jonthomasson/SpartanMini/rev1.d (with shield 3d)/Spartan6Dev2.png

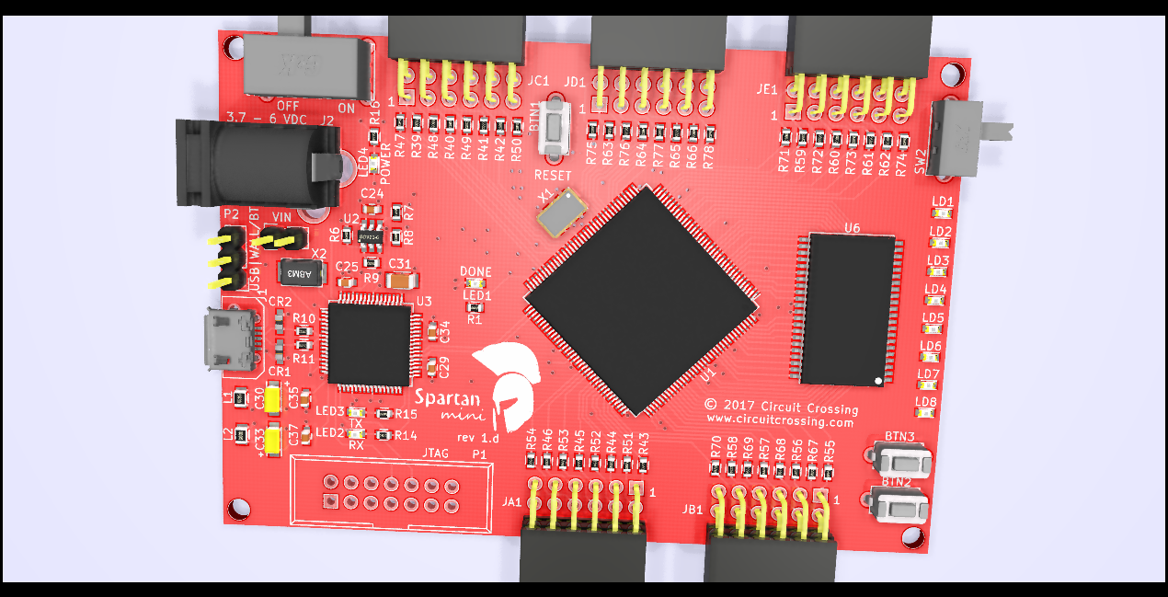
rev1.d (with shield 3d)/Spartan6Dev2.png
