jonthomasson/SpartanMini/rev1.d (with shield 3d)/SpartanMini1.png

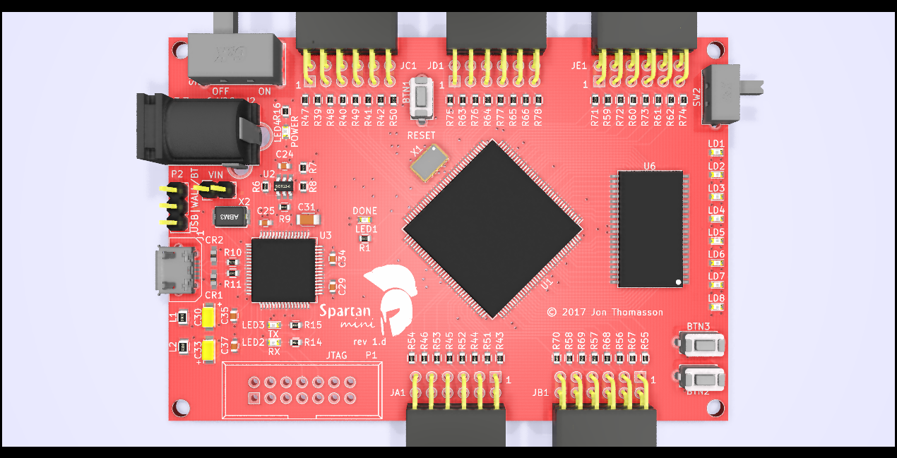
rev1.d (with shield 3d)/SpartanMini1.png
