jonthomasson/SpartanMini/rev1.d (with shield 3d)/Xilinx/NES/luddes_nes/luddes_nes/handyvgs2/loader/BISTio/README

BISTio Library
=======================

This library wraps the digilent ADEPT driver.  The goal is to have a a c++ dll that provides
a simple interface to boundary scan and a simple SPI.
