jonthomasson/SpartanMini/rev1.d (with shield 3d)/Xilinx/NES/luddes_nes/luddes_nes/handyvgs2/loader/BISTio/BISTio/README

A C++ DLL which provides an easy interface to performing JTAG operations using the Digilient adept driver
