jonthomasson/SpartanMini/rev1.d (with shield 3d)/usb/playtag-master/doc/digilent_hs2_connections.pdf

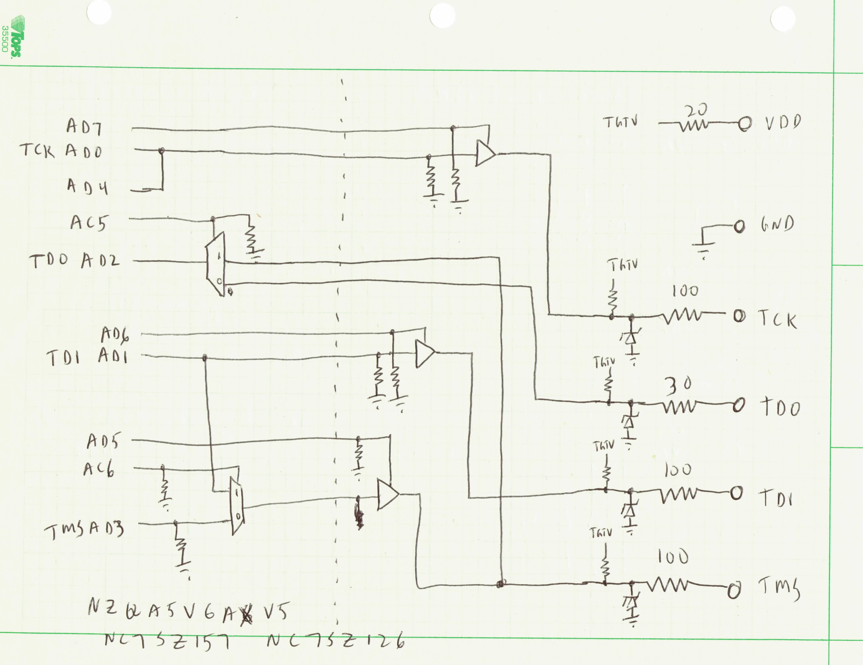
[picture p3: page 1]
