jonthomasson/SpartanMini/rev1.d (with shield 3d)/Spartan6DevWShield.png

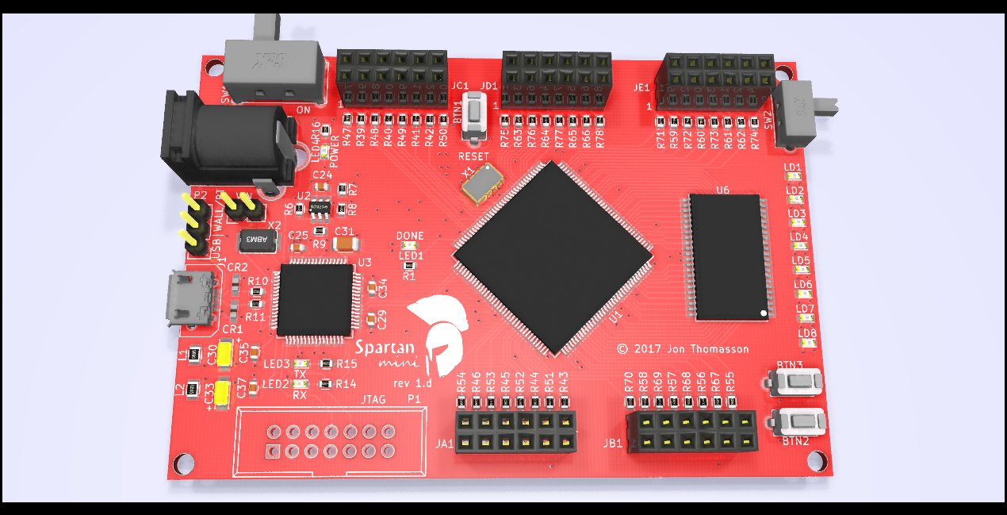
rev1.d (with shield 3d)/Spartan6DevWShield.png
