jonthomasson/SpartanMini/rev1.d (with shield 3d)/SpartanMini2.png

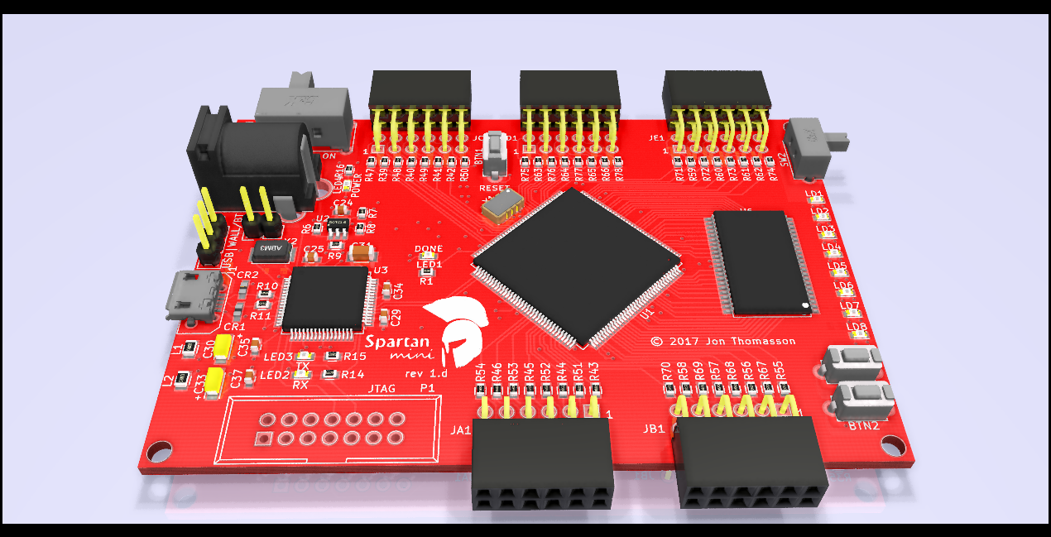
rev1.d (with shield 3d)/SpartanMini2.png
