jonthomasson/SpartanMini/rev1.d (with shield 3d)/SpartanMiniPcb.PNG

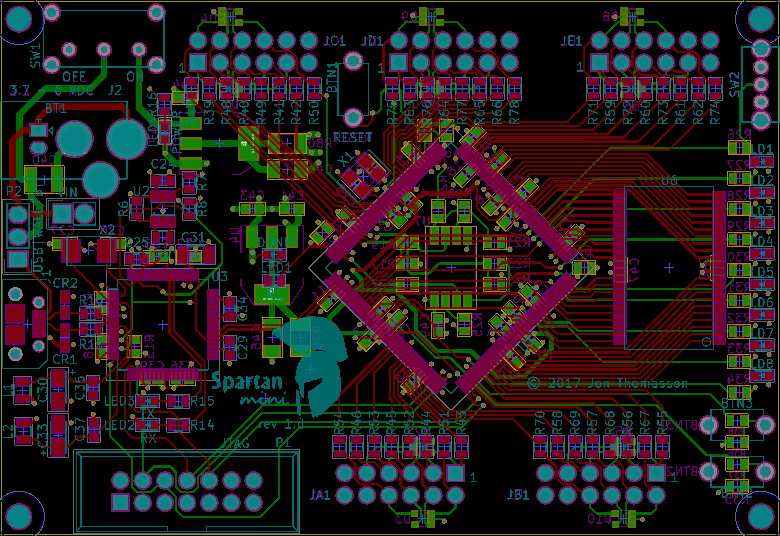
rev1.d (with shield 3d)/SpartanMiniPcb.PNG
