jonthomasson/SpartanMini/rev1.d/TemplateProject/spartanmini-shieldwpower/meta/brd.PNG

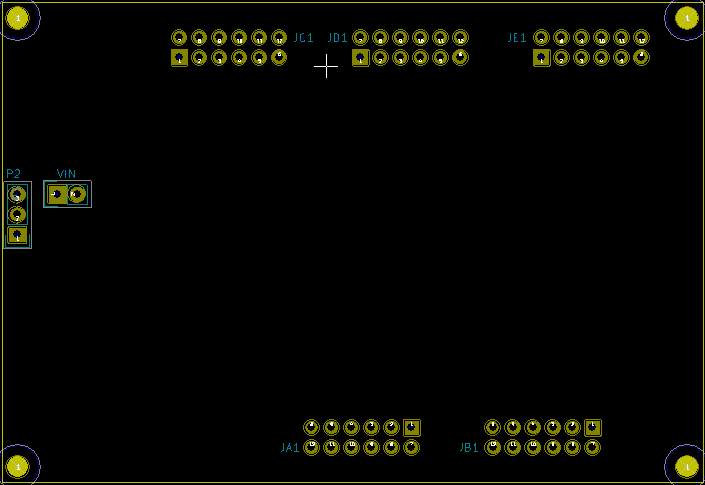
rev1.d/TemplateProject/spartanmini-shieldwpower/meta/brd.PNG
