jonthomasson/SpartanMini/rev1.d (with shield 3d)/3dmodels/IND_PGB_0603.stp

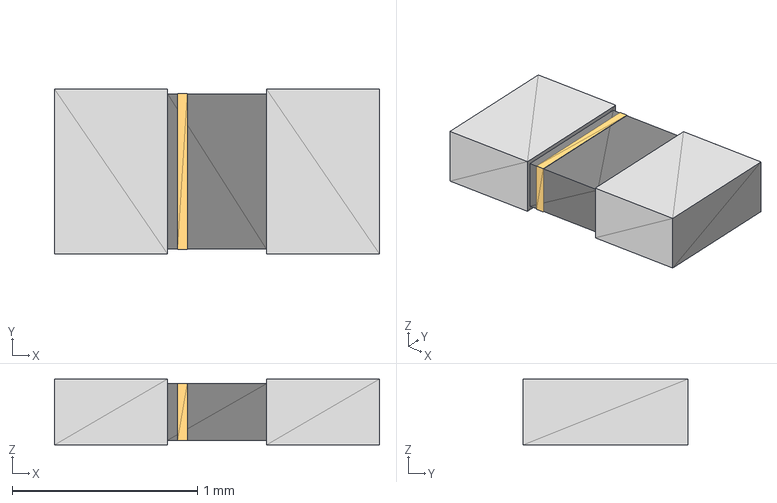
[picture p9: CAD file, 2017-04-20]
rev1.d (with shield 3d)/3dmodels/IND_PGB_0603.stp
1.75 x 0.889 x 0.356 mm
