jonthomasson/SpartanMini/rev1.d (with shield 3d)/3dmodels/abm3_rev2.stp

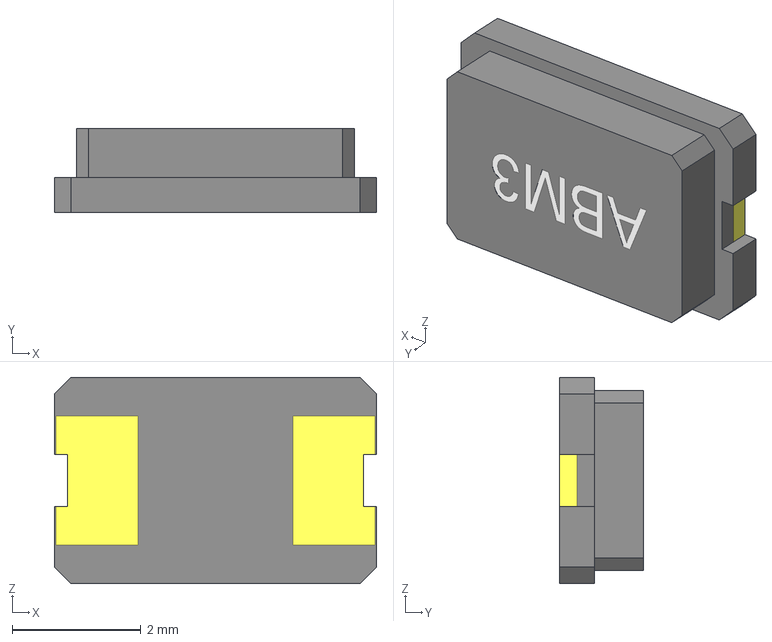
[picture p10: CAD file, 2017-04-20]
rev1.d (with shield 3d)/3dmodels/abm3_rev2.stp
5.00 x 1.30 x 3.20 mm
