jonthomasson/SpartanMini/rev1.d (with shield 3d)/3dmodels/500SSPxS2M2xEA.stp

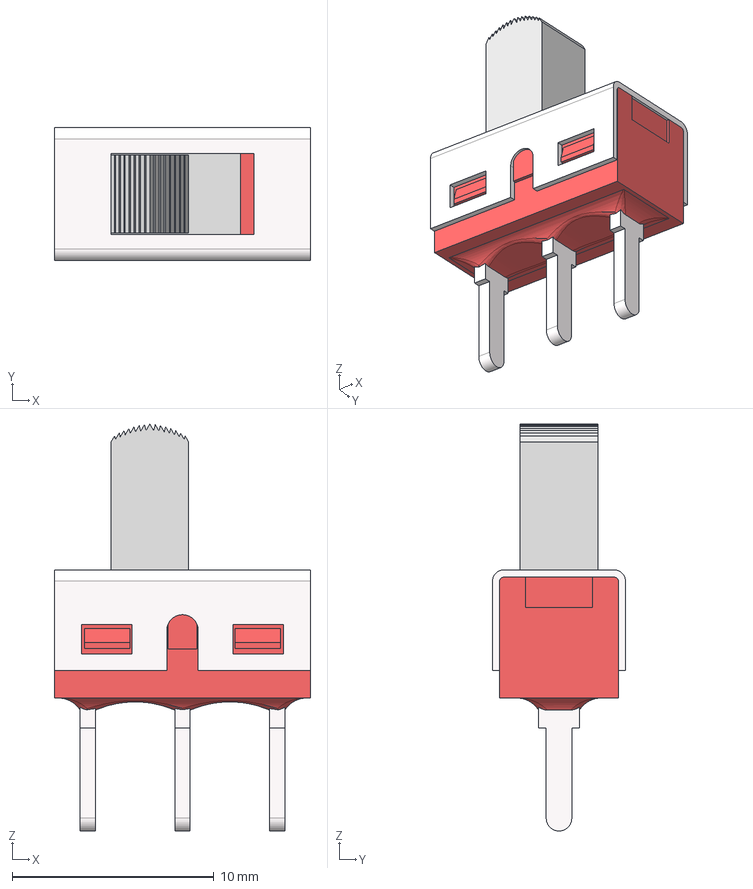
[picture p11: CAD file, 2017-04-20]
rev1.d (with shield 3d)/3dmodels/500SSPxS2M2xEA.stp
12.7 x 6.60 x 20.2 mm
500 SSP BODY
500 SSP COVER
500 ACTUATOR S2
500 SSP M2
