jonthomasson/SpartanMini/rev1.d (with shield 3d)/3dmodels/PTS810.stp

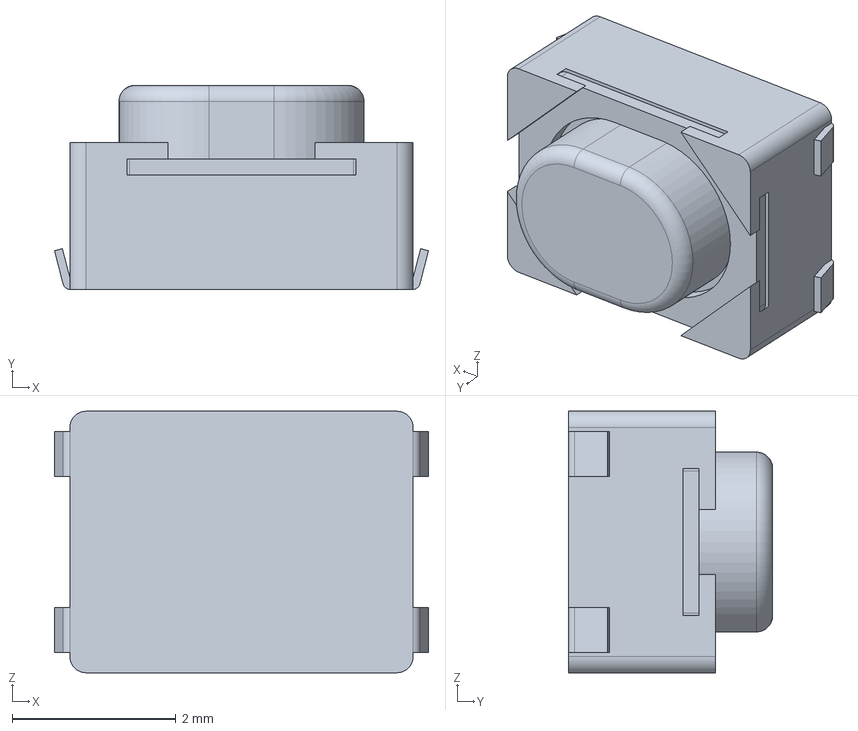
[picture p12: CAD file, 2017-04-20]
rev1.d (with shield 3d)/3dmodels/PTS810.stp
4.58 x 2.50 x 3.20 mm
