jonthomasson/SpartanMini/rev1.d (with shield 3d)/3dmodels/l102021ml04.stp

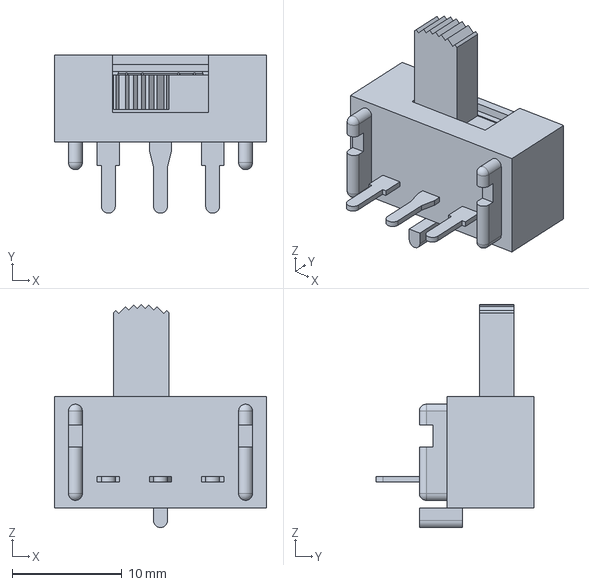
[picture p13: CAD file, 2017-04-20]
rev1.d (with shield 3d)/3dmodels/l102021ml04.stp
19.3 x 14.4 x 20.3 mm
