jonthomasson/SpartanMini/rev1.d (with shield 3d)/3dmodels/10118194c.stp

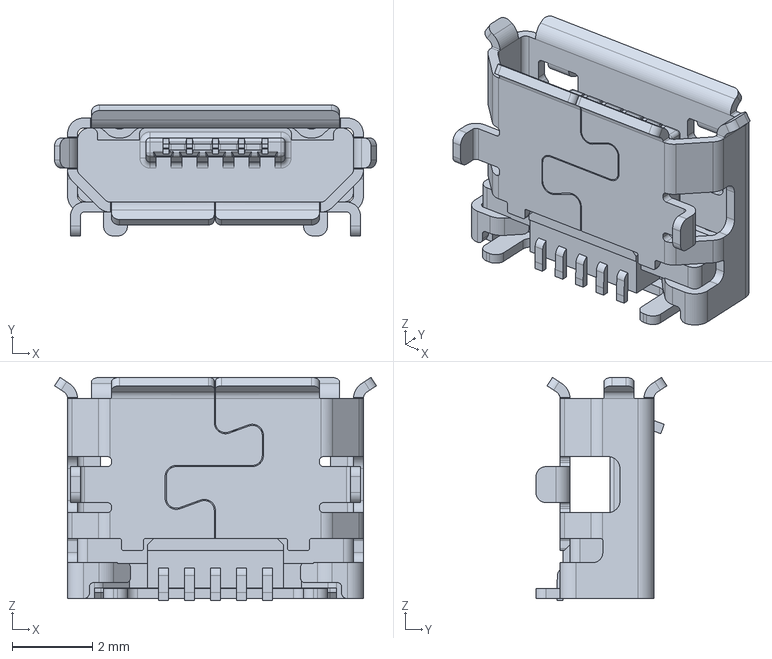
[picture p14: CAD file, 2017-04-20]
rev1.d (with shield 3d)/3dmodels/10118194c.stp
8.05 x 3.27 x 5.58 mm
