jonthomasson/SpartanMini/rev1.d (with shield 3d)/3dmodels/1825966-1.stp

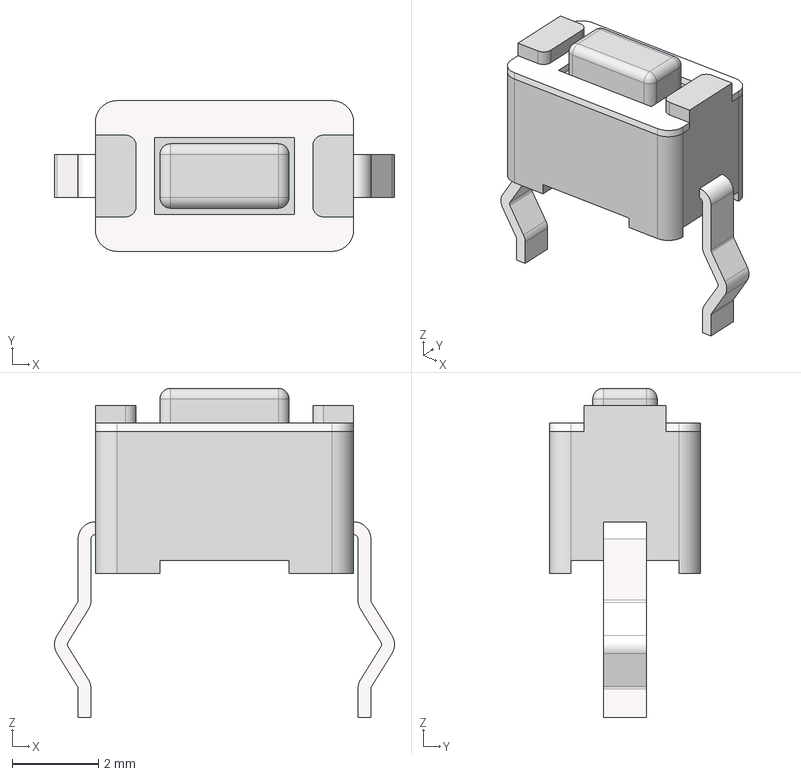
[picture p15: CAD file, 2017-04-20]
rev1.d (with shield 3d)/3dmodels/1825966-1.stp
7.90 x 3.50 x 7.65 mm
TL1107-3302 BODY
TL1107-3302 COVER
TL1107 W TERM
TL1107-3302 A ACTUATOR
TL1107 W TERM_MIR
