jonthomasson/SpartanMini/rev1.d (with shield 3d)/3dmodels/os102011ms2qn1_093011.stp

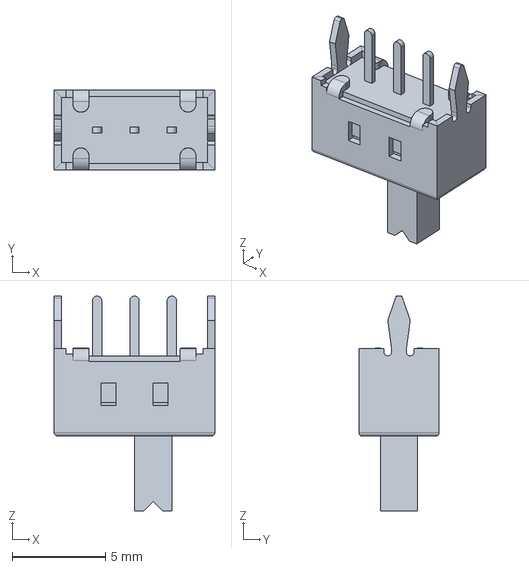
[picture p16: CAD file, 2017-04-20]
rev1.d (with shield 3d)/3dmodels/os102011ms2qn1_093011.stp
8.60 x 4.30 x 11.5 mm
