jonthomasson/SpartanMini/rev1.d (with shield 3d)/3dmodels/os102011ma1qn1_093011.stp

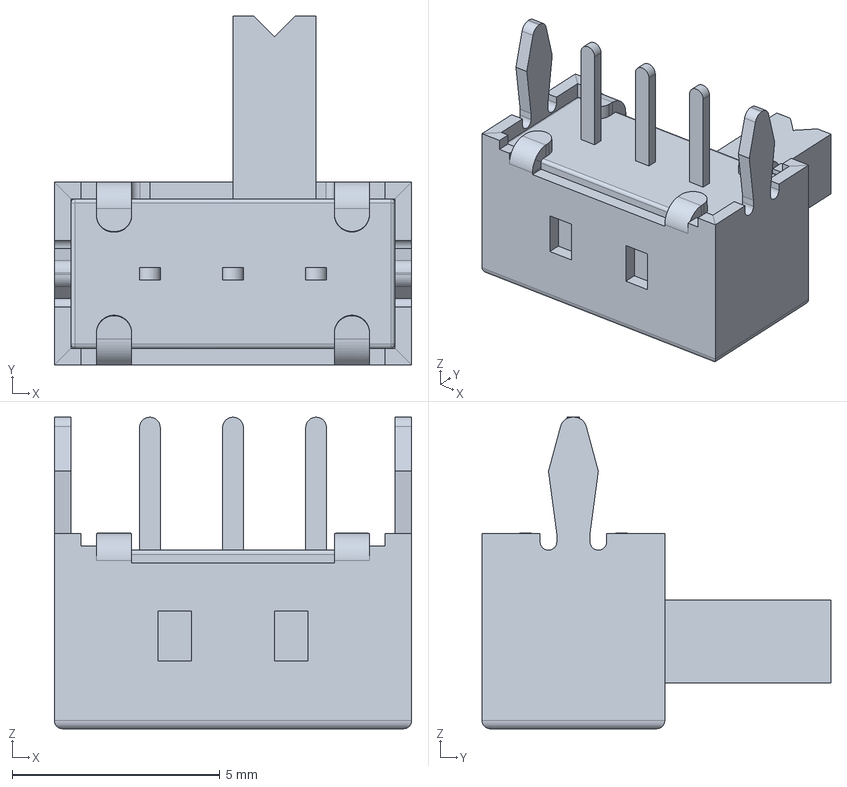
[picture p17: CAD file, 2017-04-20]
rev1.d (with shield 3d)/3dmodels/os102011ma1qn1_093011.stp
8.60 x 8.40 x 7.50 mm
