jonthomasson/SpartanMini/(list of files, cad)

Other CAD files:
rev1.d (with shield 3d)/3dmodels/ABM3.STEP
