jonthomasson/SpartanMini/rev1.d (with shield 3d)/Xilinx/blink_led/usage_statistics_webtalk.html

### Device Usage Page (usage_statistics_webtalk.html)

This HTML page displays the device usage statistics that will be sent to Xilinx.

Software Version and Target Device
Product Version: | ISE:14.7 (WebPack) - P.20131013 | Target Family: | Spartan6
OS Platform: | NT64 | Target Device: | xc6slx9
Project ID (random number) | 80e5f5d7cab04d32b9649c2cde710933.15AE8DC6CFC14A00AB5B0725C5DFFF0C.8 | Target Package: | tqg144
Registration ID | 211027110_0_0_178 | Target Speed: | -2
Date Generated | 2017-10-11T22:11:20 | Tool Flow | ISE

User Environment
OS Name | Microsoft Windows 7 , 64-bit | OS Release | Service Pack 1 (build 7601)
CPU Name | Intel(R) Core(TM)2 Duo CPU T8300 @ 2.40GHz | CPU Speed | 2394 MHz
OS Name | Microsoft Windows 7 , 64-bit | OS Release | Service Pack 1 (build 7601)
CPU Name | Intel(R) Core(TM)2 Duo CPU T8300 @ 2.40GHz | CPU Speed | 2394 MHz

Device Usage Statistics
Macro Statistics | Miscellaneous Statistics | Net Statistics | Site Usage

Counters=1

32-bit up counter=1

MiscellaneousStatistics

AGG_BONDED_IO=10

AGG_IO=10

AGG_LOCED_IO=10

AGG_SLICE=7

NUM_BONDED_IOB=10

NUM_BSFULL=25

NUM_BSUSED=25

NUM_BUFG=1

NUM_LOCED_IOB=10

NUM_LOGIC_O5ANDO6=1

NUM_LOGIC_O5ONLY=23

NUM_LUT_RT_DRIVES_CARRY4=1

NUM_LUT_RT_EXO6=1

NUM_LUT_RT_O6=23

NUM_SLICEL=7

NUM_SLICE_CARRY4=7

NUM_SLICE_CONTROLSET=1

NUM_SLICE_CYINIT=50

NUM_SLICE_FF=25

NUM_UNUSABLE_FF_BELS=7

NetStatistics

NumNets_Active=43

NumNets_Gnd=1

NumNets_Vcc=1

NumNodesOfType_Active_BOUNCEIN=6

NumNodesOfType_Active_BUFGOUT=1

NumNodesOfType_Active_BUFHINP2OUT=1

NumNodesOfType_Active_CLKPIN=7

NumNodesOfType_Active_CLKPINFEED=1

NumNodesOfType_Active_DOUBLE=2

NumNodesOfType_Active_GENERIC=2

NumNodesOfType_Active_GLOBAL=9

NumNodesOfType_Active_INPUT=7

NumNodesOfType_Active_IOBIN2OUT=1

NumNodesOfType_Active_IOBOUTPUT=1

NumNodesOfType_Active_LUTINPUT=25

NumNodesOfType_Active_OUTBOUND=25

NumNodesOfType_Active_OUTPUT=32

NumNodesOfType_Active_PADINPUT=1

NumNodesOfType_Active_PADOUTPUT=1

NumNodesOfType_Active_PINBOUNCE=6

NumNodesOfType_Active_PINFEED=34

NumNodesOfType_Active_QUAD=3

SiteStatistics

BUFG-BUFGMUX=1

IOB-IOBM=5

IOB-IOBS=5

SiteSummary

BUFG=1

BUFG_BUFG=1

CARRY4=7

HARD0=1

IOB=10

IOB_IMUX=1

IOB_INBUF=1

IOB_OUTBUF=9

LUT5=24

LUT6=25

PAD=10

REG_SR=25

SLICEL=7

Configuration Data
IOB_OUTBUF DRIVEATTRBOX=[12:9] SLEW=[SLOW:9] SUSPEND=[3STATE:9] | REG_SR CK=[CK:25] [CK_INV:0] LATCH_OR_FF=[FF:25] SRINIT=[SRINIT0:25] SYNC_ATTR=[ASYNC:25] | SLICEL CLK=[CLK:7] [CLK_INV:0]

Pin Data
BUFG I0=1 O=1 BUFG_BUFG I0=1 O=1 CARRY4 CIN=6 CO3=6 CYINIT=1 DI0=6 DI1=6 DI2=6 DI3=6 O0=7 O1=6 O2=6 O3=6 S0=7 S1=6 S2=6 S3=6 | HARD0 0=1 IOB I=1 O=9 PAD=10 IOB_IMUX I=1 OUT=1 IOB_INBUF OUT=1 PAD=1 IOB_OUTBUF IN=9 OUT=9 LUT5 O5=24 LUT6 A4=25 A6=24 O6=25 | PAD PAD=10 REG_SR CK=25 D=25 Q=25 SLICEL A4=7 A6=6 AQ=7 B4=6 B6=6 BQ=6 C4=6 C6=6 CIN=6 CLK=7 COUT=6 CQ=6 D4=6 D6=6 DQ=6

Tool Usage

Command Line History

xst -intstyle ise -filter <ise_file>

ngdbuild -filter <ise_file> -intstyle ise -dd _ngo -nt timestamp -i -p xc6slx9-tqg144-2 <fname>.ngc <fname>.ngd

ngdbuild -filter <ise_file> -intstyle ise -dd _ngo -nt timestamp -i -p xc6slx9-tqg144-2 <fname>.ngc <fname>.ngd

xst -intstyle ise -filter <ise_file>

xst -intstyle ise -filter <ise_file>

ngdbuild -filter <ise_file> -intstyle ise -dd _ngo -nt timestamp -i -p xc6slx9-tqg144-2 <fname>.ngc <fname>.ngd

map -filter <ise_file> -intstyle ise -p xc6slx9-tqg144-2 -w -logic_opt off -ol high -t 1 -xt 0 -register_duplication off -r 4 -global_opt off -mt off -ir off -pr off -lc off -power off -o <fname>.ncd <fname>.ngd <fname>.pcf

par -filter <ise_file> -w -intstyle ise -ol high -mt off <fname>.ncd <fname>.ncd <fname>.pcf

trce -filter <fname>.filter -intstyle ise -v 3 -s 2 -n 3 -fastpaths -xml <fname>.twx <fname>.ncd -o <fname>.twr <fname>.pcf

bitgen -filter <ise_file> -intstyle ise -f <fname>.ut <fname>.ncd

xst -intstyle ise -filter <ise_file>

ngdbuild -filter <ise_file> -intstyle ise -dd _ngo -nt timestamp -uc <fname>.ucf -p xc6slx9-tqg144-2 <fname>.ngc <fname>.ngd

map -filter <ise_file> -intstyle ise -p xc6slx9-tqg144-2 -w -logic_opt off -ol high -t 1 -xt 0 -register_duplication off -r 4 -global_opt off -mt off -ir off -pr off -lc off -power off -o <fname>.ncd <fname>.ngd <fname>.pcf

par -filter <ise_file> -w -intstyle ise -ol high -mt off <fname>.ncd <fname>.ncd <fname>.pcf

trce -filter <fname>.filter -intstyle ise -v 3 -s 2 -n 3 -fastpaths -xml <fname>.twx <fname>.ncd -o <fname>.twr <fname>.pcf -ucf <fname>.ucf

bitgen -filter <ise_file> -intstyle ise -f <fname>.ut <fname>.ncd

xst -intstyle ise -filter <ise_file>

ngdbuild -filter <ise_file> -intstyle ise -dd _ngo -nt timestamp -uc <fname>.ucf -p xc6slx9-tqg144-2 <fname>.ngc <fname>.ngd

map -filter <ise_file> -intstyle ise -p xc6slx9-tqg144-2 -w -logic_opt off -ol high -t 1 -xt 0 -register_duplication off -r 4 -global_opt off -mt off -ir off -pr off -lc off -power off -o <fname>.ncd <fname>.ngd <fname>.pcf

par -filter <ise_file> -w -intstyle ise -ol high -mt off <fname>.ncd <fname>.ncd <fname>.pcf

trce -filter <fname>.filter -intstyle ise -v 3 -s 2 -n 3 -fastpaths -xml <fname>.twx <fname>.ncd -o <fname>.twr <fname>.pcf -ucf <fname>.ucf

bitgen -filter <ise_file> -intstyle ise -f <fname>.ut <fname>.ncd

xst -intstyle ise -filter <ise_file>

ngdbuild -filter <ise_file> -intstyle ise -dd _ngo -nt timestamp -uc <fname>.ucf -p xc6slx9-tqg144-2 <fname>.ngc <fname>.ngd

map -filter <ise_file> -intstyle ise -p xc6slx9-tqg144-2 -w -logic_opt off -ol high -t 1 -xt 0 -register_duplication off -r 4 -global_opt off -mt off -ir off -pr off -lc off -power off -o <fname>.ncd <fname>.ngd <fname>.pcf

par -filter <ise_file> -w -intstyle ise -ol high -mt off <fname>.ncd <fname>.ncd <fname>.pcf

trce -filter <fname>.filter -intstyle ise -v 3 -s 2 -n 3 -fastpaths -xml <fname>.twx <fname>.ncd -o <fname>.twr <fname>.pcf -ucf <fname>.ucf

bitgen -filter <ise_file> -intstyle ise -f <fname>.ut <fname>.ncd

bitgen -filter <ise_file> -intstyle ise -f <fname>.ut <fname>.ncd

xst -intstyle ise -filter <ise_file>

ngdbuild -filter <ise_file> -intstyle ise -dd _ngo -nt timestamp -uc <fname>.ucf -p xc6slx9-tqg144-2 <fname>.ngc <fname>.ngd

map -filter <ise_file> -intstyle ise -p xc6slx9-tqg144-2 -w -logic_opt off -ol high -t 1 -xt 0 -register_duplication off -r 4 -global_opt off -mt off -ir off -pr off -lc off -power off -o <fname>.ncd <fname>.ngd <fname>.pcf

par -filter <ise_file> -w -intstyle ise -ol high -mt off <fname>.ncd <fname>.ncd <fname>.pcf

trce -filter <fname>.filter -intstyle ise -v 3 -s 2 -n 3 -fastpaths -xml <fname>.twx <fname>.ncd -o <fname>.twr <fname>.pcf -ucf <fname>.ucf

bitgen -filter <ise_file> -intstyle ise -f <fname>.ut <fname>.ncd

xst -intstyle ise -filter <ise_file>

ngdbuild -filter <ise_file> -intstyle ise -dd _ngo -nt timestamp -uc <fname>.ucf -p xc6slx9-tqg144-2 <fname>.ngc <fname>.ngd

map -filter <ise_file> -intstyle ise -p xc6slx9-tqg144-2 -w -logic_opt off -ol high -t 1 -xt 0 -register_duplication off -r 4 -global_opt off -mt off -ir off -pr off -lc off -power off -o <fname>.ncd <fname>.ngd <fname>.pcf

par -filter <ise_file> -w -intstyle ise -ol high -mt off <fname>.ncd <fname>.ncd <fname>.pcf

trce -filter <fname>.filter -intstyle ise -v 3 -s 2 -n 3 -fastpaths -xml <fname>.twx <fname>.ncd -o <fname>.twr <fname>.pcf -ucf <fname>.ucf

bitgen -filter <ise_file> -intstyle ise -f <fname>.ut <fname>.ncd

xst -intstyle ise -filter <ise_file>

ngdbuild -filter <ise_file> -intstyle ise -dd _ngo -nt timestamp -uc <fname>.ucf -p xc6slx9-tqg144-2 <fname>.ngc <fname>.ngd

map -filter <ise_file> -intstyle ise -p xc6slx9-tqg144-2 -w -logic_opt off -ol high -t 1 -xt 0 -register_duplication off -r 4 -global_opt off -mt off -ir off -pr off -lc off -power off -o <fname>.ncd <fname>.ngd <fname>.pcf

par -filter <ise_file> -w -intstyle ise -ol high -mt off <fname>.ncd <fname>.ncd <fname>.pcf

trce -filter <fname>.filter -intstyle ise -v 3 -s 2 -n 3 -fastpaths -xml <fname>.twx <fname>.ncd -o <fname>.twr <fname>.pcf -ucf <fname>.ucf

bitgen -filter <ise_file> -intstyle ise -f <fname>.ut <fname>.ncd

xst -intstyle ise -filter <ise_file>

ngdbuild -filter <ise_file> -intstyle ise -dd _ngo -nt timestamp -uc <fname>.ucf -p xc6slx9-tqg144-2 <fname>.ngc <fname>.ngd

map -filter <ise_file> -intstyle ise -p xc6slx9-tqg144-2 -w -logic_opt off -ol high -t 1 -xt 0 -register_duplication off -r 4 -global_opt off -mt off -ir off -pr off -lc off -power off -o <fname>.ncd <fname>.ngd <fname>.pcf

par -filter <ise_file> -w -intstyle ise -ol high -mt off <fname>.ncd <fname>.ncd <fname>.pcf

trce -filter <fname>.filter -intstyle ise -v 3 -s 2 -n 3 -fastpaths -xml <fname>.twx <fname>.ncd -o <fname>.twr <fname>.pcf -ucf <fname>.ucf

bitgen -filter <ise_file> -intstyle ise -f <fname>.ut <fname>.ncd

Software Quality
Run Statistics
Program Name | Runs Started | Runs Finished | Errors | Fatal Errors | Internal Errors | Exceptions | Core Dumps
_impact | 297 | 239 | 0 | 0 | 0 | 0 | 0
bitgen | 617 | 614 | 0 | 0 | 0 | 0 | 0
cse_server | 1 | 1 | 0 | 0 | 0 | 0 | 0
elfcheck | 48 | 48 | 0 | 0 | 0 | 0 | 0
libgen | 1 | 1 | 0 | 0 | 0 | 0 | 0
map | 628 | 598 | 0 | 0 | 0 | 0 | 0
netgen | 9 | 9 | 0 | 0 | 0 | 0 | 0
ngcbuild | 15 | 15 | 0 | 0 | 0 | 0 | 0
ngdbuild | 665 | 663 | 0 | 0 | 0 | 0 | 0
par | 598 | 598 | 0 | 0 | 0 | 0 | 0
trce | 592 | 592 | 0 | 0 | 0 | 0 | 0
xps | 1 | 1 | 0 | 0 | 0 | 0 | 0
xst | 906 | 895 | 0 | 0 | 0 | 0 | 0

Help Statistics
Help files
/doc/usenglish/isehelp/cgn_c_cust_gui_overview.htm ( 1 ) | /doc/usenglish/isehelp/ise_r_source_types.htm ( 1 )
/doc/usenglish/isehelp/pn_db_nsw_define_hdl_module.htm ( 1 ) | /doc/usenglish/isehelp/pn_db_nsw_select_source_type.htm ( 1 )

Project Statistics
PROP_Enable_Message_Filtering=true | PROP_FitterReportFormat=HTML
PROP_LastAppliedGoal=Balanced | PROP_LastAppliedStrategy=Xilinx Default (unlocked)
PROP_ManualCompileOrderImp=false | PROP_ProjectDescription=blink one of the onboard leds.
PROP_PropSpecInProjFile=Store all values | PROP_Simulator=ISim (VHDL/Verilog)
PROP_SynthTopFile=changed | PROP_Top_Level_Module_Type=HDL
PROP_UseSmartGuide=false | PROP_UserConstraintEditorPreference=Text Editor
PROP_intProjectCreationTimestamp=2017-10-10T13:54:07 | PROP_intWbtProjectID=15AE8DC6CFC14A00AB5B0725C5DFFF0C
PROP_intWbtProjectIteration=8 | PROP_intWorkingDirLocWRTProjDir=Same
PROP_intWorkingDirUsed=No | PROP_lockPinsUcfFile=changed
PROP_xilxBitgCfg_SpiBusWidth_spartan6=4 | PROP_xilxBitgStart_IntDone=true
PROP_AutoTop=true | PROP_DevFamily=Spartan6
PROP_DevDevice=xc6slx9 | PROP_DevFamilyPMName=spartan6
PROP_DevPackage=tqg144 | PROP_Synthesis_Tool=XST (VHDL/Verilog)
PROP_DevSpeed=-2 | PROP_PreferredLanguage=Verilog
FILE_UCF=1 | FILE_VERILOG=1

Unisim Statistics
NGDBUILD_PRE_UNISIM_SUMMARY
NGDBUILD_NUM_BUFGP=1 | NGDBUILD_NUM_FD=25 | NGDBUILD_NUM_GND=1 | NGDBUILD_NUM_INV=1
NGDBUILD_NUM_LUT1=24 | NGDBUILD_NUM_MUXCY=24 | NGDBUILD_NUM_OBUF=9 | NGDBUILD_NUM_VCC=1

NGDBUILD_NUM_XORCY=25
NGDBUILD_POST_UNISIM_SUMMARY
NGDBUILD_NUM_BUFG=1 | NGDBUILD_NUM_FD=25 | NGDBUILD_NUM_GND=1 | NGDBUILD_NUM_IBUFG=1
NGDBUILD_NUM_INV=1 | NGDBUILD_NUM_LUT1=24 | NGDBUILD_NUM_MUXCY=24 | NGDBUILD_NUM_OBUF=9
NGDBUILD_NUM_TS_TIMESPEC=1 | NGDBUILD_NUM_VCC=1 | NGDBUILD_NUM_XORCY=25

XST Command Line Options
XST_OPTION_SUMMARY
-ifn=<fname>.prj | -ofn=<design_top> | -ofmt=NGC | -p=xc6slx9-2-tqg144
-top=<design_top> | -opt_mode=Speed | -opt_level=1 | -power=NO
-iuc=NO | -keep_hierarchy=No | -netlist_hierarchy=As_Optimized | -rtlview=Yes
-glob_opt=AllClockNets | -read_cores=YES | -write_timing_constraints=NO | -cross_clock_analysis=NO
-bus_delimiter=<> | -slice_utilization_ratio=100 | -bram_utilization_ratio=100 | -dsp_utilization_ratio=100
-reduce_control_sets=Auto | -fsm_extract=YES | -fsm_encoding=Auto | -safe_implementation=No
-fsm_style=LUT | -ram_extract=Yes | -ram_style=Auto | -rom_extract=Yes
-shreg_extract=YES | -rom_style=Auto | -auto_bram_packing=NO | -resource_sharing=YES
-async_to_sync=NO | -use_dsp48=Auto | -iobuf=YES | -max_fanout=100000
-bufg=16 | -register_duplication=YES | -register_balancing=No | -optimize_primitives=NO
-use_clock_enable=Auto | -use_sync_set=Auto | -use_sync_reset=Auto | -iob=Auto
-equivalent_register_removal=YES | -slice_utilization_ratio_maxmargin=5
