jonthomasson/SpartanMini/rev1.d (with shield 3d)/Xilinx/blink_led/par_usage_statistics.html

Par Statistics

Total Non-vccgnd Signals=33

Total Non-vccgnd Design Pins=40

Total Non-vccgnd Conns=40

Total Non-vccgnd Timing Constrained Conns=39

Phase 1 CPU=5.0 sec

Phase 2 CPU=5.1 sec

Phase 3 CPU=5.1 sec

Phase 4 CPU=5.7 sec

Phase 5 CPU=5.8 sec

Phase 6 CPU=5.8 sec

Phase 7 CPU=5.8 sec

Phase 8 CPU=5.8 sec

Phase 9 CPU=5.8 sec

Phase 10 CPU=5.8 sec

AvgWirelenPerPin Fanout 1=1.0

AvgWirelenPerPin Fanout 2=7.5

AvgWirelenPerPin Fanout 3=0.0

AvgWirelenPerPin Fanout 4=0.0

AvgWirelenPerPin Fanout 10=9.8

AvgWirelenPerPin Fanout 50=0.0

AvgWirelenPerPin Fanout 100=0.0

AvgWirelenPerPin Fanout 500=0.0

AvgWirelenPerPin Fanout 5000=0.0

AvgWirelenPerPin Fanout 20000=0.0

AvgWirelenPerPin Fanout 50000=0.0

AvgWirelenPerPin Fanout 100000=0.0

IRR Gamma=1.0000
