jonthomasson/SpartanMini/rev1.d (with shield 3d)/Xilinx/pong_text/par_usage_statistics.html

Par Statistics

Total Non-vccgnd Signals=303

Total Non-vccgnd Design Pins=1389

Total Non-vccgnd Conns=1389

Total Non-vccgnd Timing Constrained Conns=44

Phase 1 CPU=5.2 sec

Phase 2 CPU=5.6 sec

Phase 3 CPU=6.1 sec

Phase 4 CPU=6.7 sec

Phase 5 CPU=7.2 sec

Phase 6 CPU=7.2 sec

Phase 7 CPU=7.2 sec

Phase 8 CPU=7.2 sec

Phase 9 CPU=7.2 sec

Phase 10 CPU=7.2 sec

AvgWirelenPerPin Fanout 1=3.0

AvgWirelenPerPin Fanout 2=1.0

AvgWirelenPerPin Fanout 3=3.0

AvgWirelenPerPin Fanout 4=4.3

AvgWirelenPerPin Fanout 10=4.0

AvgWirelenPerPin Fanout 50=2.9

AvgWirelenPerPin Fanout 100=0.0

AvgWirelenPerPin Fanout 500=0.0

AvgWirelenPerPin Fanout 5000=0.0

AvgWirelenPerPin Fanout 20000=0.0

AvgWirelenPerPin Fanout 50000=0.0

AvgWirelenPerPin Fanout 100000=0.0

IRR Gamma=1.1356
