jonthomasson/SpartanMini/rev1.d (with shield 3d)/Xilinx/pong_text/usage_statistics_webtalk.html

### Device Usage Page (usage_statistics_webtalk.html)

This HTML page displays the device usage statistics that will be sent to Xilinx.

Software Version and Target Device
Product Version: | ISE:14.7 (WebPack) - P.20131013 | Target Family: | Spartan6
OS Platform: | NT64 | Target Device: | xc6slx9
Project ID (random number) | 80e5f5d7cab04d32b9649c2cde710933.64A098AA588B4832964EF4F8E0BE5300.2 | Target Package: | tqg144
Registration ID | 211027110_0_0_178 | Target Speed: | -3
Date Generated | 2017-10-13T16:15:29 | Tool Flow | ISE

User Environment
OS Name | Microsoft Windows 7 , 64-bit | OS Release | Service Pack 1 (build 7601)
CPU Name | Intel(R) Core(TM)2 Duo CPU T8300 @ 2.40GHz | CPU Speed | 2394 MHz
OS Name | Microsoft Windows 7 , 64-bit | OS Release | Service Pack 1 (build 7601)
CPU Name | Intel(R) Core(TM)2 Duo CPU T8300 @ 2.40GHz | CPU Speed | 2394 MHz

Device Usage Statistics
Macro Statistics | Miscellaneous Statistics | Net Statistics | Site Usage

Adders/Subtractors=14

10-bit adder=3

10-bit addsub=1

10-bit subtractor=3

11-bit adder=2

2-bit subtractor=1

3-bit subtractor=2

4-bit adder=2

Comparators=31

10-bit comparator greater=8

10-bit comparator lessequal=18

4-bit comparator lessequal=2

5-bit comparator lessequal=2

6-bit comparator greater=1

Counters=4

1-bit up counter=1

10-bit up counter=2

7-bit down counter=1

FSMs=1 Multiplexers=46

1-bit 2-to-1 multiplexer=19

1-bit 8-to-1 multiplexer=1

10-bit 2-to-1 multiplexer=3

11-bit 2-to-1 multiplexer=3

2-bit 2-to-1 multiplexer=2

3-bit 2-to-1 multiplexer=12

32-bit 2-to-1 multiplexer=2

4-bit 2-to-1 multiplexer=4

RAMs=2

2048x8-bit single-port block Read Only RAM=1

64x5-bit single-port distributed Read Only RAM=1

Registers=66

Flip-Flops=66

MiscellaneousStatistics

AGG_BONDED_IO=9

AGG_IO=9

AGG_LOCED_IO=9

AGG_SLICE=115

NUM_BONDED_IOB=9

NUM_BSFULL=64

NUM_BSLUTONLY=209

NUM_BSREGONLY=3

NUM_BSUSED=276

NUM_BUFG=2

NUM_LOCED_IOB=9

NUM_LOGIC_O5ANDO6=78

NUM_LOGIC_O5ONLY=2

NUM_LOGIC_O6ONLY=193

NUM_LUT_RT_O6=2

NUM_RAMB16BWER=1

NUM_SLICEL=29

NUM_SLICEX=86

NUM_SLICE_CARRY4=20

NUM_SLICE_CONTROLSET=12

NUM_SLICE_CYINIT=363

NUM_SLICE_F7MUX=9

NUM_SLICE_FF=77

NUM_SLICE_UNUSEDCTRL=85

NUM_UNUSABLE_FF_BELS=59

NetStatistics

NumNets_Active=312

NumNets_Gnd=1

NumNets_Vcc=1

NumNodesOfType_Active_BOUNCEACROSS=2

NumNodesOfType_Active_BOUNCEIN=52

NumNodesOfType_Active_BUFGOUT=2

NumNodesOfType_Active_BUFHINP2OUT=8

NumNodesOfType_Active_CLKPIN=30

NumNodesOfType_Active_CLKPINFEED=12

NumNodesOfType_Active_CNTRLPIN=49

NumNodesOfType_Active_DOUBLE=552

NumNodesOfType_Active_GENERIC=12

NumNodesOfType_Active_GLOBAL=37

NumNodesOfType_Active_INPUT=22

NumNodesOfType_Active_IOBIN2OUT=8

NumNodesOfType_Active_IOBOUTPUT=8

NumNodesOfType_Active_LUTINPUT=1252

NumNodesOfType_Active_OUTBOUND=311

NumNodesOfType_Active_OUTPUT=319

NumNodesOfType_Active_PADINPUT=5

NumNodesOfType_Active_PADOUTPUT=4

NumNodesOfType_Active_PINBOUNCE=144

NumNodesOfType_Active_PINFEED=1330

NumNodesOfType_Active_QUAD=319

NumNodesOfType_Active_REGINPUT=31

NumNodesOfType_Active_SINGLE=677

NumNodesOfType_Gnd_BOUNCEIN=9

NumNodesOfType_Gnd_HGNDOUT=6

NumNodesOfType_Gnd_INPUT=15

NumNodesOfType_Gnd_PINBOUNCE=13

NumNodesOfType_Gnd_PINFEED=12

NumNodesOfType_Gnd_REGINPUT=5

NumNodesOfType_Vcc_HVCCOUT=34

NumNodesOfType_Vcc_INPUT=1

NumNodesOfType_Vcc_KVCCOUT=2

NumNodesOfType_Vcc_LUTINPUT=80

NumNodesOfType_Vcc_PINBOUNCE=2

NumNodesOfType_Vcc_PINFEED=81

NumNodesOfType_Vcc_REGINPUT=2

SiteStatistics

BUFG-BUFGMUX=2

IOB-IOBM=3

IOB-IOBS=6

SLICEL-SLICEM=9

SLICEX-SLICEL=13

SLICEX-SLICEM=23

SiteSummary

BUFG=2

BUFG_BUFG=2

CARRY4=20

FF_SR=12

HARD0=2

HARD1=8

IOB=9

IOB_IMUX=4

IOB_INBUF=4

IOB_OUTBUF=5

LUT5=80

LUT6=273

PAD=9

RAMB16BWER=1

RAMB16BWER_RAMB16BWER=1

REG_SR=65

SELMUX2_1=9

SLICEL=29

SLICEX=86

Configuration Data
FF_SR CK=[CK:12] [CK_INV:0] SRINIT=[SRINIT0:12] SYNC_ATTR=[ASYNC:12] IOB_OUTBUF DRIVEATTRBOX=[12:5] SLEW=[SLOW:5] SUSPEND=[3STATE:5] RAMB16BWER CLKA=[CLKA_INV:0] [CLKA:1] ENA=[ENA_INV:0] [ENA:1] REGCEA=[REGCEA_INV:0] [REGCEA:1] RSTA=[RSTA:1] [RSTA_INV:0] WEA0=[WEA0:1] [WEA0_INV:0] WEA1=[WEA1:1] [WEA1_INV:0] WEA2=[WEA2:1] [WEA2_INV:0] WEA3=[WEA3_INV:0] [WEA3:1] | RAMB16BWER_RAMB16BWER CLKA=[CLKA_INV:0] [CLKA:1] DATA_WIDTH_A=[9:1] DATA_WIDTH_B=[0:1] DOA_REG=[0:1] DOB_REG=[0:1] ENA=[ENA_INV:0] [ENA:1] EN_RSTRAM_A=[TRUE:1] EN_RSTRAM_B=[TRUE:1] RAM_MODE=[TDP:1] REGCEA=[REGCEA_INV:0] [REGCEA:1] RSTA=[RSTA:1] [RSTA_INV:0] RSTTYPE=[SYNC:1] RST_PRIORITY_A=[CE:1] RST_PRIORITY_B=[CE:1] WEA0=[WEA0:1] [WEA0_INV:0] WEA1=[WEA1:1] [WEA1_INV:0] WEA2=[WEA2:1] [WEA2_INV:0] WEA3=[WEA3_INV:0] [WEA3:1] WRITE_MODE_A=[WRITE_FIRST:1] WRITE_MODE_B=[WRITE_FIRST:1] | REG_SR CK=[CK:65] [CK_INV:0] LATCH_OR_FF=[FF:65] SRINIT=[SRINIT0:56] [SRINIT1:9] SYNC_ATTR=[ASYNC:65] SLICEL CLK=[CLK:8] [CLK_INV:0] SLICEX CLK=[CLK:22] [CLK_INV:0]

Pin Data

BUFG

I0=2

O=2

BUFG_BUFG

I0=2

O=2

CARRY4

CIN=8

CO3=16

CYINIT=12

DI0=18

DI1=16

DI2=16

DI3=16

O0=12

O1=10

O2=8

O3=8

S0=20

S1=18

S2=16

S3=16

FF_SR

CE=11

CK=12

D=12

Q=12

SR=12

HARD0

0=2

HARD1

1=8

IOB

I=4

O=5

PAD=9

IOB_IMUX

I=4

OUT=4

IOB_INBUF

OUT=4

PAD=4

IOB_OUTBUF

IN=5

OUT=5

LUT5

A1=15

A2=57

A3=58

A4=59

A5=54

O5=80

LUT6

A1=111

A2=182

A3=216

A4=250

A5=267

A6=270

O6=273

PAD

PAD=9

RAMB16BWER

ADDRA10=1

ADDRA11=1

ADDRA12=1

ADDRA13=1

ADDRA3=1

ADDRA4=1

ADDRA5=1

ADDRA6=1

ADDRA7=1

ADDRA8=1

ADDRA9=1

CLKA=1

DIA0=1

DIA1=1

DIA2=1

DIA3=1

DIA4=1

DIA5=1

DIA6=1

DIA7=1

DIPA0=1

DOA0=1

DOA1=1

DOA2=1

DOA3=1

DOA4=1

DOA5=1

DOA6=1

DOA7=1

ENA=1

REGCEA=1

RSTA=1

WEA0=1

WEA1=1

WEA2=1

WEA3=1

RAMB16BWER_RAMB16BWER

ADDRA10=1

ADDRA11=1

ADDRA12=1

ADDRA13=1

ADDRA3=1

ADDRA4=1

ADDRA5=1

ADDRA6=1

ADDRA7=1

ADDRA8=1

ADDRA9=1

CLKA=1

DIA0=1

DIA1=1

DIA2=1

DIA3=1

DIA4=1

DIA5=1

DIA6=1

DIA7=1

DIPA0=1

DOA0=1

DOA1=1

DOA2=1

DOA3=1

DOA4=1

DOA5=1

DOA6=1

DOA7=1

ENA=1

REGCEA=1

RSTA=1

WEA0=1

WEA1=1

WEA2=1

WEA3=1

REG_SR

CE=47

CK=65

D=65

Q=65

SR=64

SELMUX2_1

0=9

1=9

OUT=9

S0=9

SLICEL

A=1

A1=3

A2=5

A3=9

A4=15

A5=20

A6=21

AMUX=6

AQ=6

AX=8

B=4

B1=5

B2=15

B3=15

B4=19

B5=21

B6=23

BMUX=4

BQ=7

BX=5

C1=7

C2=17

C3=18

C4=20

C5=24

C6=24

CE=8

CIN=8

CLK=8

CMUX=12

COUT=8

CQ=5

CX=14

D1=7

D2=18

D3=20

D4=22

D5=26

D6=26

DMUX=13

DQ=5

DX=5

SR=8

SLICEX

A=37

A1=24

A2=37

A3=42

A4=48

A5=47

A6=47

AMUX=4

AQ=14

AX=2

B=22

B1=21

B2=27

B3=27

B4=30

B5=32

B6=32

BMUX=4

BQ=12

BX=2

C=44

C1=27

C2=43

C3=47

C4=50

C5=50

C6=50

CE=12

CLK=22

CMUX=14

CQ=8

CX=2

D=39

D1=28

D2=39

D3=44

D4=46

D5=47

D6=47

DMUX=12

DQ=8

SR=21

Tool Usage

Command Line History

xst -intstyle ise -ifn <ise_file>

ngdbuild -intstyle ise -dd _ngo -nt timestamp -uc <fname>.ucf -p xc6slx16-csg324-3 <ise_file> <fname>.ngd

map -intstyle ise -p xc6slx16-csg324-3 -w -logic_opt off -ol high -t 1 -xt 0 -register_duplication off -r 4 -global_opt off -mt off -ir off -pr off -lc off -power off -o <fname>.ncd <fname>.ngd <fname>.pcf

par -w -intstyle ise -ol high -mt off <fname>.ncd <fname>.ncd <fname>.pcf

trce -intstyle ise -v 3 -s 3 -n 3 -fastpaths -xml <fname>.twx <fname>.ncd -o <fname>.twr <fname>.pcf -ucf <fname>.ucf

bitgen -intstyle ise -f <fname>.ut <fname>.ncd

xst -intstyle ise -ifn <ise_file>

ngdbuild -intstyle ise -dd _ngo -nt timestamp -uc <fname>.ucf -p xc6slx9-tqg144-3 <fname>.ngc <fname>.ngd

map -intstyle ise -p xc6slx9-tqg144-3 -w -logic_opt off -ol high -t 1 -xt 0 -register_duplication off -r 4 -global_opt off -mt off -ir off -pr off -lc off -power off -o <fname>.ncd <fname>.ngd <fname>.pcf

par -w -intstyle ise -ol high -mt off <fname>.ncd <fname>.ncd <fname>.pcf

trce -intstyle ise -v 3 -s 3 -n 3 -fastpaths -xml <fname>.twx <fname>.ncd -o <fname>.twr <fname>.pcf -ucf <fname>.ucf

bitgen -intstyle ise -f <fname>.ut <fname>.ncd

Software Quality
Run Statistics
Program Name | Runs Started | Runs Finished | Errors | Fatal Errors | Internal Errors | Exceptions | Core Dumps
_impact | 302 | 244 | 0 | 0 | 0 | 0 | 0
bitgen | 620 | 617 | 0 | 0 | 0 | 0 | 0
cse_server | 1 | 1 | 0 | 0 | 0 | 0 | 0
elfcheck | 48 | 48 | 0 | 0 | 0 | 0 | 0
libgen | 1 | 1 | 0 | 0 | 0 | 0 | 0
map | 633 | 601 | 0 | 0 | 0 | 0 | 0
netgen | 9 | 9 | 0 | 0 | 0 | 0 | 0
ngcbuild | 15 | 15 | 0 | 0 | 0 | 0 | 0
ngdbuild | 672 | 670 | 0 | 0 | 0 | 0 | 0
par | 601 | 601 | 0 | 0 | 0 | 0 | 0
trce | 595 | 595 | 0 | 0 | 0 | 0 | 0
xps | 1 | 1 | 0 | 0 | 0 | 0 | 0
xst | 909 | 898 | 0 | 0 | 0 | 0 | 0

Help Statistics
Help files
/doc/usenglish/isehelp/cgn_c_cust_gui_overview.htm ( 1 ) | /doc/usenglish/isehelp/ise_r_source_types.htm ( 1 )
/doc/usenglish/isehelp/pn_db_nsw_define_hdl_module.htm ( 1 ) | /doc/usenglish/isehelp/pn_db_nsw_select_source_type.htm ( 1 )

Project Statistics
PROP_Enable_Message_Filtering=false | PROP_FitterReportFormat=HTML
PROP_LastAppliedGoal=Balanced | PROP_LastAppliedStrategy=Xilinx Default (unlocked)
PROP_ManualCompileOrderImp=false | PROP_PropSpecInProjFile=Store all values
PROP_Simulator=ISim (VHDL/Verilog) | PROP_SynthTopFile=changed
PROP_Top_Level_Module_Type=HDL | PROP_UseSmartGuide=false
PROP_UserConstraintEditorPreference=Text Editor | PROP_intProjectCreationTimestamp=2016-11-01T06:59:38
PROP_intWbtProjectID=64A098AA588B4832964EF4F8E0BE5300 | PROP_intWbtProjectIteration=2
PROP_intWorkingDirLocWRTProjDir=Same | PROP_intWorkingDirUsed=No
PROP_xilxBitgStart_IntDone=true | PROP_AutoTop=true
PROP_DevFamily=Spartan6 | PROP_DevDevice=xc6slx9
PROP_DevFamilyPMName=spartan6 | PROP_DevPackage=tqg144
PROP_Synthesis_Tool=XST (VHDL/Verilog) | PROP_DevSpeed=-3
PROP_PreferredLanguage=Verilog | FILE_UCF=1

FILE_VERILOG=7

Unisim Statistics
NGDBUILD_PRE_UNISIM_SUMMARY
NGDBUILD_NUM_BUFG=1 | NGDBUILD_NUM_BUFGP=1 | NGDBUILD_NUM_FD=1 | NGDBUILD_NUM_FDC=13
NGDBUILD_NUM_FDCE=54 | NGDBUILD_NUM_FDP=5 | NGDBUILD_NUM_FDPE=4 | NGDBUILD_NUM_GND=1
NGDBUILD_NUM_IBUF=3 | NGDBUILD_NUM_INV=5 | NGDBUILD_NUM_LUT1=2 | NGDBUILD_NUM_LUT2=33
NGDBUILD_NUM_LUT3=56 | NGDBUILD_NUM_LUT4=93 | NGDBUILD_NUM_LUT5=49 | NGDBUILD_NUM_LUT6=104
NGDBUILD_NUM_MUXCY=66 | NGDBUILD_NUM_MUXF7=9 | NGDBUILD_NUM_OBUF=5 | NGDBUILD_NUM_RAMB16BWER=1
NGDBUILD_NUM_VCC=1 | NGDBUILD_NUM_XORCY=38
NGDBUILD_POST_UNISIM_SUMMARY
NGDBUILD_NUM_BUFG=2 | NGDBUILD_NUM_FD=1 | NGDBUILD_NUM_FDC=13 | NGDBUILD_NUM_FDCE=54
NGDBUILD_NUM_FDP=5 | NGDBUILD_NUM_FDPE=4 | NGDBUILD_NUM_GND=1 | NGDBUILD_NUM_IBUF=3
NGDBUILD_NUM_IBUFG=1 | NGDBUILD_NUM_INV=5 | NGDBUILD_NUM_LUT1=2 | NGDBUILD_NUM_LUT2=33
NGDBUILD_NUM_LUT3=56 | NGDBUILD_NUM_LUT4=93 | NGDBUILD_NUM_LUT5=49 | NGDBUILD_NUM_LUT6=104
NGDBUILD_NUM_MUXCY=66 | NGDBUILD_NUM_MUXF7=9 | NGDBUILD_NUM_OBUF=5 | NGDBUILD_NUM_RAMB16BWER=1
NGDBUILD_NUM_TS_TIMESPEC=1 | NGDBUILD_NUM_VCC=1 | NGDBUILD_NUM_XORCY=38

XST Command Line Options
XST_OPTION_SUMMARY
-ifn=<fname>.prj | -ofn=<design_top> | -ofmt=NGC | -p=xc6slx9-3-tqg144
-top=<design_top> | -opt_mode=Speed | -opt_level=1 | -power=NO
-iuc=NO | -keep_hierarchy=No | -netlist_hierarchy=As_Optimized | -rtlview=Yes
-glob_opt=AllClockNets | -read_cores=YES | -write_timing_constraints=NO | -cross_clock_analysis=NO
-bus_delimiter=<> | -slice_utilization_ratio=100 | -bram_utilization_ratio=100 | -dsp_utilization_ratio=100
-reduce_control_sets=Auto | -fsm_extract=YES | -fsm_encoding=Auto | -safe_implementation=No
-fsm_style=LUT | -ram_extract=Yes | -ram_style=Auto | -rom_extract=Yes
-shreg_extract=YES | -rom_style=Auto | -auto_bram_packing=NO | -resource_sharing=YES
-async_to_sync=NO | -use_dsp48=Auto | -iobuf=YES | -max_fanout=100000
-bufg=16 | -register_duplication=YES | -register_balancing=No | -optimize_primitives=NO
-use_clock_enable=Auto | -use_sync_set=Auto | -use_sync_reset=Auto | -iob=Auto
-equivalent_register_removal=YES | -slice_utilization_ratio_maxmargin=5
