jonthomasson/SpartanMini/rev1.d (with shield 3d)/Xilinx/NES/luddes_nes/luddes_nes/handyvgs2/xilinx/par_usage_statistics.html

Par Statistics

Total Non-vccgnd Signals=6300

Total Non-vccgnd Design Pins=27302

Total Non-vccgnd Conns=27302

Total Non-vccgnd Timing Constrained Conns=26732

Phase 1 CPU=11.1 sec

Phase 2 CPU=12.4 sec

Phase 3 CPU=27.9 sec

Phase 4 CPU=29.2 sec

Phase 5 CPU=60.5 sec

Phase 6 CPU=60.5 sec

Phase 7 CPU=60.5 sec

Phase 8 CPU=60.5 sec

Phase 9 CPU=61.3 sec

Phase 10 CPU=65.4 sec

AvgWirelenPerPin Fanout 1=2.0

AvgWirelenPerPin Fanout 2=2.0

AvgWirelenPerPin Fanout 3=3.3

AvgWirelenPerPin Fanout 4=3.8

AvgWirelenPerPin Fanout 10=3.2

AvgWirelenPerPin Fanout 50=3.1

AvgWirelenPerPin Fanout 100=10.3

AvgWirelenPerPin Fanout 500=5.4

AvgWirelenPerPin Fanout 5000=3.4

AvgWirelenPerPin Fanout 20000=0.0

AvgWirelenPerPin Fanout 50000=0.0

AvgWirelenPerPin Fanout 100000=0.0

IRR Gamma=22.4559
