jonthomasson/SpartanMini/rev1.d (with shield 3d)/Xilinx/NES/luddes_nes/luddes_nes/handyvgs2/xilinx/usage_statistics_webtalk.html

### Device Usage Page (usage_statistics_webtalk.html)

This HTML page displays the device usage statistics that will be sent to Xilinx.

Software Version and Target Device
Product Version: | ISE:14.7 (WebPack) - P.20131013 | Target Family: | Spartan6
OS Platform: | NT64 | Target Device: | xc6slx9
Project ID (random number) | 80e5f5d7cab04d32b9649c2cde710933.9754768F61B54C2F9DB366D2C0A02D94.76 | Target Package: | tqg144
Registration ID | 211027110_0_0_178 | Target Speed: | -3
Date Generated | 2017-10-21T20:42:01 | Tool Flow | ISE

User Environment
OS Name | Microsoft Windows 7 , 64-bit | OS Release | Service Pack 1 (build 7601)
CPU Name | Intel(R) Core(TM)2 Duo CPU T8300 @ 2.40GHz | CPU Speed | 2394 MHz
OS Name | Microsoft Windows 7 , 64-bit | OS Release | Service Pack 1 (build 7601)
CPU Name | Intel(R) Core(TM)2 Duo CPU T8300 @ 2.40GHz | CPU Speed | 2394 MHz

Device Usage Statistics
Macro Statistics | Miscellaneous Statistics | Net Statistics | Site Usage

Accumulators=2

10-bit up accumulator=1

8-bit up loadable accumulator=1

Adders/Subtractors=93

10-bit adder=3

11-bit adder=4

12-bit adder=2

12-bit subtractor=1

15-bit adder=2

16-bit adder=3

16-bit subtractor=1

17-bit adder=4

17-bit subtractor=1

2-bit adder=3

21-bit subtractor=9

22-bit adder=1

22-bit subtractor=1

3-bit adder=3

3-bit subtractor=2

31-bit adder=1

4-bit subtractor=3

5-bit adder=2

6-bit adder=4

6-bit subtractor=10

7-bit adder=5

7-bit subtractor=3

8-bit adder=10

8-bit subtractor=3

9-bit adder=9

9-bit subtractor=3

Comparators=79

1-bit comparator not equal=1

10-bit comparator greater=5

10-bit comparator lessequal=5

16-bit comparator greater=6

16-bit comparator lessequal=5

2-bit comparator lessequal=1

3-bit comparator greater=2

3-bit comparator lessequal=3

32-bit comparator equal=1

5-bit comparator equal=1

5-bit comparator greater=1

6-bit comparator equal=1

7-bit comparator greater=5

7-bit comparator lessequal=4

8-bit comparator greater=7

8-bit comparator lessequal=22

8-bit comparator not equal=1

9-bit comparator equal=1

9-bit comparator greater=4

9-bit comparator lessequal=3

Counters=43

10-bit up counter=2

11-bit down counter=1

12-bit down counter=3

2-bit down counter=1

2-bit up counter=3

2-bit updown counter=2

3-bit down counter=2

3-bit up counter=4

4-bit down counter=4

4-bit up counter=1

5-bit up counter=1

6-bit up counter=2

7-bit down counter=1

8-bit down counter=14

8-bit up counter=1

9-bit up counter=1

FSMs=18 Logic shifters=2

11-bit shifter logical right=2

Multiplexers=1066

1-bit 2-to-1 multiplexer=666

1-bit 3-to-1 multiplexer=8

1-bit 4-to-1 multiplexer=49

1-bit 8-to-1 multiplexer=10

10-bit 2-to-1 multiplexer=3

11-bit 2-to-1 multiplexer=15

12-bit 2-to-1 multiplexer=2

14-bit 2-to-1 multiplexer=3

15-bit 2-to-1 multiplexer=21

15-bit 4-to-1 multiplexer=1

16-bit 2-to-1 multiplexer=21

16-bit 4-to-1 multiplexer=1

17-bit 2-to-1 multiplexer=4

2-bit 2-to-1 multiplexer=31

2-bit 4-to-1 multiplexer=2

21-bit 2-to-1 multiplexer=36

21-bit 4-to-1 multiplexer=9

22-bit 2-to-1 multiplexer=16

24-bit 2-to-1 multiplexer=1

3-bit 2-to-1 multiplexer=4

3-bit 4-to-1 multiplexer=1

32-bit 2-to-1 multiplexer=33

4-bit 16-to-1 multiplexer=1

4-bit 2-to-1 multiplexer=22

4-bit 3-to-1 multiplexer=1

5-bit 2-to-1 multiplexer=17

5-bit 3-to-1 multiplexer=1

5-bit 5-to-1 multiplexer=1

6-bit 2-to-1 multiplexer=14

7-bit 2-to-1 multiplexer=7

8-bit 12-to-1 multiplexer=1

8-bit 2-to-1 multiplexer=56

8-bit 4-to-1 multiplexer=4

8-bit 6-to-1 multiplexer=2

9-bit 2-to-1 multiplexer=2

Multipliers=10

5x2-bit multiplier=6

5x3-bit multiplier=3

8x8-bit multiplier=1

RAMs=19

1024x8-bit dual-port block RAM=1

16x12-bit single-port distributed Read Only RAM=1

16x9-bit single-port distributed Read Only RAM=1

2048x15-bit dual-port block RAM=1

2048x8-bit single-port distributed Read Only RAM=1

2048x9-bit single-port block Read Only RAM=1

256x19-bit single-port block Read Only RAM=1

256x6-bit single-port block Read Only RAM=1

256x8-bit single-port distributed RAM=1

32x11-bit single-port distributed Read Only RAM=1

32x15-bit single-port distributed Read Only RAM=1

32x6-bit single-port distributed RAM=1

32x7-bit single-port distributed Read Only RAM=1

32x8-bit single-port distributed RAM=1

4096x7-bit dual-port block RAM=1

4x1-bit single-port distributed Read Only RAM=1

512x15-bit dual-port block RAM=1

512x16-bit dual-port block Read Only RAM=1

64x15-bit single-port distributed Read Only RAM=1

Registers=2266

Flip-Flops=2266

Xors=21

1-bit xor2=15

32-bit xor2=1

4-bit xor2=2

8-bit xor2=3

MiscellaneousStatistics

AGG_BONDED_IO=88

AGG_IO=88

AGG_LOCED_IO=88

AGG_SLICE=1427

NUM_BONDED_IOB=88

NUM_BSFULL=2236

NUM_BSLUTONLY=2576

NUM_BSREGONLY=193

NUM_BSUSED=5005

NUM_BUFG=3

NUM_BUFIO2=1

NUM_BUFIO2FB=1

NUM_DSP48A1=1

NUM_LOCED_IOB=88

NUM_LOGIC_O5ANDO6=816

NUM_LOGIC_O5ONLY=143

NUM_LOGIC_O6ONLY=3798

NUM_LUT_RT_DRIVES_CARRY4=7

NUM_LUT_RT_DRIVES_FLOP=1

NUM_LUT_RT_EXO5=1

NUM_LUT_RT_EXO6=7

NUM_LUT_RT_O5=4

NUM_LUT_RT_O6=142

NUM_PLL_ADV=1

NUM_RAMB16BWER=6

NUM_RAMB8BWER=4

NUM_SLICEL=354

NUM_SLICEM=14

NUM_SLICEX=1059

NUM_SLICE_CARRY4=225

NUM_SLICE_CONTROLSET=229

NUM_SLICE_CYINIT=5839

NUM_SLICE_F7MUX=201

NUM_SLICE_F8MUX=61

NUM_SLICE_FF=2502

NUM_SLICE_LATCH=25

NUM_SLICE_LATCHLOGIC=15

NUM_SLICE_UNUSEDCTRL=566

NUM_SPRAM_O5ANDO6=7

NUM_SPRAM_O6ONLY=32

NUM_SRL_O5ANDO6=4

NUM_SRL_O6ONLY=4

NUM_UNUSABLE_FF_BELS=567

NetStatistics

NumNets_Active=6392

NumNets_Gnd=1

NumNets_Vcc=1

NumNodesOfType_Active_BOUNCEACROSS=335

NumNodesOfType_Active_BOUNCEIN=1001

NumNodesOfType_Active_BUFGOUT=3

NumNodesOfType_Active_BUFHINP2OUT=10

NumNodesOfType_Active_BUFIOINP=2

NumNodesOfType_Active_CLKPIN=858

NumNodesOfType_Active_CLKPINFEED=19

NumNodesOfType_Active_CNTRLPIN=1061

NumNodesOfType_Active_DOUBLE=12493

NumNodesOfType_Active_GENERIC=149

NumNodesOfType_Active_GLOBAL=132

NumNodesOfType_Active_INPUT=447

NumNodesOfType_Active_IOBIN2OUT=109

NumNodesOfType_Active_IOBOUTPUT=109

NumNodesOfType_Active_LUTINPUT=23457

NumNodesOfType_Active_OUTBOUND=6445

NumNodesOfType_Active_OUTPUT=6556

NumNodesOfType_Active_PADINPUT=72

NumNodesOfType_Active_PADOUTPUT=36

NumNodesOfType_Active_PINBOUNCE=4685

NumNodesOfType_Active_PINFEED=25022

NumNodesOfType_Active_PINFEED2=1

NumNodesOfType_Active_QUAD=6443

NumNodesOfType_Active_REGINPUT=1405

NumNodesOfType_Active_SINGLE=14466

NumNodesOfType_Gnd_BOUNCEACROSS=2

NumNodesOfType_Gnd_BOUNCEIN=83

NumNodesOfType_Gnd_CNTRLPIN=7

NumNodesOfType_Gnd_DOUBLE=5

NumNodesOfType_Gnd_GENERIC=6

NumNodesOfType_Gnd_HGNDOUT=55

NumNodesOfType_Gnd_INPUT=278

NumNodesOfType_Gnd_IOBIN2OUT=6

NumNodesOfType_Gnd_IOBOUTPUT=6

NumNodesOfType_Gnd_LUTINPUT=29

NumNodesOfType_Gnd_OUTBOUND=7

NumNodesOfType_Gnd_OUTPUT=8

NumNodesOfType_Gnd_PADINPUT=6

NumNodesOfType_Gnd_PINBOUNCE=104

NumNodesOfType_Gnd_PINFEED=287

NumNodesOfType_Gnd_QUAD=1

NumNodesOfType_Gnd_REGINPUT=3

NumNodesOfType_Gnd_SINGLE=13

NumNodesOfType_Vcc_CLKPIN=6

NumNodesOfType_Vcc_CNTRLPIN=7

NumNodesOfType_Vcc_GENERIC=2

NumNodesOfType_Vcc_HVCCOUT=412

NumNodesOfType_Vcc_INPUT=16

NumNodesOfType_Vcc_IOBIN2OUT=2

NumNodesOfType_Vcc_IOBOUTPUT=2

NumNodesOfType_Vcc_KVCCOUT=42

NumNodesOfType_Vcc_LUTINPUT=988

NumNodesOfType_Vcc_PADINPUT=2

NumNodesOfType_Vcc_PINBOUNCE=69

NumNodesOfType_Vcc_PINFEED=1012

NumNodesOfType_Vcc_REGINPUT=62

SiteStatistics

BUFG-BUFGMUX=3

IOB-IOBM=44

IOB-IOBS=44

SLICEL-SLICEM=160

SLICEX-SLICEL=160

SLICEX-SLICEM=185

SiteSummary

BUFG=3

BUFG_BUFG=3

BUFIO2=1

BUFIO2FB=1

BUFIO2FB_BUFIO2FB=1

BUFIO2_BUFIO2=1

CARRY4=225

DSP48A1=1

DSP48A1_DSP48A1=1

FF_SR=147

HARD0=31

HARD1=23

IOB=88

IOB_IMUX=40

IOB_INBUF=40

IOB_OUTBUF=64

LUT5=962

LUT6=4756

LUT_OR_MEM5=13

LUT_OR_MEM6=54

PAD=88

PLL_ADV=1

PLL_ADV_PLL_ADV=1

RAMB16BWER=6

RAMB16BWER_RAMB16BWER=6

RAMB8BWER=4

RAMB8BWER_RAMB8BWER=4

REG_SR=2395

SELMUX2_1=262

SLICEL=354

SLICEM=14

SLICEX=1059

Configuration Data

BUFIO2FB_BUFIO2FB

DIVIDE_BYPASS=[TRUE:1]

INVERT_INPUTS=[FALSE:1]

BUFIO2_BUFIO2

DIVIDE=[1:1]

DIVIDE_BYPASS=[TRUE:1]

I_INVERT=[FALSE:1]

DSP48A1

CEA=[CEA_INV:0] [CEA:1]

CEB=[CEB_INV:0] [CEB:1]

CEC=[CEC:1] [CEC_INV:0]

CECARRYIN=[CECARRYIN_INV:0] [CECARRYIN:1]

CED=[CED_INV:0] [CED:1]

CEM=[CEM_INV:0] [CEM:1]

CEOPMODE=[CEOPMODE_INV:0] [CEOPMODE:1]

CEP=[CEP:1] [CEP_INV:0]

CLK=[CLK:1] [CLK_INV:0]

RSTA=[RSTA:1] [RSTA_INV:0]

RSTB=[RSTB:1] [RSTB_INV:0]

RSTC=[RSTC_INV:0] [RSTC:1]

RSTCARRYIN=[RSTCARRYIN_INV:0] [RSTCARRYIN:1]

RSTD=[RSTD_INV:0] [RSTD:1]

RSTM=[RSTM:1] [RSTM_INV:0]

RSTOPMODE=[RSTOPMODE_INV:0] [RSTOPMODE:1]

RSTP=[RSTP_INV:0] [RSTP:1]

DSP48A1_DSP48A1

A0REG=[0:1]

A1REG=[1:1]

B0REG=[1:1]

B1REG=[0:1]

B_INPUT=[DIRECT:1]

CARRYINREG=[0:1]

CARRYINSEL=[OPMODE5:1]

CARRYOUTREG=[0:1]

CEA=[CEA_INV:0] [CEA:1]

CEB=[CEB_INV:0] [CEB:1]

CEC=[CEC:1] [CEC_INV:0]

CECARRYIN=[CECARRYIN_INV:0] [CECARRYIN:1]

CED=[CED_INV:0] [CED:1]

CEM=[CEM_INV:0] [CEM:1]

CEOPMODE=[CEOPMODE_INV:0] [CEOPMODE:1]

CEP=[CEP:1] [CEP_INV:0]

CLK=[CLK:1] [CLK_INV:0]

CREG=[0:1]

DREG=[0:1]

MREG=[0:1]

OPMODEREG=[0:1]

PREG=[0:1]

RSTA=[RSTA:1] [RSTA_INV:0]

RSTB=[RSTB:1] [RSTB_INV:0]

RSTC=[RSTC_INV:0] [RSTC:1]

RSTCARRYIN=[RSTCARRYIN_INV:0] [RSTCARRYIN:1]

RSTD=[RSTD_INV:0] [RSTD:1]

RSTM=[RSTM:1] [RSTM_INV:0]

RSTOPMODE=[RSTOPMODE_INV:0] [RSTOPMODE:1]

RSTP=[RSTP_INV:0] [RSTP:1]

RSTTYPE=[SYNC:1]

DSP48E1

ALUMODE0=[ALUMODE0:1] [ALUMODE0_INV:0]

ALUMODE1=[ALUMODE1:1] [ALUMODE1_INV:0]

ALUMODE2=[ALUMODE2:1] [ALUMODE2_INV:0]

ALUMODE3=[ALUMODE3:1] [ALUMODE3_INV:0]

CARRYIN=[CARRYIN:1] [CARRYIN_INV:0]

CLK=[CLK:1] [CLK_INV:0]

INMODE0=[INMODE0:1] [INMODE0_INV:0]

INMODE1=[INMODE1_INV:0] [INMODE1:1]

INMODE2=[INMODE2_INV:0] [INMODE2:1]

INMODE3=[INMODE3:1] [INMODE3_INV:0]

INMODE4=[INMODE4:1] [INMODE4_INV:0]

OPMODE0=[OPMODE0:1] [OPMODE0_INV:0]

OPMODE1=[OPMODE1_INV:0] [OPMODE1:1]

OPMODE2=[OPMODE2:1] [OPMODE2_INV:0]

OPMODE3=[OPMODE3:1] [OPMODE3_INV:0]

OPMODE4=[OPMODE4:1] [OPMODE4_INV:0]

OPMODE5=[OPMODE5_INV:0] [OPMODE5:1]

OPMODE6=[OPMODE6_INV:0] [OPMODE6:1]

DSP48E1_DSP48E1

ACASCREG=[1:1]

ADREG=[0:1]

ALUMODE0=[ALUMODE0:1] [ALUMODE0_INV:0]

ALUMODE1=[ALUMODE1:1] [ALUMODE1_INV:0]

ALUMODE2=[ALUMODE2:1] [ALUMODE2_INV:0]

ALUMODE3=[ALUMODE3:1] [ALUMODE3_INV:0]

ALUMODEREG=[0:1]

AREG=[1:1]

AUTORESET_PATDET=[NO_RESET:1]

A_INPUT=[DIRECT:1]

BCASCREG=[1:1]

BREG=[1:1]

B_INPUT=[DIRECT:1]

CARRYIN=[CARRYIN:1] [CARRYIN_INV:0]

CARRYINREG=[0:1]

CARRYINSELREG=[0:1]

CLK=[CLK:1] [CLK_INV:0]

CREG=[0:1]

DREG=[0:1]

INMODE0=[INMODE0:1] [INMODE0_INV:0]

INMODE1=[INMODE1_INV:0] [INMODE1:1]

INMODE2=[INMODE2_INV:0] [INMODE2:1]

INMODE3=[INMODE3:1] [INMODE3_INV:0]

INMODE4=[INMODE4:1] [INMODE4_INV:0]

INMODEREG=[0:1]

MREG=[0:1]

OPMODE0=[OPMODE0:1] [OPMODE0_INV:0]

OPMODE1=[OPMODE1_INV:0] [OPMODE1:1]

OPMODE2=[OPMODE2:1] [OPMODE2_INV:0]

OPMODE3=[OPMODE3:1] [OPMODE3_INV:0]

OPMODE4=[OPMODE4:1] [OPMODE4_INV:0]

OPMODE5=[OPMODE5_INV:0] [OPMODE5:1]

OPMODE6=[OPMODE6_INV:0] [OPMODE6:1]

OPMODEREG=[0:1]

PREG=[0:1]

SEL_MASK=[MASK:1]

SEL_PATTERN=[PATTERN:1]

USE_DPORT=[FALSE:1]

USE_MULT=[MULTIPLY:1]

USE_PATTERN_DETECT=[NO_PATDET:1]

USE_SIMD=[ONE48:1]

FF_INIT

CK=[CK:262] [CK_INV:0]

FFINIT=[INIT0:259] [INIT1:3]

FFSR=[SRLOW:259] [SRHIGH:3]

SYNC_ATTR=[ASYNC:153] [SYNC:109]

FF_SR

CK=[CK:147] [CK_INV:0]

SRINIT=[SRINIT0:142] [SRINIT1:5]

SYNC_ATTR=[ASYNC:94] [SYNC:53]

IOB33_INBUF_EN

IBUF_LOW_PWR=[TRUE:41]

IOB_OUTBUF

DRIVEATTRBOX=[12:64]

SLEW=[SLOW:64]

SUSPEND=[3STATE:64]

LUT_OR_MEM5

CLK=[CLK:11] [CLK_INV:0]

LUT_OR_MEM=[LUT:2] [RAM:11]

RAMMODE=[SPRAM32:7] [SRL16:4]

LUT_OR_MEM6

CLK=[CLK:47] [CLK_INV:0]

LUT_OR_MEM=[LUT:7] [RAM:47]

RAMMODE=[SPRAM32:7] [SPRAM64:32] [SRL16:8]

MMCME2_ADV

CLKINSEL=[CLKINSEL:1] [CLKINSEL_INV:0]

PSEN=[PSEN_INV:0] [PSEN:1]

PSINCDEC=[PSINCDEC:1] [PSINCDEC_INV:0]

PWRDWN=[PWRDWN_INV:0] [PWRDWN:1]

RST=[RST:1] [RST_INV:0]

MMCME2_ADV_MMCME2_ADV

BANDWIDTH=[OPTIMIZED:1]

CLKBURST_ENABLE=[FALSE:1]

CLKBURST_REPEAT=[FALSE:1]

CLKFBIN_EDGE=[FALSE:1]

CLKFBIN_NOCOUNT=[TRUE:1]

CLKFBOUT_EDGE=[FALSE:1]

CLKFBOUT_EN=[TRUE:1]

CLKFBOUT_FRAC_EN=[FALSE:1]

CLKFBOUT_FRAC_WF_FALL=[FALSE:1]

CLKFBOUT_FRAC_WF_RISE=[FALSE:1]

CLKFBOUT_NOCOUNT=[TRUE:1]

CLKFBOUT_USE_FINE_PS=[FALSE:1]

CLKINSEL=[CLKINSEL:1] [CLKINSEL_INV:0]

CLKOUT0_EDGE=[FALSE:1]

CLKOUT0_EN=[FALSE:1]

CLKOUT0_FRAC_EN=[FALSE:1]

CLKOUT0_FRAC_WF_FALL=[FALSE:1]

CLKOUT0_FRAC_WF_RISE=[FALSE:1]

CLKOUT0_NOCOUNT=[TRUE:1]

CLKOUT0_USE_FINE_PS=[FALSE:1]

CLKOUT1_EDGE=[FALSE:1]

CLKOUT1_EN=[FALSE:1]

CLKOUT1_NOCOUNT=[TRUE:1]

CLKOUT1_USE_FINE_PS=[FALSE:1]

CLKOUT2_EDGE=[FALSE:1]

CLKOUT2_EN=[FALSE:1]

CLKOUT2_NOCOUNT=[TRUE:1]

CLKOUT2_USE_FINE_PS=[FALSE:1]

CLKOUT3_EDGE=[FALSE:1]

CLKOUT3_EN=[FALSE:1]

CLKOUT3_NOCOUNT=[TRUE:1]

CLKOUT3_USE_FINE_PS=[FALSE:1]

CLKOUT4_CASCADE=[FALSE:1]

CLKOUT4_EDGE=[FALSE:1]

CLKOUT4_EN=[FALSE:1]

CLKOUT4_NOCOUNT=[TRUE:1]

CLKOUT4_USE_FINE_PS=[FALSE:1]

CLKOUT5_EDGE=[FALSE:1]

CLKOUT5_EN=[FALSE:1]

CLKOUT5_NOCOUNT=[TRUE:1]

CLKOUT5_USE_FINE_PS=[FALSE:1]

CLKOUT6_EDGE=[FALSE:1]

CLKOUT6_EN=[FALSE:1]

CLKOUT6_NOCOUNT=[TRUE:1]

CLKOUT6_USE_FINE_PS=[FALSE:1]

COMPENSATION=[ZHOLD:1]

DIRECT_PATH_CNTRL=[FALSE:1]

DIVCLK_EDGE=[FALSE:1]

DIVCLK_NOCOUNT=[TRUE:1]

EN_VCO_DIV1=[FALSE:1]

EN_VCO_DIV6=[FALSE:1]

GTS_WAIT=[FALSE:1]

HVLF_CNT_TEST_EN=[FALSE:1]

INTERP_TEST=[FALSE:1]

IN_DLY_EN=[TRUE:1]

LF_LOW_SEL=[FALSE:1]

MMCM_EN=[TRUE:1]

PERF0_USE_CLK=[FALSE:1]

PERF1_USE_CLK=[FALSE:1]

PERF2_USE_CLK=[FALSE:1]

PERF3_USE_CLK=[FALSE:1]

PSEN=[PSEN_INV:0] [PSEN:1]

PSINCDEC=[PSINCDEC:1] [PSINCDEC_INV:0]

PWRDWN=[PWRDWN_INV:0] [PWRDWN:1]

RST=[RST:1] [RST_INV:0]

SEL_HV_NMOS=[FALSE:1]

SEL_LV_NMOS=[FALSE:1]

SEL_SLIPD=[FALSE:1]

SS_EN=[FALSE:1]

SS_MODE=[CENTER_HIGH:1]

STARTUP_WAIT=[FALSE:1]

SUP_SEL_AREG=[FALSE:1]

SUP_SEL_DREG=[FALSE:1]

TMUX_MUX_SEL=[00:1]

VLF_HIGH_DIS_B=[TRUE:1]

VLF_HIGH_PWDN_B=[TRUE:1]

OLOGIC2

CLK0=[CLK0_INV:0] [CLK0:1]

OLOGIC2_OUTFF

CK0=[CK0_INV:0] [CK0:1]

OUTFFTYPE=[FF:1]

SRINIT_OQ=[0:1]

PLL_ADV

RST=[RST:1] [RST_INV:0]

PLL_ADV_PLL_ADV

BANDWIDTH=[OPTIMIZED:1]

CLK_FEEDBACK=[CLKFBOUT:1]

COMPENSATION=[SYSTEM_SYNCHRONOUS:1]

PLL_ADD_LEAKAGE=[2:1]

PLL_AVDD_COMP_SET=[2:1]

PLL_CLAMP_BYPASS=[FALSE:1]

PLL_CLAMP_REF_SEL=[1:1]

PLL_CLK0MX=[0:1]

PLL_CLK1MX=[0:1]

PLL_CLK2MX=[0:1]

PLL_CLK3MX=[0:1]

PLL_CLK4MX=[0:1]

PLL_CLK5MX=[0:1]

PLL_CLKBURST_CNT=[0:1]

PLL_CLKBURST_ENABLE=[TRUE:1]

PLL_CLKCNTRL=[0:1]

PLL_CLKFBMX=[0:1]

PLL_CLKFBOUT2_EDGE=[TRUE:1]

PLL_CLKFBOUT2_NOCOUNT=[TRUE:1]

PLL_CLKFBOUT_EDGE=[TRUE:1]

PLL_CLKFBOUT_EN=[FALSE:1]

PLL_CLKFBOUT_NOCOUNT=[TRUE:1]

PLL_CLKOUT0_EDGE=[TRUE:1]

PLL_CLKOUT0_EN=[FALSE:1]

PLL_CLKOUT0_NOCOUNT=[TRUE:1]

PLL_CLKOUT1_EDGE=[TRUE:1]

PLL_CLKOUT1_EN=[FALSE:1]

PLL_CLKOUT1_NOCOUNT=[TRUE:1]

PLL_CLKOUT2_EDGE=[TRUE:1]

PLL_CLKOUT2_EN=[FALSE:1]

PLL_CLKOUT2_NOCOUNT=[TRUE:1]

PLL_CLKOUT3_EDGE=[TRUE:1]

PLL_CLKOUT3_EN=[FALSE:1]

PLL_CLKOUT3_NOCOUNT=[TRUE:1]

PLL_CLKOUT4_EDGE=[TRUE:1]

PLL_CLKOUT4_EN=[FALSE:1]

PLL_CLKOUT4_NOCOUNT=[TRUE:1]

PLL_CLKOUT5_EDGE=[TRUE:1]

PLL_CLKOUT5_EN=[FALSE:1]

PLL_CLKOUT5_NOCOUNT=[TRUE:1]

PLL_CLK_LOST_DETECT=[FALSE:1]

PLL_CP=[1:1]

PLL_CP_BIAS_TRIP_SHIFT=[TRUE:1]

PLL_CP_REPL=[1:1]

PLL_CP_RES=[0:1]

PLL_DIRECT_PATH_CNTRL=[TRUE:1]

PLL_DIVCLK_EDGE=[TRUE:1]

PLL_DIVCLK_NOCOUNT=[TRUE:1]

PLL_DVDD_COMP_SET=[2:1]

PLL_EN=[FALSE:1]

PLL_EN_DLY=[TRUE:1]

PLL_EN_LEAKAGE=[2:1]

PLL_EN_TCLK0=[TRUE:1]

PLL_EN_TCLK1=[TRUE:1]

PLL_EN_TCLK2=[TRUE:1]

PLL_EN_TCLK3=[TRUE:1]

PLL_EN_VCO0=[FALSE:1]

PLL_EN_VCO1=[FALSE:1]

PLL_EN_VCO2=[FALSE:1]

PLL_EN_VCO3=[FALSE:1]

PLL_EN_VCO4=[FALSE:1]

PLL_EN_VCO5=[FALSE:1]

PLL_EN_VCO6=[FALSE:1]

PLL_EN_VCO7=[FALSE:1]

PLL_EN_VCO_DIV1=[FALSE:1]

PLL_EN_VCO_DIV6=[TRUE:1]

PLL_INTFB=[0:1]

PLL_IO_CLKSRC=[0:1]

PLL_LFHF=[3:1]

PLL_LOCK_FB_DLY=[3:1]

PLL_LOCK_REF_DLY=[5:1]

PLL_MAN_LF_EN=[TRUE:1]

PLL_NBTI_EN=[TRUE:1]

PLL_PFD_CNTRL=[8:1]

PLL_PFD_DLY=[1:1]

PLL_PWRD_CFG=[FALSE:1]

PLL_REG_INPUT=[TRUE:1]

PLL_RES=[1:1]

PLL_SEL_SLIPD=[FALSE:1]

PLL_SKEW_CNTRL=[0:1]

PLL_TEST_IN_WINDOW=[FALSE:1]

PLL_VDD_SEL=[0:1]

PLL_VLFHIGH_DIS=[TRUE:1]

RST=[RST:1] [RST_INV:0]

RAMB16BWER

CLKA=[CLKA_INV:0] [CLKA:6]

CLKB=[CLKB_INV:0] [CLKB:4]

ENA=[ENA_INV:0] [ENA:6]

ENB=[ENB_INV:0] [ENB:4]

REGCEA=[REGCEA_INV:0] [REGCEA:6]

REGCEB=[REGCEB_INV:0] [REGCEB:4]

RSTA=[RSTA:6] [RSTA_INV:0]

RSTB=[RSTB:4] [RSTB_INV:0]

WEA0=[WEA0:4] [WEA0_INV:2]

WEA1=[WEA1:4] [WEA1_INV:2]

WEA2=[WEA2:4] [WEA2_INV:2]

WEA3=[WEA3_INV:2] [WEA3:4]

WEB0=[WEB0:4] [WEB0_INV:0]

WEB1=[WEB1:4] [WEB1_INV:0]

WEB2=[WEB2_INV:0] [WEB2:4]

WEB3=[WEB3:4] [WEB3_INV:0]

RAMB16BWER_RAMB16BWER

CLKA=[CLKA_INV:0] [CLKA:6]

CLKB=[CLKB_INV:0] [CLKB:4]

DATA_WIDTH_A=[4:2] [9:3] [36:1]

DATA_WIDTH_B=[0:2] [4:2] [9:2]

DOA_REG=[0:6]

DOB_REG=[0:6]

ENA=[ENA_INV:0] [ENA:6]

ENB=[ENB_INV:0] [ENB:4]

EN_RSTRAM_A=[TRUE:6]

EN_RSTRAM_B=[TRUE:6]

RAM_MODE=[TDP:6]

REGCEA=[REGCEA_INV:0] [REGCEA:6]

REGCEB=[REGCEB_INV:0] [REGCEB:4]

RSTA=[RSTA:6] [RSTA_INV:0]

RSTB=[RSTB:4] [RSTB_INV:0]

RSTTYPE=[SYNC:6]

RST_PRIORITY_A=[CE:6]

RST_PRIORITY_B=[CE:6]

WEA0=[WEA0:4] [WEA0_INV:2]

WEA1=[WEA1:4] [WEA1_INV:2]

WEA2=[WEA2:4] [WEA2_INV:2]

WEA3=[WEA3_INV:2] [WEA3:4]

WEB0=[WEB0:4] [WEB0_INV:0]

WEB1=[WEB1:4] [WEB1_INV:0]

WEB2=[WEB2_INV:0] [WEB2:4]

WEB3=[WEB3:4] [WEB3_INV:0]

WRITE_MODE_A=[WRITE_FIRST:4] [READ_FIRST:2]

WRITE_MODE_B=[WRITE_FIRST:6]

RAMB18E1

CLKARDCLK=[CLKARDCLK:6] [CLKARDCLK_INV:0]

CLKBWRCLK=[CLKBWRCLK:6] [CLKBWRCLK_INV:0]

ENARDEN=[ENARDEN_INV:0] [ENARDEN:6]

ENBWREN=[ENBWREN_INV:0] [ENBWREN:6]

REGCLKARDRCLK=[REGCLKARDRCLK_INV:0] [REGCLKARDRCLK:6]

REGCLKB=[REGCLKB_INV:0] [REGCLKB:6]

RSTRAMARSTRAM=[RSTRAMARSTRAM:6] [RSTRAMARSTRAM_INV:0]

RSTRAMB=[RSTRAMB:6] [RSTRAMB_INV:0]

RSTREGARSTREG=[RSTREGARSTREG_INV:0] [RSTREGARSTREG:6]

RSTREGB=[RSTREGB_INV:0] [RSTREGB:6]

RAMB18E1_RAMB18E1

CLKARDCLK=[CLKARDCLK:6] [CLKARDCLK_INV:0]

CLKBWRCLK=[CLKBWRCLK:6] [CLKBWRCLK_INV:0]

DOA_REG=[0:6]

DOB_REG=[0:6]

ENARDEN=[ENARDEN_INV:0] [ENARDEN:6]

ENBWREN=[ENBWREN_INV:0] [ENBWREN:6]

EN_PWRGATE=[NONE:6]

RAM_MODE=[TDP:6]

RDADDR_COLLISION_HWCONFIG=[DELAYED_WRITE:6]

READ_WIDTH_A=[9:3] [18:3]

READ_WIDTH_B=[0:2] [9:1] [18:3]

REGCLKARDRCLK=[REGCLKARDRCLK_INV:0] [REGCLKARDRCLK:6]

REGCLKB=[REGCLKB_INV:0] [REGCLKB:6]

RSTRAMARSTRAM=[RSTRAMARSTRAM:6] [RSTRAMARSTRAM_INV:0]

RSTRAMB=[RSTRAMB:6] [RSTRAMB_INV:0]

RSTREGARSTREG=[RSTREGARSTREG_INV:0] [RSTREGARSTREG:6]

RSTREGB=[RSTREGB_INV:0] [RSTREGB:6]

RSTREG_PRIORITY_A=[RSTREG:6]

RSTREG_PRIORITY_B=[RSTREG:6]

SAVEDATA=[FALSE:6]

WRITE_MODE_A=[WRITE_FIRST:4] [READ_FIRST:2]

WRITE_MODE_B=[WRITE_FIRST:6]

WRITE_WIDTH_A=[9:3] [18:3]

WRITE_WIDTH_B=[0:4] [18:2]

RAMB36E1

CLKARDCLKL=[CLKARDCLKL:1] [CLKARDCLKL_INV:0]

CLKARDCLKU=[CLKARDCLKU_INV:0] [CLKARDCLKU:1]

CLKBWRCLKL=[CLKBWRCLKL_INV:0] [CLKBWRCLKL:1]

CLKBWRCLKU=[CLKBWRCLKU:1] [CLKBWRCLKU_INV:0]

ENARDENL=[ENARDENL_INV:0] [ENARDENL:1]

ENARDENU=[ENARDENU_INV:0] [ENARDENU:1]

ENBWRENL=[ENBWRENL:1] [ENBWRENL_INV:0]

ENBWRENU=[ENBWRENU_INV:0] [ENBWRENU:1]

REGCLKARDRCLKL=[REGCLKARDRCLKL_INV:0] [REGCLKARDRCLKL:1]

REGCLKARDRCLKU=[REGCLKARDRCLKU:1] [REGCLKARDRCLKU_INV:0]

REGCLKBL=[REGCLKBL_INV:0] [REGCLKBL:1]

REGCLKBU=[REGCLKBU:1] [REGCLKBU_INV:0]

RSTRAMARSTRAML=[RSTRAMARSTRAML_INV:0] [RSTRAMARSTRAML:1]

RSTRAMARSTRAMU=[RSTRAMARSTRAMU:1] [RSTRAMARSTRAMU_INV:0]

RSTRAMBL=[RSTRAMBL_INV:0] [RSTRAMBL:1]

RSTRAMBU=[RSTRAMBU:1] [RSTRAMBU_INV:0]

RSTREGARSTREGL=[RSTREGARSTREGL:1] [RSTREGARSTREGL_INV:0]

RSTREGARSTREGU=[RSTREGARSTREGU_INV:0] [RSTREGARSTREGU:1]

RSTREGBL=[RSTREGBL:1] [RSTREGBL_INV:0]

RSTREGBU=[RSTREGBU:1] [RSTREGBU_INV:0]

RAMB36E1_RAMB36E1

CLKARDCLKL=[CLKARDCLKL:1] [CLKARDCLKL_INV:0]

CLKARDCLKU=[CLKARDCLKU_INV:0] [CLKARDCLKU:1]

CLKBWRCLKL=[CLKBWRCLKL_INV:0] [CLKBWRCLKL:1]

CLKBWRCLKU=[CLKBWRCLKU:1] [CLKBWRCLKU_INV:0]

DOA_REG=[0:1]

DOB_REG=[0:1]

ENARDENL=[ENARDENL_INV:0] [ENARDENL:1]

ENARDENU=[ENARDENU_INV:0] [ENARDENU:1]

ENBWRENL=[ENBWRENL:1] [ENBWRENL_INV:0]

ENBWRENU=[ENBWRENU_INV:0] [ENBWRENU:1]

EN_ECC_READ=[FALSE:1]

EN_ECC_WRITE=[FALSE:1]

EN_PWRGATE=[NONE:1]

RAM_EXTENSION_A=[NONE:1]

RAM_EXTENSION_B=[NONE:1]

RAM_MODE=[TDP:1]

RDADDR_COLLISION_HWCONFIG=[DELAYED_WRITE:1]

READ_WIDTH_A=[18:1]

READ_WIDTH_B=[18:1]

REGCLKARDRCLKL=[REGCLKARDRCLKL_INV:0] [REGCLKARDRCLKL:1]

REGCLKARDRCLKU=[REGCLKARDRCLKU:1] [REGCLKARDRCLKU_INV:0]

REGCLKBL=[REGCLKBL_INV:0] [REGCLKBL:1]

REGCLKBU=[REGCLKBU:1] [REGCLKBU_INV:0]

RSTRAMARSTRAML=[RSTRAMARSTRAML_INV:0] [RSTRAMARSTRAML:1]

RSTRAMARSTRAMU=[RSTRAMARSTRAMU:1] [RSTRAMARSTRAMU_INV:0]

RSTRAMBL=[RSTRAMBL_INV:0] [RSTRAMBL:1]

RSTRAMBU=[RSTRAMBU:1] [RSTRAMBU_INV:0]

RSTREGARSTREGL=[RSTREGARSTREGL:1] [RSTREGARSTREGL_INV:0]

RSTREGARSTREGU=[RSTREGARSTREGU_INV:0] [RSTREGARSTREGU:1]

RSTREGBL=[RSTREGBL:1] [RSTREGBL_INV:0]

RSTREGBU=[RSTREGBU:1] [RSTREGBU_INV:0]

RSTREG_PRIORITY_A=[RSTREG:1]

RSTREG_PRIORITY_B=[RSTREG:1]

SAVEDATA=[FALSE:1]

WRITE_MODE_A=[READ_FIRST:1]

WRITE_MODE_B=[WRITE_FIRST:1]

WRITE_WIDTH_A=[18:1]

WRITE_WIDTH_B=[0:1]

RAMB8BWER

CLKAWRCLK=[CLKAWRCLK:4] [CLKAWRCLK_INV:0]

CLKBRDCLK=[CLKBRDCLK_INV:0] [CLKBRDCLK:3]

ENAWREN=[ENAWREN:4] [ENAWREN_INV:0]

ENBRDEN=[ENBRDEN_INV:0] [ENBRDEN:3]

REGCEA=[REGCEA_INV:0] [REGCEA:4]

REGCEBREGCE=[REGCEBREGCE_INV:0] [REGCEBREGCE:3]

RSTA=[RSTA:4] [RSTA_INV:0]

RSTBRST=[RSTBRST:3] [RSTBRST_INV:0]

WEAWEL0=[WEAWEL0:4] [WEAWEL0_INV:0]

WEAWEL1=[WEAWEL1_INV:0] [WEAWEL1:4]

WEBWEU0=[WEBWEU0:3] [WEBWEU0_INV:0]

WEBWEU1=[WEBWEU1:3] [WEBWEU1_INV:0]

RAMB8BWER_RAMB8BWER

CLKAWRCLK=[CLKAWRCLK:4] [CLKAWRCLK_INV:0]

CLKBRDCLK=[CLKBRDCLK_INV:0] [CLKBRDCLK:3]

DATA_WIDTH_A=[9:2] [18:2]

DATA_WIDTH_B=[0:1] [9:1] [18:2]

DOA_REG=[0:4]

DOB_REG=[0:4]

ENAWREN=[ENAWREN:4] [ENAWREN_INV:0]

ENBRDEN=[ENBRDEN_INV:0] [ENBRDEN:3]

EN_RSTRAM_A=[TRUE:4]

EN_RSTRAM_B=[TRUE:4]

RAM_MODE=[TDP:4]

REGCEA=[REGCEA_INV:0] [REGCEA:4]

REGCEBREGCE=[REGCEBREGCE_INV:0] [REGCEBREGCE:3]

RSTA=[RSTA:4] [RSTA_INV:0]

RSTBRST=[RSTBRST:3] [RSTBRST_INV:0]

RSTTYPE=[SYNC:4]

RST_PRIORITY_A=[CE:4]

RST_PRIORITY_B=[CE:4]

WEAWEL0=[WEAWEL0:4] [WEAWEL0_INV:0]

WEAWEL1=[WEAWEL1_INV:0] [WEAWEL1:4]

WEBWEU0=[WEBWEU0:3] [WEBWEU0_INV:0]

WEBWEU1=[WEBWEU1:3] [WEBWEU1_INV:0]

WRITE_MODE_A=[WRITE_FIRST:2] [READ_FIRST:2]

WRITE_MODE_B=[WRITE_FIRST:4]

REG_INIT

CK=[CK:1946] [CK_INV:15]

FFINIT=[INIT0:1928] [INIT1:33]

FFSR=[SRLOW:1930] [SRHIGH:31]

LATCH_OR_FF=[FF:1946] [AND2L:15]

SYNC_ATTR=[ASYNC:1054] [SYNC:907]

REG_SR

CK=[CK:2355] [CK_INV:40]

LATCH_OR_FF=[FF:2355] [LATCH:25] [AND2L:15]

SRINIT=[SRINIT0:2358] [SRINIT1:37]

SYNC_ATTR=[ASYNC:1400] [SYNC:995]

SELMUX2_1

0=[0:90] [0_INV:0]

SLICEL

CLK=[CLK:107] [CLK_INV:7]

SLICEM

CLK=[CLK:14] [CLK_INV:0]

SLICEX

CLK=[CLK:727] [CLK_INV:6]

Pin Data

BUFG

I0=3

O=3

BUFG_BUFG

I0=3

O=3

BUFIO2

DIVCLK=1

I=1

BUFIO2FB

I=1

O=1

BUFIO2FB_BUFIO2FB

I=1

O=1

BUFIO2_BUFIO2

DIVCLK=1

I=1

CARRY4

CIN=154

CO3=155

CYINIT=71

DI0=209

DI1=204

DI2=192

DI3=155

O0=211

O1=198

O2=196

O3=187

S0=225

S1=209

S2=204

S3=192

DSP48A1

A0=1

A1=1

A10=1

A11=1

A12=1

A13=1

A14=1

A15=1

A16=1

A17=1

A2=1

A3=1

A4=1

A5=1

A6=1

A7=1

A8=1

A9=1

B0=1

B1=1

B10=1

B11=1

B12=1

B13=1

B14=1

B15=1

B16=1

B17=1

B2=1

B3=1

B4=1

B5=1

B6=1

B7=1

B8=1

B9=1

C0=1

C1=1

C10=1

C11=1

C12=1

C13=1

C14=1

C15=1

C16=1

C17=1

C18=1

C19=1

C2=1

C20=1

C21=1

C22=1

C23=1

C24=1

C25=1

C26=1

C27=1

C28=1

C29=1

C3=1

C30=1

C31=1

C32=1

C33=1

C34=1

C35=1

C36=1

C37=1

C38=1

C39=1

C4=1

C40=1

C41=1

C42=1

C43=1

C44=1

C45=1

C46=1

C47=1

C5=1

C6=1

C7=1

C8=1

C9=1

CEA=1

CEB=1

CEC=1

CECARRYIN=1

CED=1

CEM=1

CEOPMODE=1

CEP=1

CLK=1

D0=1

D1=1

D10=1

D11=1

D12=1

D13=1

D14=1

D15=1

D16=1

D17=1

D2=1

D3=1

D4=1

D5=1

D6=1

D7=1

D8=1

D9=1

M0=1

M1=1

M10=1

M11=1

M12=1

M13=1

M14=1

M15=1

M2=1

M3=1

M4=1

M5=1

M6=1

M7=1

M8=1

M9=1

OPMODE0=1

OPMODE1=1

OPMODE2=1

OPMODE3=1

OPMODE4=1

OPMODE5=1

OPMODE6=1

OPMODE7=1

RSTA=1

RSTB=1

RSTC=1

RSTCARRYIN=1

RSTD=1

RSTM=1

RSTOPMODE=1

RSTP=1

DSP48A1_DSP48A1

A0=1

A1=1

A10=1

A11=1

A12=1

A13=1

A14=1

A15=1

A16=1

A17=1

A2=1

A3=1

A4=1

A5=1

A6=1

A7=1

A8=1

A9=1

B0=1

B1=1

B10=1

B11=1

B12=1

B13=1

B14=1

B15=1

B16=1

B17=1

B2=1

B3=1

B4=1

B5=1

B6=1

B7=1

B8=1

B9=1

C0=1

C1=1

C10=1

C11=1

C12=1

C13=1

C14=1

C15=1

C16=1

C17=1

C18=1

C19=1

C2=1

C20=1

C21=1

C22=1

C23=1

C24=1

C25=1

C26=1

C27=1

C28=1

C29=1

C3=1

C30=1

C31=1

C32=1

C33=1

C34=1

C35=1

C36=1

C37=1

C38=1

C39=1

C4=1

C40=1

C41=1

C42=1

C43=1

C44=1

C45=1

C46=1

C47=1

C5=1

C6=1

C7=1

C8=1

C9=1

CEA=1

CEB=1

CEC=1

CECARRYIN=1

CED=1

CEM=1

CEOPMODE=1

CEP=1

CLK=1

D0=1

D1=1

D10=1

D11=1

D12=1

D13=1

D14=1

D15=1

D16=1

D17=1

D2=1

D3=1

D4=1

D5=1

D6=1

D7=1

D8=1

D9=1

M0=1

M1=1

M10=1

M11=1

M12=1

M13=1

M14=1

M15=1

M2=1

M3=1

M4=1

M5=1

M6=1

M7=1

M8=1

M9=1

OPMODE0=1

OPMODE1=1

OPMODE2=1

OPMODE3=1

OPMODE4=1

OPMODE5=1

OPMODE6=1

OPMODE7=1

RSTA=1

RSTB=1

RSTC=1

RSTCARRYIN=1

RSTD=1

RSTM=1

RSTOPMODE=1

RSTP=1

DSP48E1

A0=1

A1=1

A10=1

A11=1

A12=1

A13=1

A14=1

A15=1

A16=1

A17=1

A18=1

A19=1

A2=1

A20=1

A21=1

A22=1

A23=1

A24=1

A25=1

A26=1

A27=1

A28=1

A29=1

A3=1

A4=1

A5=1

A6=1

A7=1

A8=1

A9=1

ALUMODE0=1

ALUMODE1=1

ALUMODE2=1

ALUMODE3=1

B0=1

B1=1

B10=1

B11=1

B12=1

B13=1

B14=1

B15=1

B16=1

B17=1

B2=1

B3=1

B4=1

B5=1

B6=1

B7=1

B8=1

B9=1

C0=1

C1=1

C10=1

C11=1

C12=1

C13=1

C14=1
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

map -intstyle ise -p xc6slx9-tqg144-3 -w -logic_opt off -ol high -t 1 -xt 0 -register_duplication off -r 4 -global_opt off -mt 2 -ir off -pr off -lc off -power off -o <fname>.ncd <fname>.ngd <fname>.pcf

par -w -intstyle ise -ol high -mt off <fname>.ncd <fname>.ncd <fname>.pcf

trce -intstyle ise -v 3 -s 3 -n 3 -fastpaths -xml <fname>.twx <fname>.ncd -o <fname>.twr <fname>.pcf

bitgen -intstyle ise -f <fname>.ut <fname>.ncd

xst -intstyle ise -ifn <ise_file>

ngdbuild -intstyle ise -dd _ngo -nt timestamp -uc <fname>.ucf -p xc6slx9-tqg144-3 <fname>.ngc <fname>.ngd

map -intstyle ise -p xc6slx9-tqg144-3 -w -logic_opt off -ol high -t 1 -xt 0 -register_duplication off -r 4 -global_opt off -mt 2 -ir off -pr off -lc off -power off -o <fname>.ncd <fname>.ngd <fname>.pcf

par -w -intstyle ise -ol high -mt off <fname>.ncd <fname>.ncd <fname>.pcf

trce -intstyle ise -v 3 -s 3 -n 3 -fastpaths -xml <fname>.twx <fname>.ncd -o <fname>.twr <fname>.pcf

bitgen -intstyle ise -f <fname>.ut <fname>.ncd

xst -intstyle ise -ifn <ise_file>

ngdbuild -intstyle ise -dd _ngo -nt timestamp -uc <fname>.ucf -p xc6slx9-tqg144-3 <fname>.ngc <fname>.ngd

map -intstyle ise -p xc6slx9-tqg144-3 -w -logic_opt off -ol high -t 1 -xt 0 -register_duplication off -r 4 -global_opt off -mt 2 -ir off -pr off -lc off -power off -o <fname>.ncd <fname>.ngd <fname>.pcf

par -w -intstyle ise -ol high -mt off <fname>.ncd <fname>.ncd <fname>.pcf

trce -intstyle ise -v 3 -s 3 -n 3 -fastpaths -xml <fname>.twx <fname>.ncd -o <fname>.twr <fname>.pcf

bitgen -intstyle ise -f <fname>.ut <fname>.ncd

xst -intstyle ise -ifn <ise_file>

ngdbuild -intstyle ise -dd _ngo -nt timestamp -uc <fname>.ucf -p xc6slx9-tqg144-3 <fname>.ngc <fname>.ngd

map -intstyle ise -p xc6slx9-tqg144-3 -w -logic_opt off -ol high -t 1 -xt 0 -register_duplication off -r 4 -global_opt off -mt 2 -ir off -pr off -lc off -power off -o <fname>.ncd <fname>.ngd <fname>.pcf

par -w -intstyle ise -ol high -mt off <fname>.ncd <fname>.ncd <fname>.pcf

trce -intstyle ise -v 3 -s 3 -n 3 -fastpaths -xml <fname>.twx <fname>.ncd -o <fname>.twr <fname>.pcf

bitgen -intstyle ise -f <fname>.ut <fname>.ncd

Software Quality
Run Statistics
Program Name | Runs Started | Runs Finished | Errors | Fatal Errors | Internal Errors | Exceptions | Core Dumps
_impact | 334 | 270 | 0 | 0 | 0 | 0 | 0
bitgen | 649 | 646 | 0 | 0 | 0 | 0 | 0
cse_server | 1 | 1 | 0 | 0 | 0 | 0 | 0
elfcheck | 48 | 48 | 0 | 0 | 0 | 0 | 0
libgen | 1 | 1 | 0 | 0 | 0 | 0 | 0
map | 669 | 631 | 0 | 0 | 0 | 0 | 0
netgen | 9 | 9 | 0 | 0 | 0 | 0 | 0
ngcbuild | 15 | 15 | 0 | 0 | 0 | 0 | 0
ngdbuild | 715 | 713 | 0 | 0 | 0 | 0 | 0
par | 631 | 631 | 0 | 0 | 0 | 0 | 0
trce | 625 | 625 | 0 | 0 | 0 | 0 | 0
xps | 1 | 1 | 0 | 0 | 0 | 0 | 0
xst | 956 | 945 | 0 | 0 | 0 | 0 | 0

Help Statistics
Help files
/doc/usenglish/isehelp/cgn_c_cust_gui_overview.htm ( 1 ) | /doc/usenglish/isehelp/ise_r_source_types.htm ( 1 )
/doc/usenglish/isehelp/pn_db_nsw_define_hdl_module.htm ( 1 ) | /doc/usenglish/isehelp/pn_db_nsw_select_source_type.htm ( 1 )

Project Statistics
PROP_Enable_Message_Filtering=false | PROP_FitterReportFormat=HTML
PROP_LastAppliedGoal=Balanced | PROP_LastAppliedStrategy=Xilinx Default (unlocked)
PROP_ManualCompileOrderImp=false | PROP_PropSpecInProjFile=Store all values
PROP_Simulator=ISim (VHDL/Verilog) | PROP_SynthTopFile=changed
PROP_Top_Level_Module_Type=HDL | PROP_UseSmartGuide=false
PROP_UserConstraintEditorPreference=Text Editor | PROP_intProjectCreationTimestamp=2013-09-03T18:54:58
PROP_intWbtProjectID=9754768F61B54C2F9DB366D2C0A02D94 | PROP_intWbtProjectIteration=76
PROP_intWorkingDirLocWRTProjDir=Same | PROP_intWorkingDirUsed=No
PROP_xilxBitgStart_IntDone=true | PROP_AutoTop=true
PROP_DevFamily=Spartan6 | PROP_ibiswriterOutputFile=VisualSpcTop
PROP_xilxMapEnableMultiThreading=2 | PROP_DevDevice=xc6slx9
PROP_DevFamilyPMName=spartan6 | PROP_DevPackage=tqg144
PROP_Synthesis_Tool=XST (VHDL/Verilog) | PROP_DevSpeed=-3
PROP_PreferredLanguage=Verilog | PROP_netgenPostMapSimModelName=VisualSpcTop_map.vhd
PROP_netgenPostParSimModelName=VisualSpcTop_timesim.vhd | PROP_netgenPostSynthesisSimModelName=VisualSpcTop_synthesis.vhd
PROP_netgenPostXlateSimModelName=VisualSpcTop_translate.vhd | PROP_netgenRenameTopLevEntTo=VisualSpcTop
FILE_UCF=1 | FILE_VERILOG=21

Core Statistics
Core Type=clk_wiz_v3_6
clkin1_period=10.000 | clkin2_period=10.000 | clock_mgr_type=AUTO | feedback_source=FDBK_AUTO
feedback_type=SINGLE | manual_override=false | num_out_clk=3 | primtype_sel=PLL_BASE
use_clk_valid=false | use_dyn_phase_shift=false | use_dyn_reconfig=false | use_freeze=false
use_inclk_stopped=false | use_inclk_switchover=false | use_locked=true | use_max_i_jitter=false
use_min_o_jitter=false | use_phase_alignment=true | use_power_down=false | use_reset=true

use_status=false

Unisim Statistics
XST_UNISIM_SUMMARY
XST_NUM_BUFG=1 | XST_NUM_IBUFG=1
NGDBUILD_PRE_UNISIM_SUMMARY
NGDBUILD_NUM_BUFG=4 | NGDBUILD_NUM_DSP48A1=1 | NGDBUILD_NUM_FD=380 | NGDBUILD_NUM_FDC=19
NGDBUILD_NUM_FDCE=32 | NGDBUILD_NUM_FDE=1022 | NGDBUILD_NUM_FDP=1 | NGDBUILD_NUM_FDR=68
NGDBUILD_NUM_FDRE=947 | NGDBUILD_NUM_FDS=5 | NGDBUILD_NUM_FDSE=28 | NGDBUILD_NUM_GND=1
NGDBUILD_NUM_IBUF=19 | NGDBUILD_NUM_IBUFG=1 | NGDBUILD_NUM_INV=317 | NGDBUILD_NUM_IOBUF=16
NGDBUILD_NUM_LD=25 | NGDBUILD_NUM_LUT1=140 | NGDBUILD_NUM_LUT2=219 | NGDBUILD_NUM_LUT3=539
NGDBUILD_NUM_LUT4=486 | NGDBUILD_NUM_LUT5=1145 | NGDBUILD_NUM_LUT6=2389 | NGDBUILD_NUM_MUXCY=760
NGDBUILD_NUM_MUXF7=185 | NGDBUILD_NUM_MUXF8=53 | NGDBUILD_NUM_OBUF=48 | NGDBUILD_NUM_RAM256X1S=8
NGDBUILD_NUM_RAM32X1S=14 | NGDBUILD_NUM_RAMB16BWER=6 | NGDBUILD_NUM_RAMB8BWER=4 | NGDBUILD_NUM_SRLC16E=12
NGDBUILD_NUM_VCC=1 | NGDBUILD_NUM_XORCY=785
NGDBUILD_POST_UNISIM_SUMMARY
NGDBUILD_NUM_BUFG=4 | NGDBUILD_NUM_DSP48A1=1 | NGDBUILD_NUM_FD=380 | NGDBUILD_NUM_FDC=19
NGDBUILD_NUM_FDCE=32 | NGDBUILD_NUM_FDE=1022 | NGDBUILD_NUM_FDP=1 | NGDBUILD_NUM_FDR=68
NGDBUILD_NUM_FDRE=947 | NGDBUILD_NUM_FDS=5 | NGDBUILD_NUM_FDSE=28 | NGDBUILD_NUM_GND=1
NGDBUILD_NUM_IBUF=39 | NGDBUILD_NUM_IBUFG=1 | NGDBUILD_NUM_INV=317 | NGDBUILD_NUM_LD=25
NGDBUILD_NUM_LUT1=140 | NGDBUILD_NUM_LUT2=219 | NGDBUILD_NUM_LUT3=539 | NGDBUILD_NUM_LUT4=486
NGDBUILD_NUM_LUT5=1145 | NGDBUILD_NUM_LUT6=2389 | NGDBUILD_NUM_MUXCY=760 | NGDBUILD_NUM_MUXF7=185
NGDBUILD_NUM_MUXF8=53 | NGDBUILD_NUM_OBUF=48 | NGDBUILD_NUM_OBUFT=16 | NGDBUILD_NUM_PLL_ADV=1
NGDBUILD_NUM_RAM256X1S=8 | NGDBUILD_NUM_RAM32X1S=14 | NGDBUILD_NUM_RAMB16BWER=6 | NGDBUILD_NUM_RAMB8BWER=4
NGDBUILD_NUM_SRLC16E=12 | NGDBUILD_NUM_TS_TIMESPEC=1 | NGDBUILD_NUM_VCC=1 | NGDBUILD_NUM_XORCY=785

XST Command Line Options
XST_OPTION_SUMMARY
-ifn=<fname>.prj | -ofn=<design_top> | -ofmt=NGC | -p=xc6slx9-3-tqg144
-top=<design_top> | -opt_mode=Speed | -opt_level=1 | -power=NO
-iuc=NO | -keep_hierarchy=No | -netlist_hierarchy=As_Optimized | -rtlview=Yes
-glob_opt=AllClockNets | -read_cores=YES | -write_timing_constraints=NO | -cross_clock_analysis=NO
-bus_delimiter=<> | -slice_utilization_ratio=100 | -bram_utilization_ratio=100 | -dsp_utilization_ratio=100
-reduce_control_sets=Auto | -fsm_extract=YES | -fsm_encoding=Auto | -safe_implementation=No
-fsm_style=LUT | -ram_extract=Yes | -ram_style=Auto | -rom_extract=Yes
-shreg_extract=YES | -rom_style=Auto | -auto_bram_packing=NO | -resource_sharing=YES
-async_to_sync=NO | -use_dsp48=Auto | -iobuf=YES | -max_fanout=100000
-bufg=16 | -register_duplication=YES | -register_balancing=No | -optimize_primitives=NO
-use_clock_enable=Auto | -use_sync_set=Auto | -use_sync_reset=Auto | -iob=Auto
-equivalent_register_removal=YES | -slice_utilization_ratio_maxmargin=5
