jonthomasson/SpartanMini/rev1.d (with shield 3d)/Spartan6Dev.kicad_pcb

## KiCad design rev1.d (with shield 3d)/Spartan6Dev.kicad_pcb (2017-09-24)

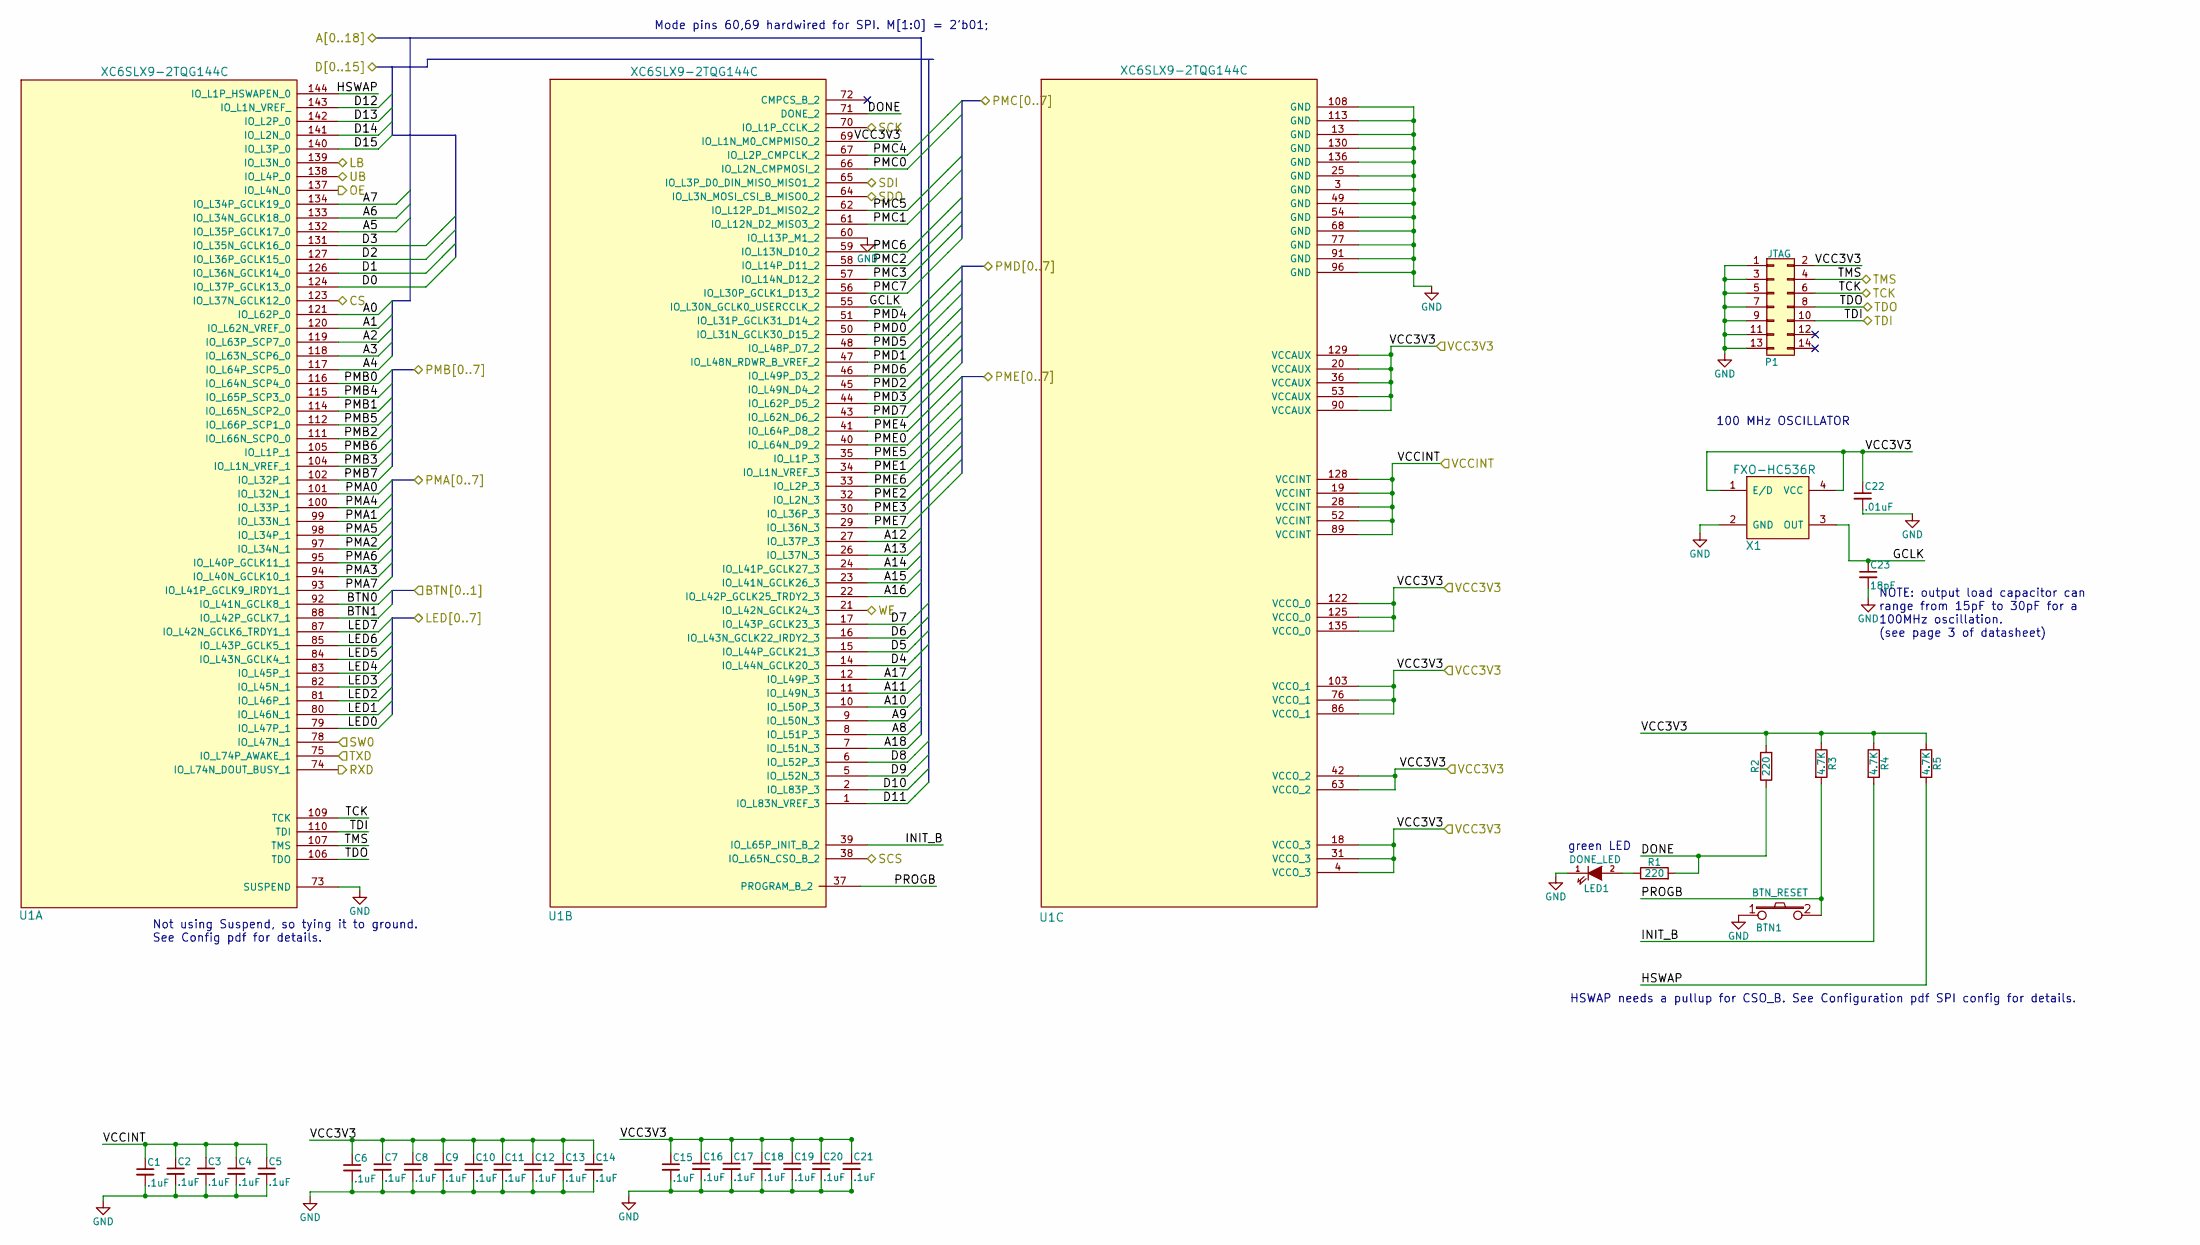
[picture p18: schematic fpga.sch]

Parts:
BTN1: BTN_RESET; SWITCH_1825966_1
C1, C2, C3, C4, C5, C6, C7, C8, C9, C10, C11, C12, C13, C14, C15, C16, C17, C18, C19, C20, C21: .1uF; C_0603
C22: .01uF; C_0603
C23: 18pF; C_0603
LED1: DONE_LED; LED_0603
P1: JTAG; IDC_Header_Straight_14pins
R1, R2: 220; R_0603
R3, R4, R5: 4.7K; R_0603
U1: XC6SLX9-2TQG144C; TQFP-144_20x20mm_Pitch0.5mm
X1: FXO-HC536R; OSCILLATOR_FXO_HC53

Connections:
/fpga/A0: U1.121 (IO_L62P_0); also elsewhere on the board
/fpga/A1: U1.120 (IO_L62N_VREF_0); also elsewhere on the board
/fpga/A2: U1.119 (IO_L63P_SCP7_0); also elsewhere on the board
/fpga/A3: U1.118 (IO_L63N_SCP6_0); also elsewhere on the board
/fpga/A4: U1.117 (IO_L64P_SCP5_0); also elsewhere on the board
/fpga/A5: U1.132 (IO_L35P_GCLK17_0); also elsewhere on the board
/fpga/A6: U1.133 (IO_L34N_GCLK18_0); also elsewhere on the board
/fpga/A7: U1.134 (IO_L34P_GCLK19_0); also elsewhere on the board
/fpga/A8: U1.8 (IO_L51P_3); also elsewhere on the board
/fpga/A9: U1.9 (IO_L50N_3); also elsewhere on the board
/fpga/A10: U1.10 (IO_L50P_3); also elsewhere on the board
/fpga/A11: U1.11 (IO_L49N_3); also elsewhere on the board
/fpga/A12: U1.27 (IO_L37P_3); also elsewhere on the board
/fpga/A13: U1.26 (IO_L37N_3); also elsewhere on the board
/fpga/A14: U1.24 (IO_L41P_GCLK27_3); also elsewhere on the board
/fpga/A15: U1.23 (IO_L41N_GCLK26_3); also elsewhere on the board
/fpga/A16: U1.22 (IO_L42P_GCLK25_TRDY2_3); also elsewhere on the board
/fpga/A17: U1.12 (IO_L49P_3); also elsewhere on the board
/fpga/A18: U1.7 (IO_L51N_3); also elsewhere on the board
/fpga/BTN0: U1.92 (IO_L41N_GCLK8_1); also elsewhere on the board
/fpga/BTN1: U1.88 (IO_L42P_GCLK7_1); also elsewhere on the board
/fpga/CS: U1.123 (IO_L37N_GCLK12_0); also elsewhere on the board
/fpga/D0: U1.124 (IO_L37P_GCLK13_0); also elsewhere on the board
/fpga/D1: U1.126 (IO_L36N_GCLK14_0); also elsewhere on the board
/fpga/D2: U1.127 (IO_L36P_GCLK15_0); also elsewhere on the board
/fpga/D3: U1.131 (IO_L35N_GCLK16_0); also elsewhere on the board
/fpga/D4: U1.14 (IO_L44N_GCLK20_3); also elsewhere on the board
/fpga/D5: U1.15 (IO_L44P_GCLK21_3); also elsewhere on the board
/fpga/D6: U1.16 (IO_L43N_GCLK22_IRDY2_3); also elsewhere on the board
/fpga/D7: U1.17 (IO_L43P_GCLK23_3); also elsewhere on the board
/fpga/D8: U1.6 (IO_L52P_3); also elsewhere on the board
/fpga/D9: U1.5 (IO_L52N_3); also elsewhere on the board
/fpga/D10: U1.2 (IO_L83P_3); also elsewhere on the board
/fpga/D11: U1.1 (IO_L83N_VREF_3); also elsewhere on the board
/fpga/D12: U1.143 (IO_L1N_VREF_); also elsewhere on the board
/fpga/D13: U1.142 (IO_L2P_0); also elsewhere on the board
/fpga/D14: U1.141 (IO_L2N_0); also elsewhere on the board
/fpga/D15: U1.140 (IO_L3P_0); also elsewhere on the board
/fpga/DONE: R1.2, R2.1, U1.71 (DONE_2)
/fpga/GCLK: C23.1, U1.55 (IO_L30N_GCLK0_USERCCLK_2), X1.3 (OUT)
/fpga/HSWAP: R5.2, U1.144 (IO_L1P_HSWAPEN_0)
/fpga/INIT_B: R4.2, U1.39 (IO_L65P_INIT_B_2)
/fpga/LB: U1.139 (IO_L3N_0); also elsewhere on the board
/fpga/LED0: U1.79 (IO_L47P_1); also elsewhere on the board
/fpga/LED1: U1.80 (IO_L46N_1); also elsewhere on the board
/fpga/LED2: U1.81 (IO_L46P_1); also elsewhere on the board
/fpga/LED3: U1.82 (IO_L45N_1); also elsewhere on the board
/fpga/LED4: U1.83 (IO_L45P_1); also elsewhere on the board
/fpga/LED5: U1.84 (IO_L43N_GCLK4_1); also elsewhere on the board
/fpga/LED6: U1.85 (IO_L43P_GCLK5_1); also elsewhere on the board
/fpga/LED7: U1.87 (IO_L42N_GCLK6_TRDY1_1); also elsewhere on the board
/fpga/OE: U1.137 (IO_L4N_0); also elsewhere on the board
/fpga/PMA0: U1.101 (IO_L32N_1); also elsewhere on the board
/fpga/PMA1: U1.99 (IO_L33N_1); also elsewhere on the board
/fpga/PMA2: U1.97 (IO_L34N_1); also elsewhere on the board
/fpga/PMA3: U1.94 (IO_L40N_GCLK10_1); also elsewhere on the board
/fpga/PMA4: U1.100 (IO_L33P_1); also elsewhere on the board
/fpga/PMA5: U1.98 (IO_L34P_1); also elsewhere on the board
/fpga/PMA6: U1.95 (IO_L40P_GCLK11_1); also elsewhere on the board
/fpga/PMA7: U1.93 (IO_L41P_GCLK9_IRDY1_1); also elsewhere on the board
/fpga/PMB0: U1.116 (IO_L64N_SCP4_0); also elsewhere on the board
/fpga/PMB1: U1.114 (IO_L65N_SCP2_0); also elsewhere on the board
/fpga/PMB2: U1.111 (IO_L66N_SCP0_0); also elsewhere on the board
/fpga/PMB3: U1.104 (IO_L1N_VREF_1); also elsewhere on the board
/fpga/PMB4: U1.115 (IO_L65P_SCP3_0); also elsewhere on the board
/fpga/PMB5: U1.112 (IO_L66P_SCP1_0); also elsewhere on the board
/fpga/PMB6: U1.105 (IO_L1P_1); also elsewhere on the board
/fpga/PMB7: U1.102 (IO_L32P_1); also elsewhere on the board
/fpga/PMC0: U1.66 (IO_L2N_CMPMOSI_2); also elsewhere on the board
/fpga/PMC1: U1.61 (IO_L12N_D2_MISO3_2); also elsewhere on the board
/fpga/PMC2: U1.58 (IO_L14P_D11_2); also elsewhere on the board
/fpga/PMC3: U1.57 (IO_L14N_D12_2); also elsewhere on the board
/fpga/PMC4: U1.67 (IO_L2P_CMPCLK_2); also elsewhere on the board
/fpga/PMC5: U1.62 (IO_L12P_D1_MISO2_2); also elsewhere on the board
/fpga/PMC6: U1.59 (IO_L13N_D10_2); also elsewhere on the board
/fpga/PMC7: U1.56 (IO_L30P_GCLK1_D13_2); also elsewhere on the board
/fpga/PMD0: U1.50 (IO_L31N_GCLK30_D15_2); also elsewhere on the board
/fpga/PMD1: U1.47 (IO_L48N_RDWR_B_VREF_2); also elsewhere on the board
/fpga/PMD2: U1.45 (IO_L49N_D4_2); also elsewhere on the board
/fpga/PMD3: U1.44 (IO_L62P_D5_2); also elsewhere on the board
/fpga/PMD4: U1.51 (IO_L31P_GCLK31_D14_2); also elsewhere on the board
/fpga/PMD5: U1.48 (IO_L48P_D7_2); also elsewhere on the board
/fpga/PMD6: U1.46 (IO_L49P_D3_2); also elsewhere on the board
/fpga/PMD7: U1.43 (IO_L62N_D6_2); also elsewhere on the board
/fpga/PME0: U1.40 (IO_L64N_D9_2); also elsewhere on the board
/fpga/PME1: U1.34 (IO_L1N_VREF_3); also elsewhere on the board
/fpga/PME2: U1.32 (IO_L2N_3); also elsewhere on the board
/fpga/PME3: U1.30 (IO_L36P_3); also elsewhere on the board
/fpga/PME4: U1.41 (IO_L64P_D8_2); also elsewhere on the board
/fpga/PME5: U1.35 (IO_L1P_3); also elsewhere on the board
/fpga/PME6: U1.33 (IO_L2P_3); also elsewhere on the board
/fpga/PME7: U1.29 (IO_L36N_3); also elsewhere on the board
/fpga/PROGB: BTN1.2, R3.2, U1.37 (PROGRAM_B_2)
/fpga/RXD: U1.74 (IO_L74N_DOUT_BUSY_1); also elsewhere on the board
/fpga/SCK: U1.70 (IO_L1P_CCLK_2); also elsewhere on the board
/fpga/SCS: U1.38 (IO_L65N_CSO_B_2); also elsewhere on the board
/fpga/SDI: U1.65 (IO_L3P_D0_DIN_MISO_MISO1_2); also elsewhere on the board
/fpga/SDO: U1.64 (IO_L3N_MOSI_CSI_B_MISO0_2); also elsewhere on the board
/fpga/SW0: U1.78 (IO_L47N_1); also elsewhere on the board
/fpga/TCK: P1.6, U1.109 (TCK); also elsewhere on the board
/fpga/TDI: P1.10, U1.110 (TDI); also elsewhere on the board
/fpga/TDO: P1.8, U1.106 (TDO); also elsewhere on the board
/fpga/TMS: P1.4, U1.107 (TMS); also elsewhere on the board
/fpga/TXD: U1.75 (IO_L74P_AWAKE_1); also elsewhere on the board
/fpga/UB: U1.138 (IO_L4P_0); also elsewhere on the board
/fpga/VCC3V3: C6.1, C7.1, C8.1, C9.1, C10.1, C11.1, C12.1, C13.1, C14.1, C15.1, C16.1, C17.1, C18.1, C19.1, C20.1, C21.1, C22.1, P1.2, R2.2, R3.1, R4.1, R5.1, U1.4 (VCCO_3), U1.18 (VCCO_3), U1.20 (VCCAUX), U1.31 (VCCO_3), U1.36 (VCCAUX), U1.42 (VCCO_2), U1.53 (VCCAUX), U1.63 (VCCO_2), U1.69 (IO_L1N_M0_CMPMISO_2), U1.76 (VCCO_1), U1.86 (VCCO_1), U1.90 (VCCAUX), U1.103 (VCCO_1), U1.122 (VCCO_0), U1.125 (VCCO_0), U1.129 (VCCAUX), U1.135 (VCCO_0), X1.1 (E/D), X1.4 (VCC); also elsewhere on the board
/fpga/VCCINT: C1.1, C2.1, C3.1, C4.1, C5.1, U1.19 (VCCINT), U1.28 (VCCINT), U1.52 (VCCINT), U1.89 (VCCINT), U1.128 (VCCINT); also elsewhere on the board
/fpga/WE: U1.21 (IO_L42N_GCLK24_3); also elsewhere on the board
GND: BTN1.1, C1.2, C2.2, C3.2, C4.2, C5.2, C6.2, C7.2, C8.2, C9.2, C10.2, C11.2, C12.2, C13.2, C14.2, C15.2, C16.2, C17.2, C18.2, C19.2, C20.2, C21.2, C22.2, C23.2, LED1.1 (K), P1.1, P1.3, P1.5, P1.7, P1.9, P1.11, P1.13, U1.3 (GND), U1.13 (GND), U1.25 (GND), U1.49 (GND), U1.54 (GND), U1.60 (IO_L13P_M1_2), U1.68 (GND), U1.73 (SUSPEND), U1.77 (GND), U1.91 (GND), U1.96 (GND), U1.108 (GND), U1.113 (GND), U1.130 (GND), U1.136 (GND), X1.2 (GND); also elsewhere on the board
unnamed: LED1.2 (A), R1.1

Notes on the sheet:
100 MHz OSCILLATOR
Mode pins 60,69 hardwired for SPI. M[1:0] = 2'b01;
HSWAP needs a pullup for CSO_B. See Configuration pdf SPI config for details.
Not using Suspend, so tying it to ground. See Config pdf for details.
green LED
NOTE: output load capacitor can range from 15pF to 30pF for a 100MHz oscillation. (see page 3 of datasheet)

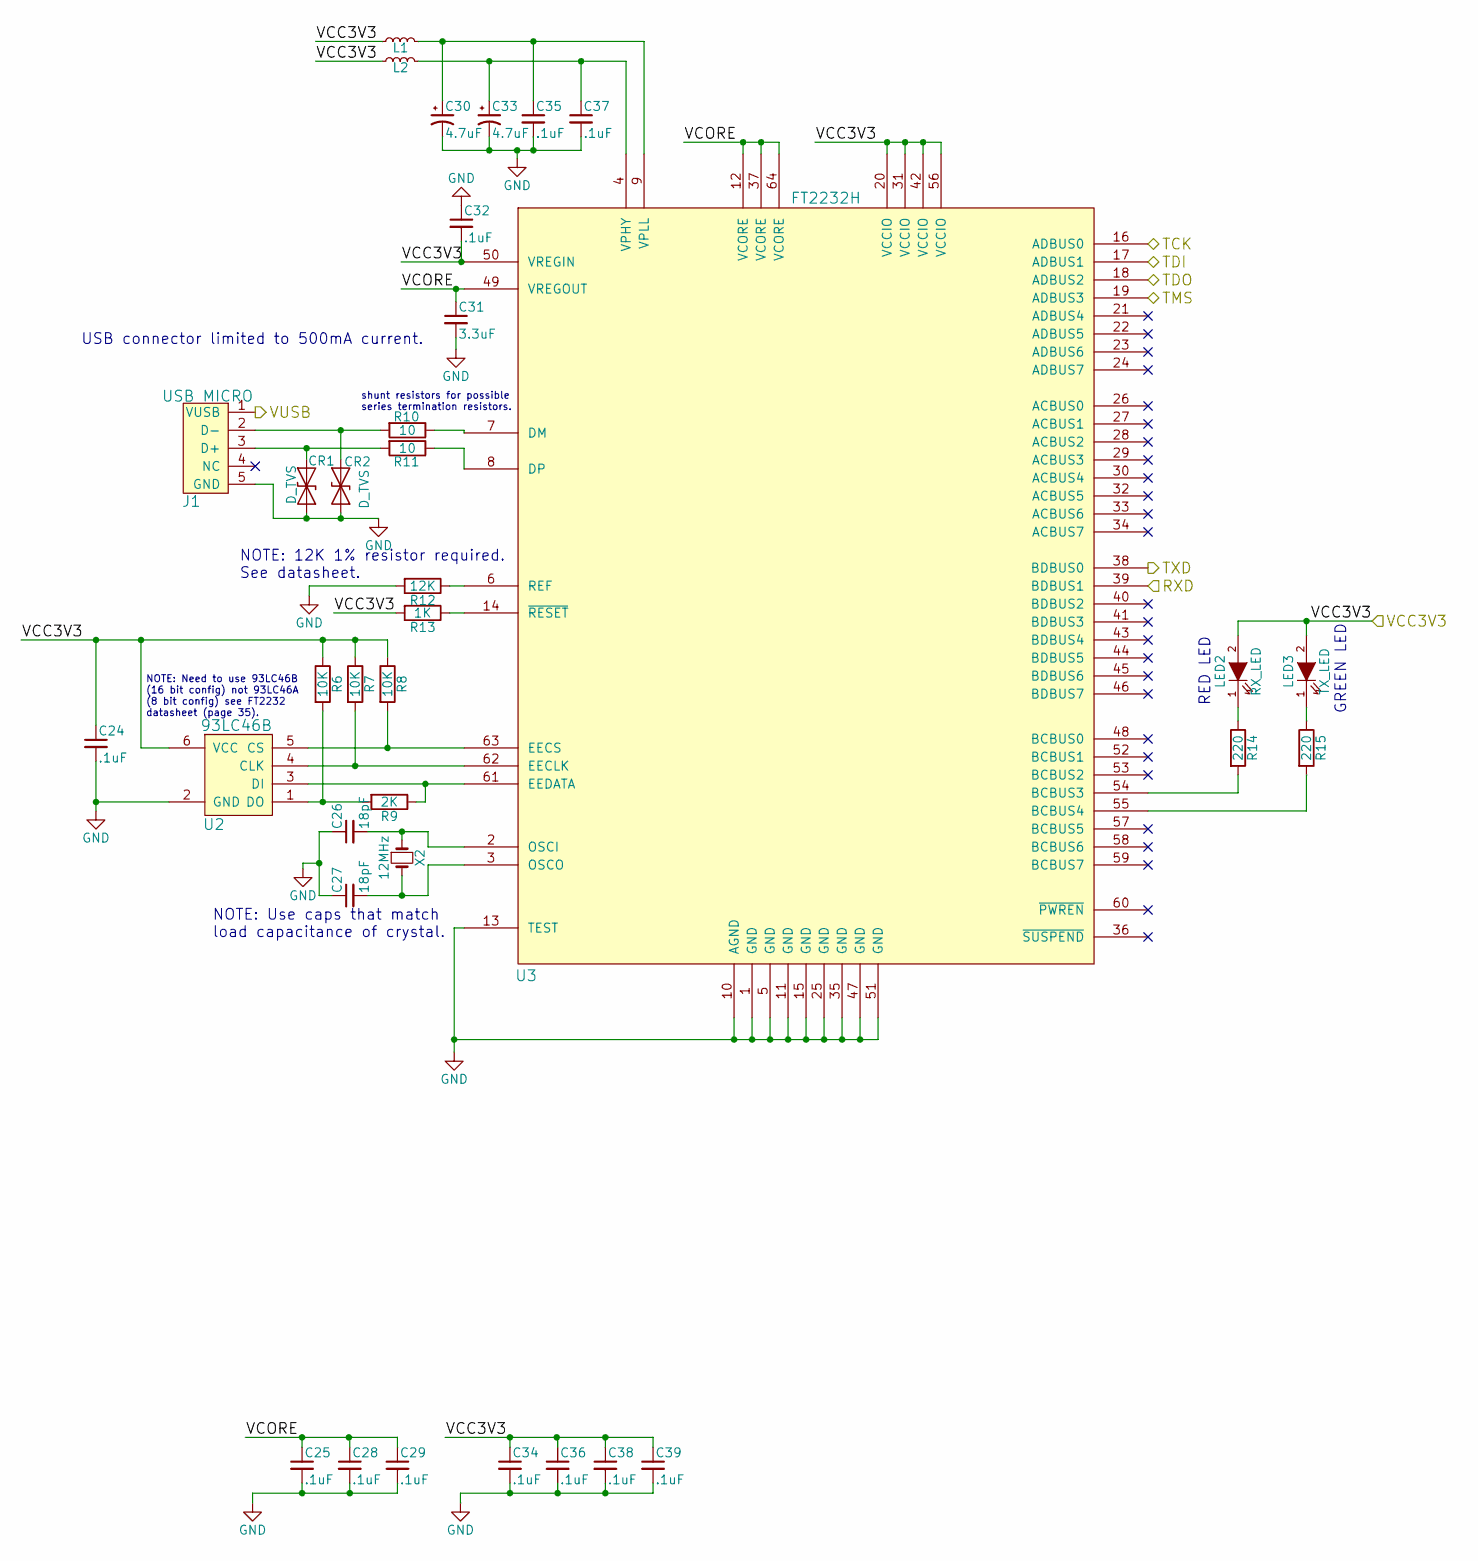
[picture p19: schematic usb.sch]

Parts:
C24, C25, C28, C29, C32, C34, C35, C36, C37, C38, C39: .1uF; C_0603
C26, C27: 18pF; C_0603
C30, C33: 4.7uF; TantalC_SizeA_EIA-3216_Reflow
C31: 3.3uF; C_1206
CR1, CR2: D_TVS; D_TVS_PGB1010603
J1: USB MICRO; MICRO_USB_10118194
L1, L2: L_Small; R_0805
LED2: RX_LED; LED_0603
LED3: TX_LED; LED_0603
R6, R7, R8: 10K; R_0603
R9: 2K; R_0603
R10, R11: 10; R_0603
R12: 12K; R_0603
R13: 1K; R_0603
R14, R15: 220; R_0603
U2: 93LC46B; SOT-23-6
U3: FT2232H; LQFP-64_10x10mm_Pitch0.5mm
X2: 12MHz; CRYSTAL_ABM3

Connections:
/fpga/RXD: U3.39 (BDBUS1); also elsewhere on the board
/fpga/TCK: U3.16 (ADBUS0); also elsewhere on the board
/fpga/TDI: U3.17 (ADBUS1); also elsewhere on the board
/fpga/TDO: U3.18 (ADBUS2); also elsewhere on the board
/fpga/TMS: U3.19 (ADBUS3); also elsewhere on the board
/fpga/TXD: U3.38 (BDBUS0); also elsewhere on the board
/fpga/VCC3V3: C24.1, C32.2, C34.1, C36.1, C38.1, C39.1, L1.1, L2.1, LED2.2 (A), LED3.2 (A), R6.1, R7.1, R8.1, R13.2, U2.6 (VCC), U3.20 (VCCIO), U3.31 (VCCIO), U3.42 (VCCIO), U3.50 (VREGIN), U3.56 (VCCIO); also elsewhere on the board
/power/VUSB: J1.1 (VUSB); also elsewhere on the board
/usb/VCORE: C25.1, C28.1, C29.1, C31.1, U3.12 (VCORE), U3.37 (VCORE), U3.49 (VREGOUT), U3.64 (VCORE)
GND: C24.2, C25.2, C26.1, C27.1, C28.2, C29.2, C30.2, C31.2, C32.1, C33.2, C34.2, C35.2, C36.2, C37.2, C38.2, C39.2, CR1.2 (A2), CR2.2 (A2), J1.5 (GND), R12.2, U2.2 (GND), U3.1 (GND), U3.5 (GND), U3.10 (AGND), U3.11 (GND), U3.13 (TEST), U3.15 (GND), U3.25 (GND), U3.35 (GND), U3.47 (GND), U3.51 (GND); also elsewhere on the board
unnamed: C26.2, U3.2 (OSCI), X2.1
unnamed: C27.2, U3.3 (OSCO), X2.2
unnamed: C30.1, C35.1, L1.2, U3.9 (VPLL)
unnamed: C33.1, C37.1, L2.2, U3.4 (VPHY)
unnamed: CR1.1 (A1), J1.3 (D+), R11.2
unnamed: CR2.1 (A1), J1.2 (D-), R10.2
unnamed: LED2.1 (K), R14.1
unnamed: LED3.1 (K), R15.1
unnamed: R6.2, R9.2, U2.1 (DO)
unnamed: R7.2, U2.4 (CLK), U3.62 (EECLK)
unnamed: R8.2, U2.5 (CS), U3.63 (EECS)
unnamed: R9.1, U2.3 (DI), U3.61 (EEDATA)
unnamed: R10.1, U3.7 (DM)
unnamed: R11.1, U3.8 (DP)
unnamed: R12.1, U3.6 (REF)
unnamed: R13.1, U3.14 (~RESET)
unnamed: R14.2, U3.54 (BCBUS3)
unnamed: R15.2, U3.55 (BCBUS4)

Notes on the sheet:
USB connector limited to 500mA current.
GREEN LED
RED LED
NOTE: Use caps that match load capacitance of crystal.
NOTE: 12K 1% resistor required. See datasheet.
shunt resistors for possible series termination resistors.
NOTE: Need to use 93LC46B (16 bit config) not 93LC46A (8 bit config) see FT2232 datasheet (page 35).

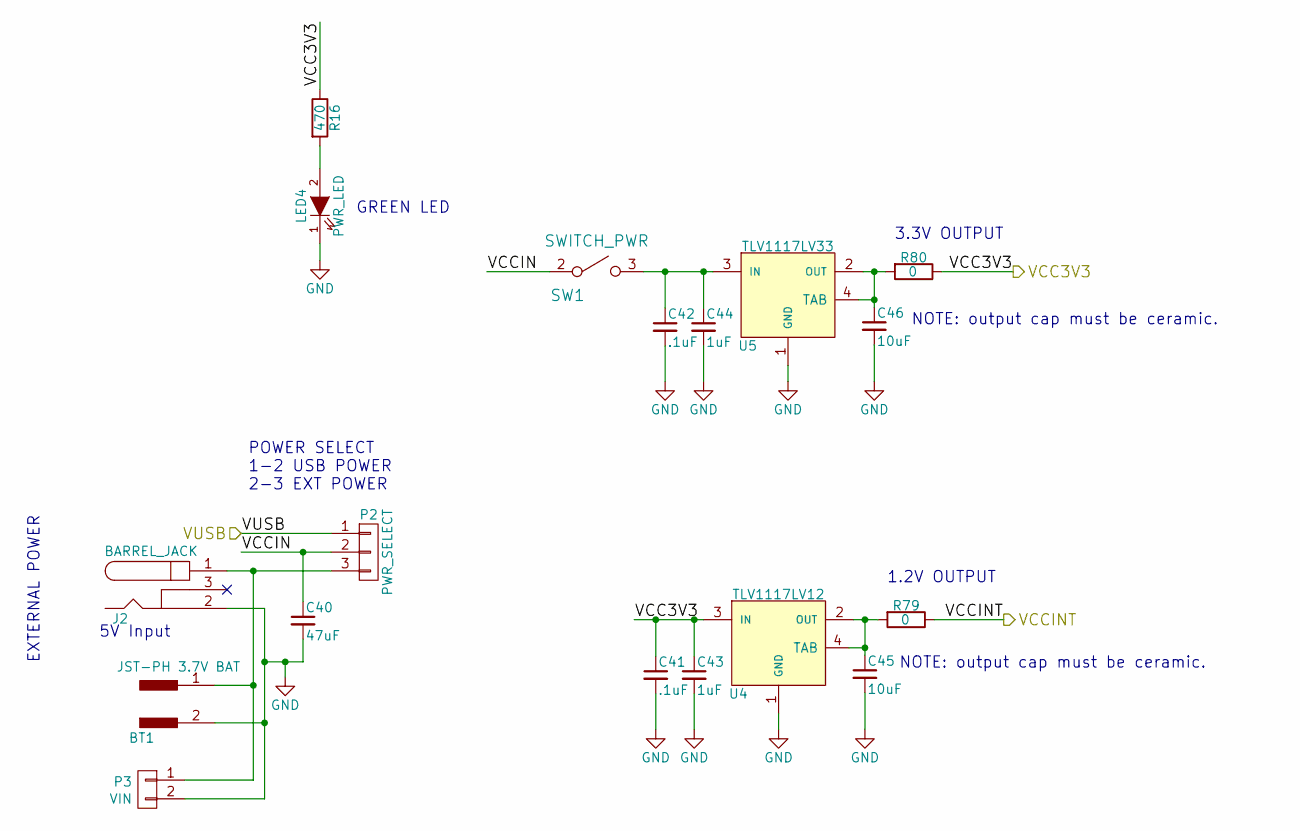
[picture p20: schematic power.sch]

Parts:
BT1: JST-PH 3.7V BAT; JST_PH_S2B-PH-K_02x2.00mm
C40: 47uF; C_1210
C41, C42: .1uF; C_0603
C43, C44: 1uF; C_0603
C45, C46: 10uF; C_1206
J2: BARREL_JACK; Barrel_Jack_PJ002A
LED4: PWR_LED; LED_0603
P2: PWR_SELECT; Pin_Header_Straight_1x03
P3: VIN; Pin_Header_Straight_1x02
R16: 470; R_0603
R79, R80: 0; R_1206
SW1: SWITCH_PWR; SWITCH_SPDT_EG1224
U4: TLV1117LV12; SOT-223
U5: TLV1117LV33; SOT-223

Connections:
/fpga/VCC3V3: C41.1, C43.1, R16.1, R80.1, U4.3 (IN); also elsewhere on the board
/fpga/VCCINT: R79.1; also elsewhere on the board
/power/VCCIN: C40.1, P2.2, SW1.2
/power/VUSB: P2.1; also elsewhere on the board
GND: BT1.2, C40.2, C41.2, C42.2, C43.2, C44.2, C45.2, C46.2, J2.2, LED4.1 (K), P3.2, U4.1 (GND), U5.1 (GND); also elsewhere on the board
unnamed: BT1.1, J2.1, P2.3, P3.1
unnamed: C42.1, C44.1, SW1.3, U5.3 (IN)
unnamed: C45.1, R79.2, U4.2 (OUT), U4.4 (TAB)
unnamed: C46.1, R80.2, U5.2 (OUT), U5.4 (TAB)
unnamed: LED4.2 (A), R16.2

Notes on the sheet:
POWER SELECT 1-2 USB POWER 2-3 EXT POWER
EXTERNAL POWER
1.2V OUTPUT
3.3V OUTPUT
NOTE: output cap must be ceramic.
GREEN LED
5V Input

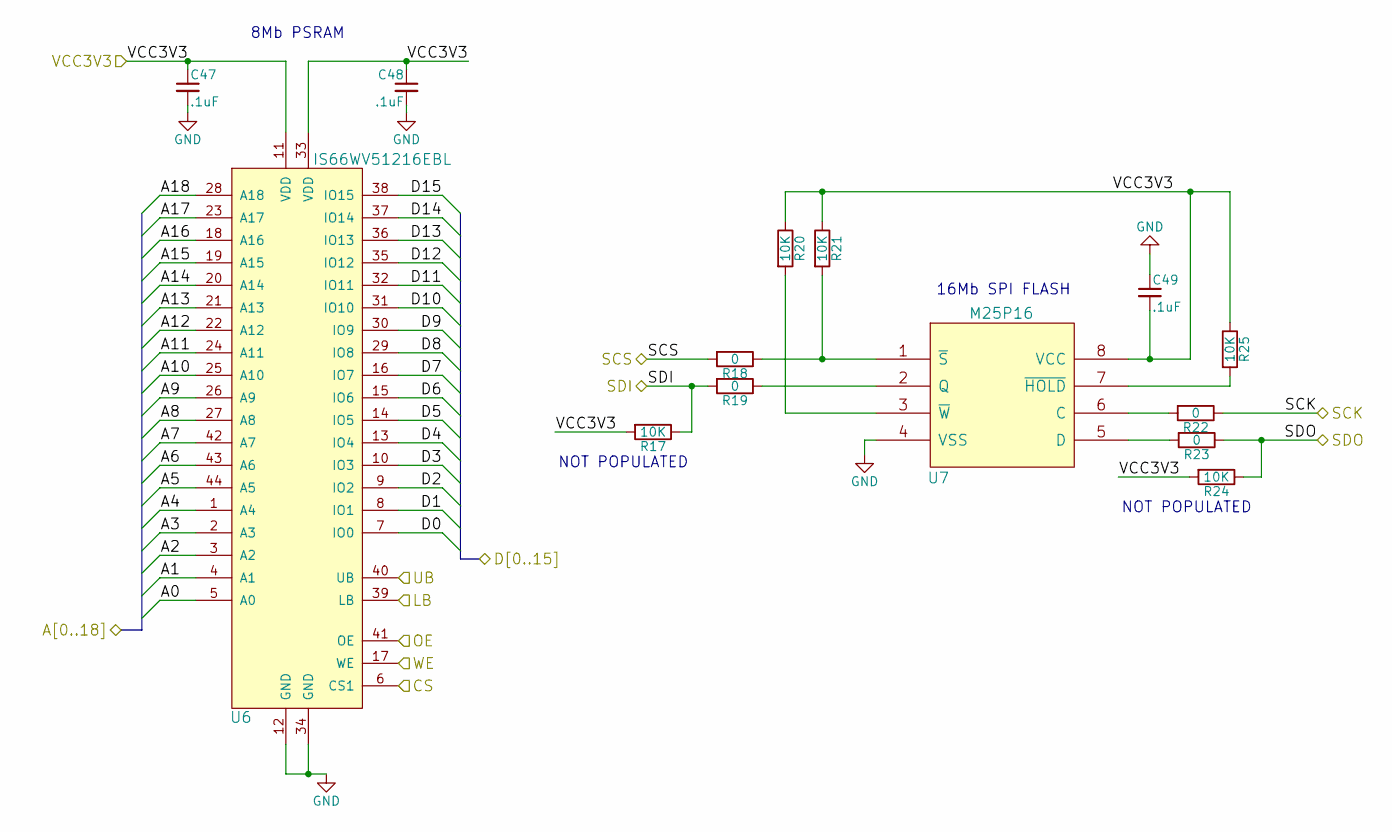
[picture p21: schematic memory.sch]

Parts:
C47, C48, C49: .1uF; C_0603
R17, R20, R21, R24, R25: 10K; R_0603
R18, R19, R22, R23: 0; R_0603
U6: IS66WV51216EBL; tsop2-44
U7: M25P16; SOIJ-8_5.3x5.3mm_Pitch1.27mm

Connections:
/fpga/A0: U6.5 (A0); also elsewhere on the board
/fpga/A1: U6.4 (A1); also elsewhere on the board
/fpga/A2: U6.3 (A2); also elsewhere on the board
/fpga/A3: U6.2 (A3); also elsewhere on the board
/fpga/A4: U6.1 (A4); also elsewhere on the board
/fpga/A5: U6.44 (A5); also elsewhere on the board
/fpga/A6: U6.43 (A6); also elsewhere on the board
/fpga/A7: U6.42 (A7); also elsewhere on the board
/fpga/A8: U6.27 (A8); also elsewhere on the board
/fpga/A9: U6.26 (A9); also elsewhere on the board
/fpga/A10: U6.25 (A10); also elsewhere on the board
/fpga/A11: U6.24 (A11); also elsewhere on the board
/fpga/A12: U6.22 (A12); also elsewhere on the board
/fpga/A13: U6.21 (A13); also elsewhere on the board
/fpga/A14: U6.20 (A14); also elsewhere on the board
/fpga/A15: U6.19 (A15); also elsewhere on the board
/fpga/A16: U6.18 (A16); also elsewhere on the board
/fpga/A17: U6.23 (A17); also elsewhere on the board
/fpga/A18: U6.28 (A18); also elsewhere on the board
/fpga/CS: U6.6 (CS1); also elsewhere on the board
/fpga/D0: U6.7 (IO0); also elsewhere on the board
/fpga/D1: U6.8 (IO1); also elsewhere on the board
/fpga/D2: U6.9 (IO2); also elsewhere on the board
/fpga/D3: U6.10 (IO3); also elsewhere on the board
/fpga/D4: U6.13 (IO4); also elsewhere on the board
/fpga/D5: U6.14 (IO5); also elsewhere on the board
/fpga/D6: U6.15 (IO6); also elsewhere on the board
/fpga/D7: U6.16 (IO7); also elsewhere on the board
/fpga/D8: U6.29 (IO8); also elsewhere on the board
/fpga/D9: U6.30 (IO9); also elsewhere on the board
/fpga/D10: U6.31 (IO10); also elsewhere on the board
/fpga/D11: U6.32 (IO11); also elsewhere on the board
/fpga/D12: U6.35 (IO12); also elsewhere on the board
/fpga/D13: U6.36 (IO13); also elsewhere on the board
/fpga/D14: U6.37 (IO14); also elsewhere on the board
/fpga/D15: U6.38 (IO15); also elsewhere on the board
/fpga/LB: U6.39 (LB); also elsewhere on the board
/fpga/OE: U6.41 (OE); also elsewhere on the board
/fpga/SCK: R22.1; also elsewhere on the board
/fpga/SCS: R18.2; also elsewhere on the board
/fpga/SDI: R17.1, R19.2; also elsewhere on the board
/fpga/SDO: R23.1, R24.1; also elsewhere on the board
/fpga/UB: U6.40 (UB); also elsewhere on the board
/fpga/VCC3V3: C47.1, C48.1, C49.2, R17.2, R20.1, R21.1, R24.2, R25.1, U6.11 (VDD), U6.33 (VDD), U7.8 (VCC); also elsewhere on the board
/fpga/WE: U6.17 (WE); also elsewhere on the board
GND: C47.2, C48.2, C49.1, U6.12 (GND), U6.34 (GND), U7.4 (VSS); also elsewhere on the board
unnamed: R18.1, R21.2, U7.1 (~S)
unnamed: R19.1, U7.2 (Q)
unnamed: R20.2, U7.3 (~W)
unnamed: R22.2, U7.6 (C)
unnamed: R23.2, U7.5 (D)
unnamed: R25.2, U7.7 (~HOLD)

Notes on the sheet:
8Mb PSRAM
16Mb SPI FLASH
NOT POPULATED

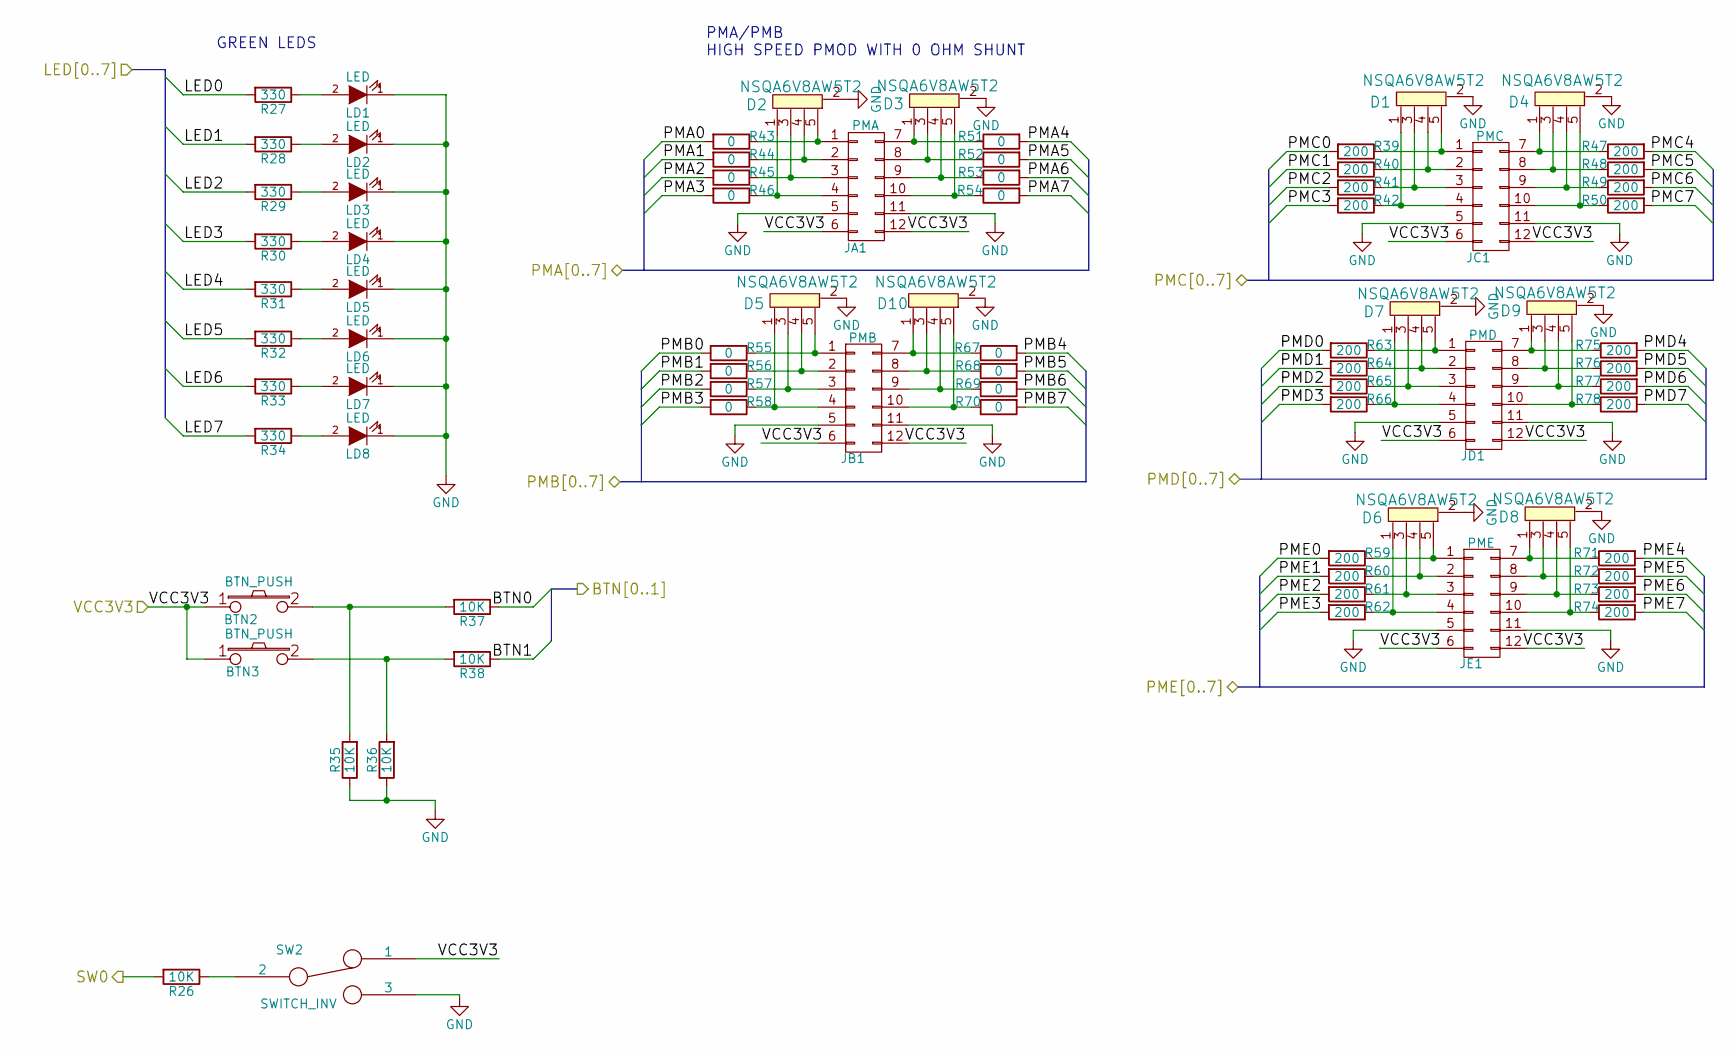
[picture p22: schematic gpio.sch]

Parts:
BTN2, BTN3: BTN_PUSH; SWITCH_1825966_1
D1, D2, D3, D4, D5, D6, D7, D8, D9, D10: NSQA6V8AW5T2; SOT323_5_NSQA6V8AW5T2
JA1: PMA; Socket_Strip_Angled_2x06_PMOD
JB1: PMB; Socket_Strip_Angled_2x06_PMOD
JC1: PMC; Socket_Strip_Angled_2x06_PMOD
JD1: PMD; Socket_Strip_Angled_2x06_PMOD
JE1: PME; Socket_Strip_Angled_2x06_PMOD
LD1, LD2, LD3, LD4, LD5, LD6, LD7, LD8: LED; LED_0603
R26, R35, R36, R37, R38: 10K; R_0603
R27, R28, R29, R30, R31, R32, R33, R34: 330; R_0603
R39, R40, R41, R42, R47, R48, R49, R50, R59, R60, R61, R62, R63, R64, R65, R66, R71, R72, R73, R74, R75, R76, R77, R78: 200; R_0603
R43, R44, R45, R46, R51, R52, R53, R54, R55, R56, R57, R58, R67, R68, R69, R70: 0; R_0603
SW2: SWITCH_INV; SWITCH_SPDT_OS102011MA1QN1

Connections:
/fpga/BTN0: R37.1; also elsewhere on the board
/fpga/BTN1: R38.1; also elsewhere on the board
/fpga/LED0: R27.2; also elsewhere on the board
/fpga/LED1: R28.2; also elsewhere on the board
/fpga/LED2: R29.2; also elsewhere on the board
/fpga/LED3: R30.2; also elsewhere on the board
/fpga/LED4: R31.2; also elsewhere on the board
/fpga/LED5: R32.2; also elsewhere on the board
/fpga/LED6: R33.2; also elsewhere on the board
/fpga/LED7: R34.2; also elsewhere on the board
/fpga/PMA0: R43.2; also elsewhere on the board
/fpga/PMA1: R44.2; also elsewhere on the board
/fpga/PMA2: R45.2; also elsewhere on the board
/fpga/PMA3: R46.2; also elsewhere on the board
/fpga/PMA4: R51.2; also elsewhere on the board
/fpga/PMA5: R52.2; also elsewhere on the board
/fpga/PMA6: R53.2; also elsewhere on the board
/fpga/PMA7: R54.2; also elsewhere on the board
/fpga/PMB0: R55.2; also elsewhere on the board
/fpga/PMB1: R56.2; also elsewhere on the board
/fpga/PMB2: R57.2; also elsewhere on the board
/fpga/PMB3: R58.2; also elsewhere on the board
/fpga/PMB4: R67.2; also elsewhere on the board
/fpga/PMB5: R68.2; also elsewhere on the board
/fpga/PMB6: R69.2; also elsewhere on the board
/fpga/PMB7: R70.2; also elsewhere on the board
/fpga/PMC0: R39.2; also elsewhere on the board
/fpga/PMC1: R40.2; also elsewhere on the board
/fpga/PMC2: R41.2; also elsewhere on the board
/fpga/PMC3: R42.2; also elsewhere on the board
/fpga/PMC4: R47.2; also elsewhere on the board
/fpga/PMC5: R48.2; also elsewhere on the board
/fpga/PMC6: R49.2; also elsewhere on the board
/fpga/PMC7: R50.2; also elsewhere on the board
/fpga/PMD0: R63.2; also elsewhere on the board
/fpga/PMD1: R64.2; also elsewhere on the board
/fpga/PMD2: R65.2; also elsewhere on the board
/fpga/PMD3: R66.2; also elsewhere on the board
/fpga/PMD4: R75.2; also elsewhere on the board
/fpga/PMD5: R76.2; also elsewhere on the board
/fpga/PMD6: R77.2; also elsewhere on the board
/fpga/PMD7: R78.2; also elsewhere on the board
/fpga/PME0: R59.2; also elsewhere on the board
/fpga/PME1: R60.2; also elsewhere on the board
/fpga/PME2: R61.2; also elsewhere on the board
/fpga/PME3: R62.2; also elsewhere on the board
/fpga/PME4: R71.2; also elsewhere on the board
/fpga/PME5: R72.2; also elsewhere on the board
/fpga/PME6: R73.2; also elsewhere on the board
/fpga/PME7: R74.2; also elsewhere on the board
/fpga/SW0: R26.2; also elsewhere on the board
/fpga/VCC3V3: BTN2.1, BTN3.1, JA1.6, JA1.12, JB1.6, JB1.12, JC1.6, JC1.12, JD1.6, JD1.12, JE1.6, JE1.12, SW2.1; also elsewhere on the board
GND: D1.2, D2.2, D3.2, D4.2, D5.2, D6.2, D7.2, D8.2, D9.2, D10.2, JA1.5, JA1.11, JB1.5, JB1.11, JC1.5, JC1.11, JD1.5, JD1.11, JE1.5, JE1.11, LD1.1 (K), LD2.1 (K), LD3.1 (K), LD4.1 (K), LD5.1 (K), LD6.1 (K), LD7.1 (K), LD8.1 (K), R35.1, R36.1, SW2.3; also elsewhere on the board
unnamed: BTN2.2, R35.2, R37.2
unnamed: BTN3.2, R36.2, R38.2
unnamed: D1.1, JC1.4, R42.1
unnamed: D1.3, JC1.3, R41.1
unnamed: D1.4, JC1.2, R40.1
unnamed: D1.5, JC1.1, R39.1
unnamed: D2.1, JA1.4, R46.1
unnamed: D2.3, JA1.3, R45.1
unnamed: D2.4, JA1.2, R44.1
unnamed: D2.5, JA1.1, R43.1
unnamed: D3.1, JA1.7, R51.1
unnamed: D3.3, JA1.8, R52.1
unnamed: D3.4, JA1.9, R53.1
unnamed: D3.5, JA1.10, R54.1
unnamed: D4.1, JC1.7, R47.1
unnamed: D4.3, JC1.8, R48.1
unnamed: D4.4, JC1.9, R49.1
unnamed: D4.5, JC1.10, R50.1
unnamed: D5.1, JB1.4, R58.1
unnamed: D5.3, JB1.3, R57.1
unnamed: D5.4, JB1.2, R56.1
unnamed: D5.5, JB1.1, R55.1
unnamed: D6.1, JE1.4, R62.1
unnamed: D6.3, JE1.3, R61.1
unnamed: D6.4, JE1.2, R60.1
unnamed: D6.5, JE1.1, R59.1
unnamed: D7.1, JD1.4, R66.1
unnamed: D7.3, JD1.3, R65.1
unnamed: D7.4, JD1.2, R64.1
unnamed: D7.5, JD1.1, R63.1
unnamed: D8.1, JE1.7, R71.1
unnamed: D8.3, JE1.8, R72.1
unnamed: D8.4, JE1.9, R73.1
unnamed: D8.5, JE1.10, R74.1
unnamed: D9.1, JD1.7, R75.1
unnamed: D9.3, JD1.8, R76.1
unnamed: D9.4, JD1.9, R77.1
unnamed: D9.5, JD1.10, R78.1
unnamed: D10.1, JB1.7, R67.1
unnamed: D10.3, JB1.8, R68.1
unnamed: D10.4, JB1.9, R69.1
unnamed: D10.5, JB1.10, R70.1
unnamed: LD1.2 (A), R27.1
unnamed: LD2.2 (A), R28.1
unnamed: LD3.2 (A), R29.1
unnamed: LD4.2 (A), R30.1
unnamed: LD5.2 (A), R31.1
unnamed: LD6.2 (A), R32.1
unnamed: LD7.2 (A), R33.1
unnamed: LD8.2 (A), R34.1
unnamed: R26.1, SW2.2

Notes on the sheet:
GREEN LEDS
PMA/PMB HIGH SPEED PMOD WITH 0 OHM SHUNT
