jonthomasson/SpartanMini/rev1.d (with shield 3d)/Spartan6Dev.kicad_pcb

## KiCad design rev1.d (with shield 3d)/Spartan6Dev.kicad_pcb (continued)

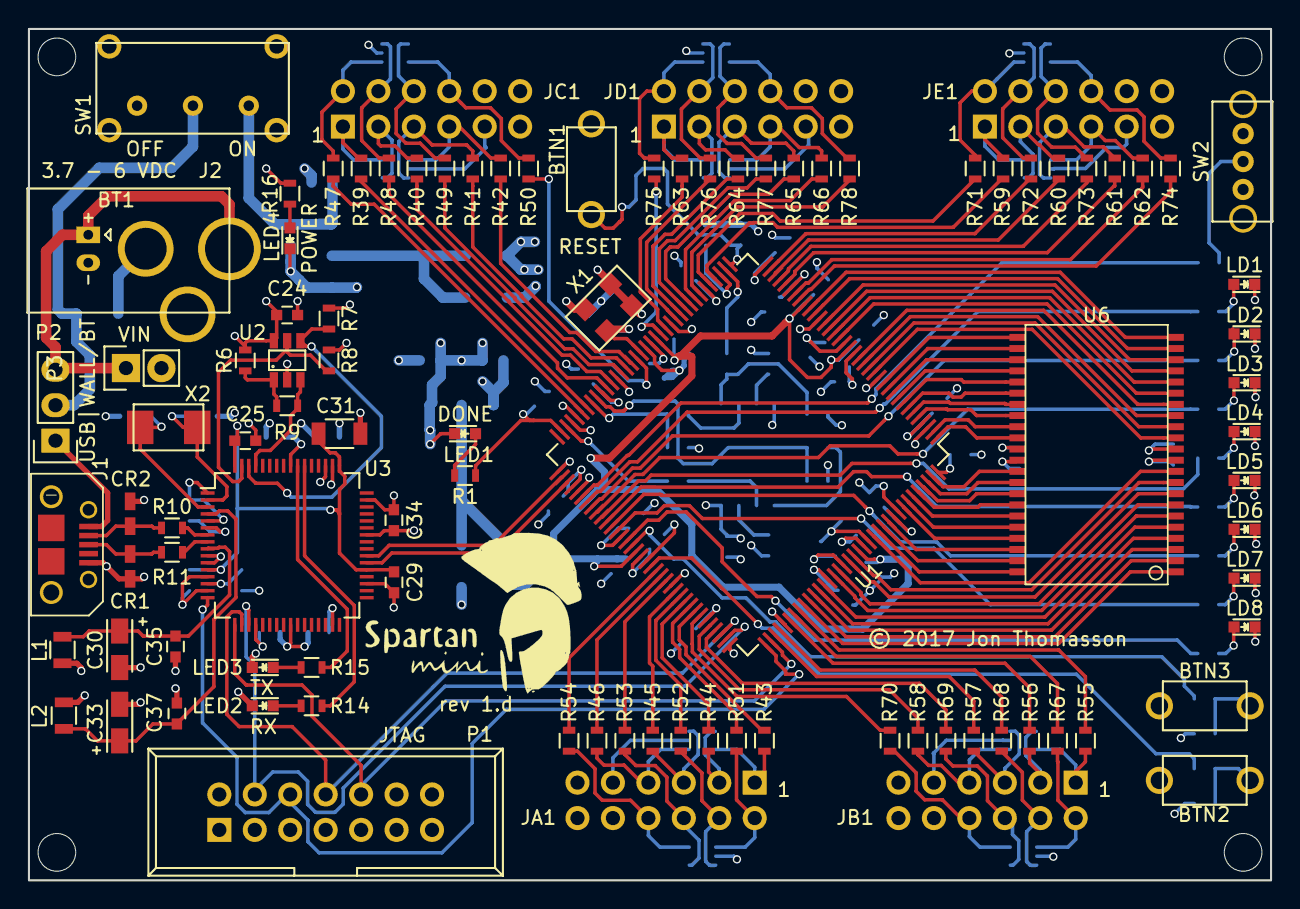
[picture p23: board Spartan6Dev.kicad_pcb from above]

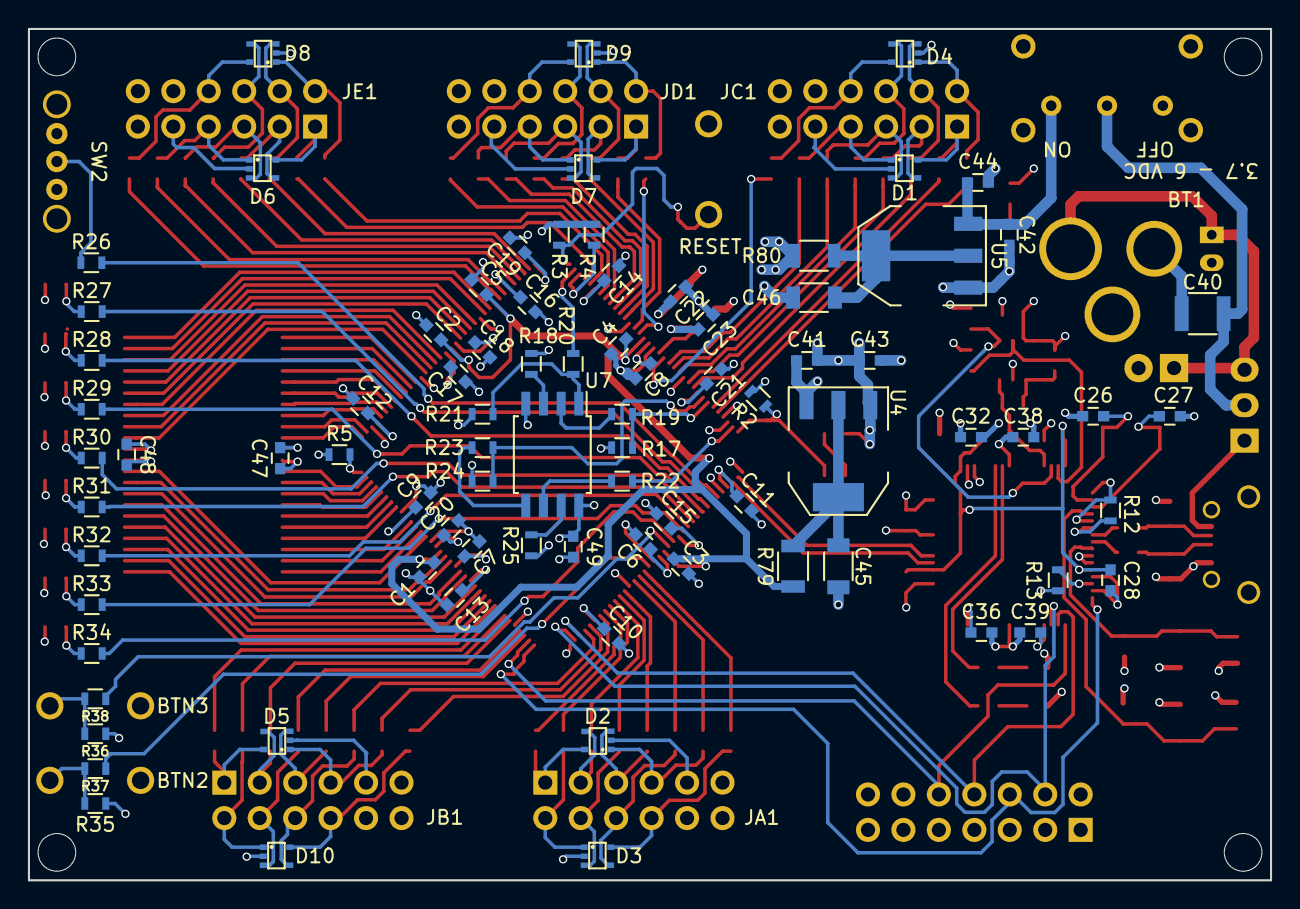
[picture p24: board Spartan6Dev.kicad_pcb from below]

Board: 4 copper layers, 89.0 x 61.0 mm, 180 parts (83 on the bottom side), 193 nets.
