jonthomasson/SpartanMini/rev1.d (with shield 3d)/Xilinx/pong_text/list_ch14_10_pong_top.v

// Listing 14.10
module pong_top
   (
    input wire clk, reset,
    input wire [1:0] btn,
    output wire hsync, vsync,
    output wire [2:0] rgb
   );

   // symbolic state declaration
   localparam  [1:0]
      newgame = 2'b00,
      play    = 2'b01,
      newball = 2'b10,
      over    = 2'b11;

   // signal declaration
   reg [1:0] state_reg, state_next;
   wire [9:0] pixel_x, pixel_y;
   wire video_on, pixel_tick, graph_on, hit, miss;
   wire [3:0] text_on;
   wire [2:0] graph_rgb, text_rgb;
   reg [2:0] rgb_reg, rgb_next;
   wire [3:0] dig0, dig1;
   reg gra_still, d_inc, d_clr, timer_start;
   wire timer_tick, timer_up;
   reg [1:0] ball_reg, ball_next;
	reg master_clk; //50mhz clock

   //=======================================================
   // instantiation
   //=======================================================
   // instantiate video synchronization unit
   vga_sync vsync_unit
      (.clk(master_clk), .reset(reset), .hsync(hsync), .vsync(vsync),
       .video_on(video_on), .p_tick(pixel_tick),
       .pixel_x(pixel_x), .pixel_y(pixel_y));
   // instantiate text module
   pong_text text_unit
      (.clk(master_clk),
       .pix_x(pixel_x), .pix_y(pixel_y),
       .dig0(dig0), .dig1(dig1), .ball(ball_reg),
       .text_on(text_on), .text_rgb(text_rgb));
   // instantiate graph module
   pong_graph graph_unit
      (.clk(master_clk), .reset(reset), .btn(btn),
       .pix_x(pixel_x), .pix_y(pixel_y),
       .gra_still(gra_still), .hit(hit), .miss(miss),
       .graph_on(graph_on), .graph_rgb(graph_rgb));
   // instantiate 2 sec timer
   // 60 Hz tick
   assign timer_tick = (pixel_x==0) && (pixel_y==0);
   timer timer_unit
      (.clk(master_clk), .reset(reset), .timer_tick(timer_tick),
       .timer_start(timer_start), .timer_up(timer_up));
   // instantiate 2-digit decade counter
   m100_counter counter_unit
      (.clk(master_clk), .reset(reset), .d_inc(d_inc), .d_clr(d_clr),
       .dig0(dig0), .dig1(dig1));
   //=======================================================
   // FSMD
   //=======================================================
   // FSMD state & data registers
    always @(posedge clk, posedge reset)
       if (reset)
          begin
             state_reg <= newgame;
             ball_reg <= 0;
             rgb_reg <= 0;
          end
       else
          begin
            state_reg <= state_next;
            ball_reg <= ball_next;
            if (pixel_tick)
               rgb_reg <= rgb_next;
          end
   // FSMD next-state logic
   always @*
   begin
      gra_still = 1'b1;
      timer_start = 1'b0;
      d_inc = 1'b0;
      d_clr = 1'b0;
      state_next = state_reg;
      ball_next = ball_reg;
      case (state_reg)
         newgame:
            begin
               ball_next = 2'b11; // three balls
               d_clr = 1'b1;      // clear score
               if (btn != 2'b00)  // button pressed
                  begin
                     state_next = play;
                     ball_next = ball_reg - 1;
                  end
            end
         play:
            begin
               gra_still = 1'b0;  // animated screen
               if (hit)
                  d_inc = 1'b1;   // increment score
               else if (miss)
                  begin
                     if (ball_reg==0)
                        state_next = over;
                     else
                        state_next = newball;
                     timer_start = 1'b1;  // 2 sec timer
                     ball_next = ball_reg - 1;
                  end
            end
         newball:
            // wait for 2 sec and until button pressed
            if (timer_up && (btn != 2'b00))
                state_next = play;
         over:
            // wait for 2 sec to display game over
            if (timer_up)
                state_next = newgame;
       endcase
    end
   //=======================================================
   // rgb multiplexing circuit
   //=======================================================
   always @*
      if (~video_on)
         rgb_next = "000"; // blank the edge/retrace
      else
         // display score, rule, or game over
         if (text_on[3] ||
               ((state_reg==newgame) && text_on[1]) || // rule
               ((state_reg==over) && text_on[0]))
            rgb_next = text_rgb;
         else if (graph_on)  // display graph
           rgb_next = graph_rgb;
         else if (text_on[2]) // display logo
           rgb_next = text_rgb;
         else
           rgb_next = 3'b110; // yellow background
			  
	always @(posedge clk)
      master_clk <= master_clk + 1;
	
   // output
   assign rgb = rgb_reg;
endmodule
