jonthomasson/SpartanMini/rev1.d (with shield 3d)/Xilinx/default-config.ucf

## This file is a general .ucf for the Spartan Mini rev 1.d board
## To use it in a project:
## - remove or comment the lines corresponding to unused pins
## - rename the used signals according to the project

##========================================================
## Clock signal
##========================================================
NET "clk" TNM_NET = clk;
TIMESPEC TS_clk = PERIOD "clk" 100 MHz HIGH 50%;

NET "clk"    LOC = P55;

##=========================================================
## 1 slide switch
##==========================================================			
#NET "sw1"  LOC = P78;

##========================================================
## Buttons
##========================================================
#NET "btn_n<0>"   LOC = P92;	
#NET "btn_n<1>"   LOC = P88;
#NET "reset_n"  	LOC = P37;	

##========================================================
## Usb-RS232 interface
##========================================================
#NET "Tx"  LOC = P74	| IOSTANDARD = "LVCMOS33"; 	
#NET "Rx"  LOC = P75	| IOSTANDARD = "LVCMOS33"; 	

##========================================================
## programmable leds
##========================================================
#NET "led<0>"  LOC = P79	| IOSTANDARD = "LVCMOS33"; 	
#NET "led<1>"  LOC = P80	| IOSTANDARD = "LVCMOS33"; 	
#NET "led<2>"  LOC = P81	| IOSTANDARD = "LVCMOS33"; 
#NET "led<3>"  LOC = P82	| IOSTANDARD = "LVCMOS33"; 	
#NET "led<4>"  LOC = P83	| IOSTANDARD = "LVCMOS33"; 
#NET "led<5>"  LOC = P84	| IOSTANDARD = "LVCMOS33"; 
#NET "led<6>"  LOC = P85	| IOSTANDARD = "LVCMOS33"; 
#NET "led<7>"  LOC = P87	| IOSTANDARD = "LVCMOS33"; 

##========================================================
## PSRAM 8Mb
##========================================================
#NET "MemAdr<0>"  LOC = P121	| IOSTANDARD = "LVCMOS33"; 	
#NET "MemAdr<1>"  LOC = P120	| IOSTANDARD = "LVCMOS33"; 	
#NET "MemAdr<2>"  LOC = P119	| IOSTANDARD = "LVCMOS33"; 	
#NET "MemAdr<3>"  LOC = P118	| IOSTANDARD = "LVCMOS33"; 	
#NET "MemAdr<4>"  LOC = P117	| IOSTANDARD = "LVCMOS33"; 	
#NET "MemAdr<5>"  LOC = P132	| IOSTANDARD = "LVCMOS33"; 	
#NET "MemAdr<6>"  LOC = P133	| IOSTANDARD = "LVCMOS33"; 	
#NET "MemAdr<7>"  LOC = P134	| IOSTANDARD = "LVCMOS33"; 	
#NET "MemAdr<8>"  LOC = P8	| IOSTANDARD = "LVCMOS33"; 	
#NET "MemAdr<9>"  LOC = P9	| IOSTANDARD = "LVCMOS33"; 	
#NET "MemAdr<10>"  LOC = P10	| IOSTANDARD = "LVCMOS33"; 	
#NET "MemAdr<11>"  LOC = P11	| IOSTANDARD = "LVCMOS33"; 	
#NET "MemAdr<12>"  LOC = P27	| IOSTANDARD = "LVCMOS33"; 	
#NET "MemAdr<13>"  LOC = P26	| IOSTANDARD = "LVCMOS33"; 	
#NET "MemAdr<14>"  LOC = P24	| IOSTANDARD = "LVCMOS33"; 	
#NET "MemAdr<15>"  LOC = P23	| IOSTANDARD = "LVCMOS33"; 	
#NET "MemAdr<16>"  LOC = P22	| IOSTANDARD = "LVCMOS33"; 	
#NET "MemAdr<17>"  LOC = P12	| IOSTANDARD = "LVCMOS33"; 	
#NET "MemAdr<18>"  LOC = P7	| IOSTANDARD = "LVCMOS33"; 	

#NET "MemDB<0>"  LOC = P124	| IOSTANDARD = "LVCMOS33"; 	
#NET "MemDB<1>"  LOC = P126	| IOSTANDARD = "LVCMOS33"; 	
#NET "MemDB<2>"  LOC = P127	| IOSTANDARD = "LVCMOS33"; 	
#NET "MemDB<3>"  LOC = P131	| IOSTANDARD = "LVCMOS33"; 	
#NET "MemDB<4>"  LOC = P14	| IOSTANDARD = "LVCMOS33"; 	
#NET "MemDB<5>"  LOC = P15	| IOSTANDARD = "LVCMOS33"; 	
#NET "MemDB<6>"  LOC = P16	| IOSTANDARD = "LVCMOS33"; 	
#NET "MemDB<7>"  LOC = P17	| IOSTANDARD = "LVCMOS33"; 	
#NET "MemDB<8>"  LOC = P6	| IOSTANDARD = "LVCMOS33"; 	
#NET "MemDB<9>"  LOC = P5	| IOSTANDARD = "LVCMOS33"; 	
#NET "MemDB<10>"  LOC = P2	| IOSTANDARD = "LVCMOS33"; 	
#NET "MemDB<11>"  LOC = P1	| IOSTANDARD = "LVCMOS33"; 	
#NET "MemDB<12>"  LOC = P143	| IOSTANDARD = "LVCMOS33"; 	
#NET "MemDB<13>"  LOC = P142	| IOSTANDARD = "LVCMOS33"; 	
#NET "MemDB<14>"  LOC = P141	| IOSTANDARD = "LVCMOS33"; 	
#NET "MemDB<15>"  LOC = P140	| IOSTANDARD = "LVCMOS33"; 	

#NET "RamUB"  LOC = P138	| IOSTANDARD = "LVCMOS33"; 	
#NET "RamLB"  LOC = P139	| IOSTANDARD = "LVCMOS33"; 	
#NET "MemOE"  LOC = P137	| IOSTANDARD = "LVCMOS33"; 	
#NET "MemWR"  LOC = P21	| IOSTANDARD = "LVCMOS33"; 	
#NET "RamCS"  LOC = P123	| IOSTANDARD = "LVCMOS33"; 	

##========================================================
## 16Mb SPI Flash
##========================================================
#NET "SCS"  LOC = P38	| IOSTANDARD = "LVCMOS33"; 
#NET "SDI"  LOC = P65	| IOSTANDARD = "LVCMOS33"; 
#NET "SCK"  LOC = P70	| IOSTANDARD = "LVCMOS33"; 
#NET "SDO"  LOC = P64	| IOSTANDARD = "LVCMOS33"; 

##========================================================
## JA PMOD
##========================================================
#NET "JA<0>"  LOC = P101	| IOSTANDARD = "LVCMOS33"; 
#NET "JA<1>"  LOC = P99	| IOSTANDARD = "LVCMOS33"; 
#NET "JA<2>"  LOC = P97	| IOSTANDARD = "LVCMOS33"; 
#NET "JA<3>"  LOC = P94	| IOSTANDARD = "LVCMOS33"; 
#NET "JA<4>"  LOC = P100	| IOSTANDARD = "LVCMOS33"; 
#NET "JA<5>"  LOC = P98	| IOSTANDARD = "LVCMOS33"; 
#NET "JA<6>"  LOC = P95	| IOSTANDARD = "LVCMOS33"; 
#NET "JA<7>"  LOC = P93	| IOSTANDARD = "LVCMOS33"; 

##========================================================
## JB PMOD
##========================================================
#NET "JB<0>"  LOC = P116	| IOSTANDARD = "LVCMOS33"; 
#NET "JB<1>"  LOC = P114	| IOSTANDARD = "LVCMOS33"; 
#NET "JB<2>"  LOC = P111	| IOSTANDARD = "LVCMOS33"; 
#NET "JB<3>"  LOC = P104	| IOSTANDARD = "LVCMOS33"; 
#NET "JB<4>"  LOC = P115	| IOSTANDARD = "LVCMOS33"; 
#NET "JB<5>"  LOC = P112	| IOSTANDARD = "LVCMOS33"; 
#NET "JB<6>"  LOC = P105	| IOSTANDARD = "LVCMOS33"; 
#NET "JB<7>"  LOC = P102	| IOSTANDARD = "LVCMOS33"; 

##========================================================
## JC PMOD
##========================================================
#NET "JC<0>"  LOC = P66	| IOSTANDARD = "LVCMOS33"; 
#NET "JC<1>"  LOC = P61	| IOSTANDARD = "LVCMOS33"; 
#NET "JC<2>"  LOC = P58	| IOSTANDARD = "LVCMOS33"; 
#NET "JC<3>"  LOC = P57	| IOSTANDARD = "LVCMOS33"; 
#NET "JC<4>"  LOC = P67	| IOSTANDARD = "LVCMOS33"; 
#NET "JC<5>"  LOC = P62	| IOSTANDARD = "LVCMOS33"; 
#NET "JC<6>"  LOC = P59	| IOSTANDARD = "LVCMOS33"; 
#NET "JC<7>"  LOC = P56	| IOSTANDARD = "LVCMOS33"; 

##========================================================
## JD PMOD
##========================================================
#NET "JD<0>"  LOC = P50	| IOSTANDARD = "LVCMOS33"; 
#NET "JD<1>"  LOC = P47	| IOSTANDARD = "LVCMOS33"; 
#NET "JD<2>"  LOC = P45	| IOSTANDARD = "LVCMOS33"; 
#NET "JD<3>"  LOC = P44	| IOSTANDARD = "LVCMOS33"; 
#NET "JD<4>"  LOC = P51	| IOSTANDARD = "LVCMOS33"; 
#NET "JD<5>"  LOC = P48	| IOSTANDARD = "LVCMOS33"; 
#NET "JD<6>"  LOC = P46	| IOSTANDARD = "LVCMOS33"; 
#NET "JD<7>"  LOC = P43	| IOSTANDARD = "LVCMOS33"; 

##========================================================
## JE PMOD
##========================================================
#NET "JE<0>"  LOC = P40	| IOSTANDARD = "LVCMOS33"; 
#NET "JE<1>"  LOC = P34	| IOSTANDARD = "LVCMOS33"; 
#NET "JE<2>"  LOC = P32	| IOSTANDARD = "LVCMOS33"; 
#NET "JE<3>"  LOC = P30	| IOSTANDARD = "LVCMOS33"; 
#NET "JE<4>"  LOC = P41	| IOSTANDARD = "LVCMOS33"; 
#NET "JE<5>"  LOC = P35	| IOSTANDARD = "LVCMOS33"; 
#NET "JE<6>"  LOC = P33	| IOSTANDARD = "LVCMOS33"; 
#NET "JE<7>"  LOC = P29	| IOSTANDARD = "LVCMOS33"; 
