jonthomasson/SpartanMini/(commit log)

2017-04-24 added template project for creating shields and new logo icon in logo folder.
    [gpio.sch, spartanmini-shield.kicad_pcb, spartanmini-shield.sch]
2017-04-24 adding a second template project for power in addition to gpio.
    [gpio.sch, power.sch, spartanmini-shieldpower.kicad_pcb, spartanmini-shieldpower.sch]
2017-09-24 latest version with shield template and gerbers
    [10118194c.stp, 1825966-1.stp, 500SSPxS2M2xEA.stp, ABM3.STEP, IND_PGB_0603.stp, PTS810.stp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]
2017-10-13 default config files for usb and ise
    [examplegdb.cfg]
2017-11-11 added some sample xilinx projects
    [NES_Nexys4_pad.csv, blink_pad.csv, pong_top_pad.csv]
2017-11-15 some changes to propeller source for nes core
2017-11-17 finishing propeller serial upload program
2017-11-17 first working version using propeller for sd card/menu/game loading!
