jonthomasson/SpartanMini/(notices)

Notices in the files:
rev1.d (with shield 3d)/Spartan6Dev.kicad_pcb:
© 2017 Jon Thomasson
